ARoS-NCSU/WolfBot-Hardware/boards/power/webench_6V_LS3478.png

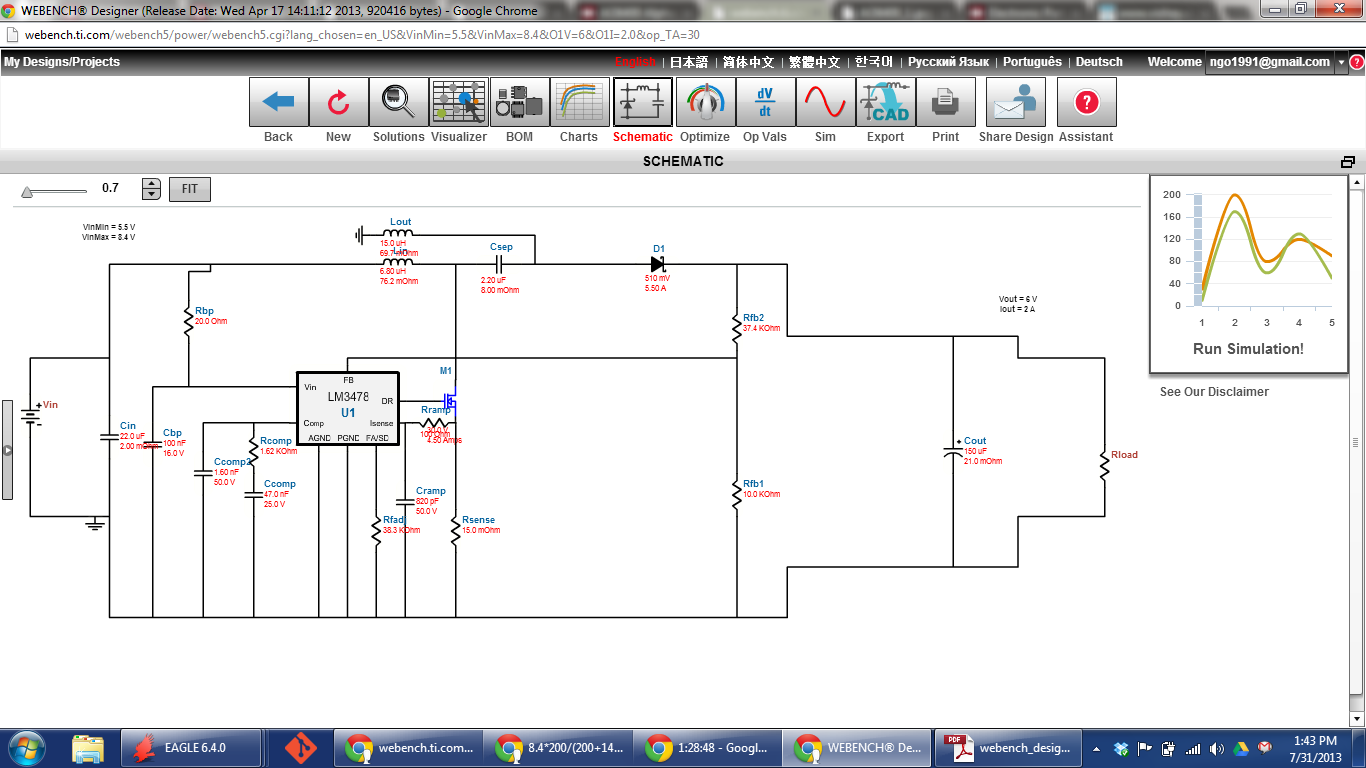
boards/power/webench_6V_LS3478.png
