ARoS-NCSU/WolfBot-Hardware/solidworks/Level 0/Robot Level 0 Assembly.SLDASM

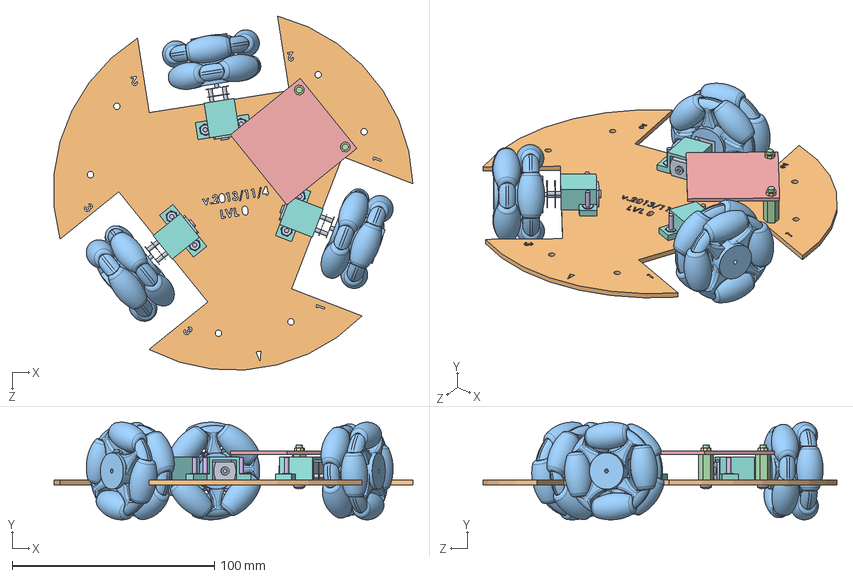
[picture p3: CAD file, 2013-11-22]
solidworks/Level 0/Robot Level 0 Assembly.SLDASM
177.4 x 48.3 x 174.9 mm
Drivetrain Motor x 3
Acrylic Base Type 0 - Level 0
Omnidirectional Wheel 1 x 3
Stand Off x 2
MotorBoard
pan cross head_ai x 8
Hex Nut x 2
Motor Bracket x 3
machine screw nut hex_ai x 6
