ARoS-NCSU/WolfBot-Hardware/solidworks/Level 1/Robot Level 1 Assembly.SLDASM

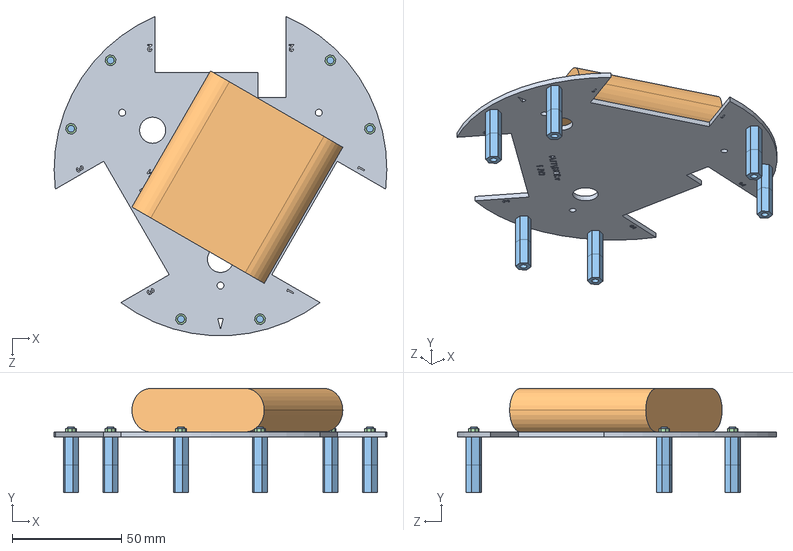
[picture p4: CAD file, 2013-11-22]
solidworks/Level 1/Robot Level 1 Assembly.SLDASM
152.4 x 47.8 x 146.1 mm
Acrylic Base Type 1 - Level 1
Battery
Stand Off x 12
Hex Nut x 6
