ARoS-NCSU/WolfBot-Hardware/solidworks/Level 2/DMS-Mount Assembly.SLDASM

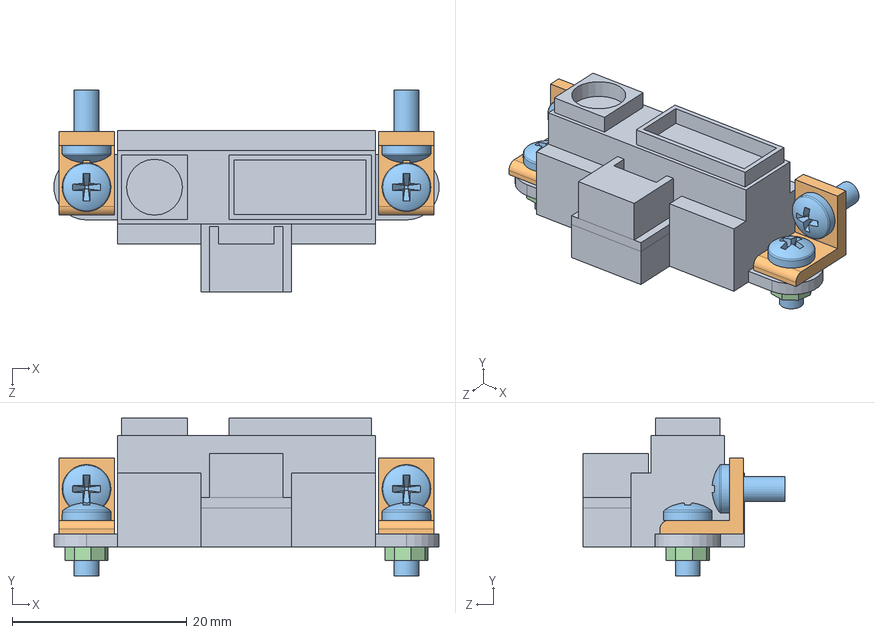
[picture p5: CAD file, 2013-11-22]
solidworks/Level 2/DMS-Mount Assembly.SLDASM
44.0 x 18.0 x 23.1 mm
DMS-80 IR
L-Bracket Mount x 2
pan cross head_ai x 4
Hex Nut x 2
