ARoS-NCSU/WolfBot-Hardware/solidworks/Robot Total Assembly.SLDASM

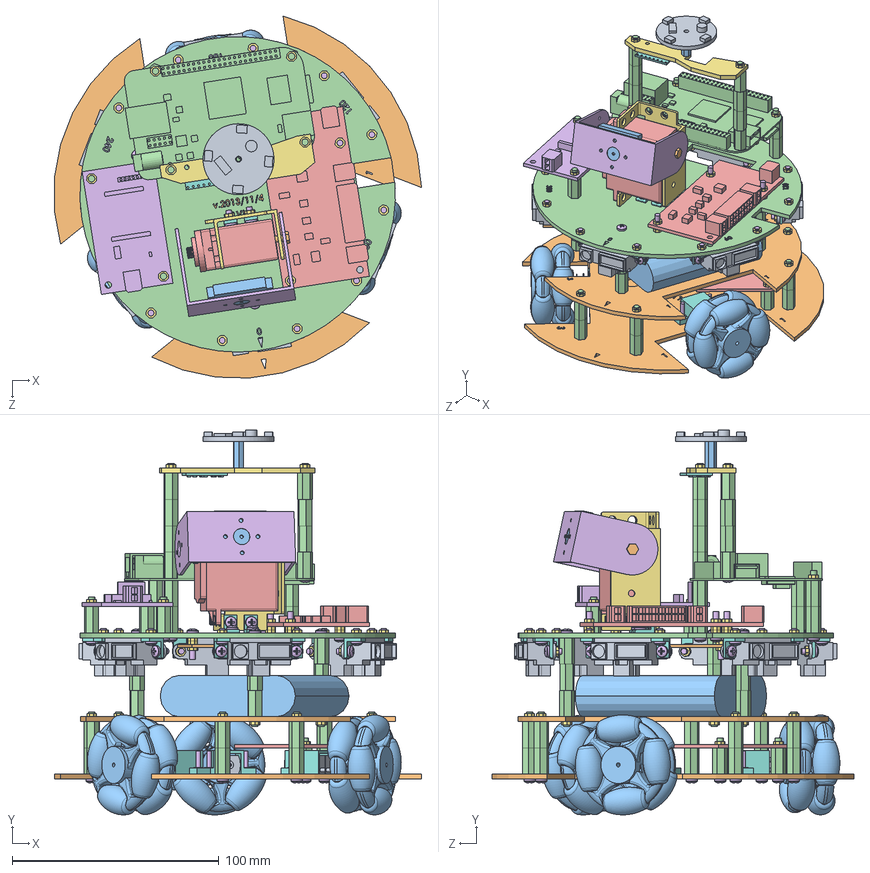
[picture p6: CAD file, 2013-11-22]
solidworks/Robot Total Assembly.SLDASM
177.4 x 185.9 x 174.9 mm
Drivetrain Motor x 3
Acrylic Base Type 0 - Level 0
Omnidirectional Wheel 1 x 3
Stand Off x 40
MotorBoard
pan cross head_ai x 56
Hex Nut x 60
Motor Bracket x 3
machine screw nut hex_ai x 6
Acrylic Base Type 1 - Level 1
Battery
Acrylic Base Type 1 - Level 2
Servo Motor
Servo Motor Assembly Part 1
Servo Motor Assembly Part 2
L-Bracket Mount x 14
DMS-80 IR x 6
Fastner
New_Camera
Beaglebone
Power Circuit Board
Xbee Base
Acrylic Base Type 2 - Level 2
3-axis accelerometer LSM303DLHC
New_IRSensor
DMS Board
Skinny Stand Off
