ARoS-NCSU/WolfBot-Hardware/solidworks/Level 2/Robot Level 2 Assembly.SLDASM

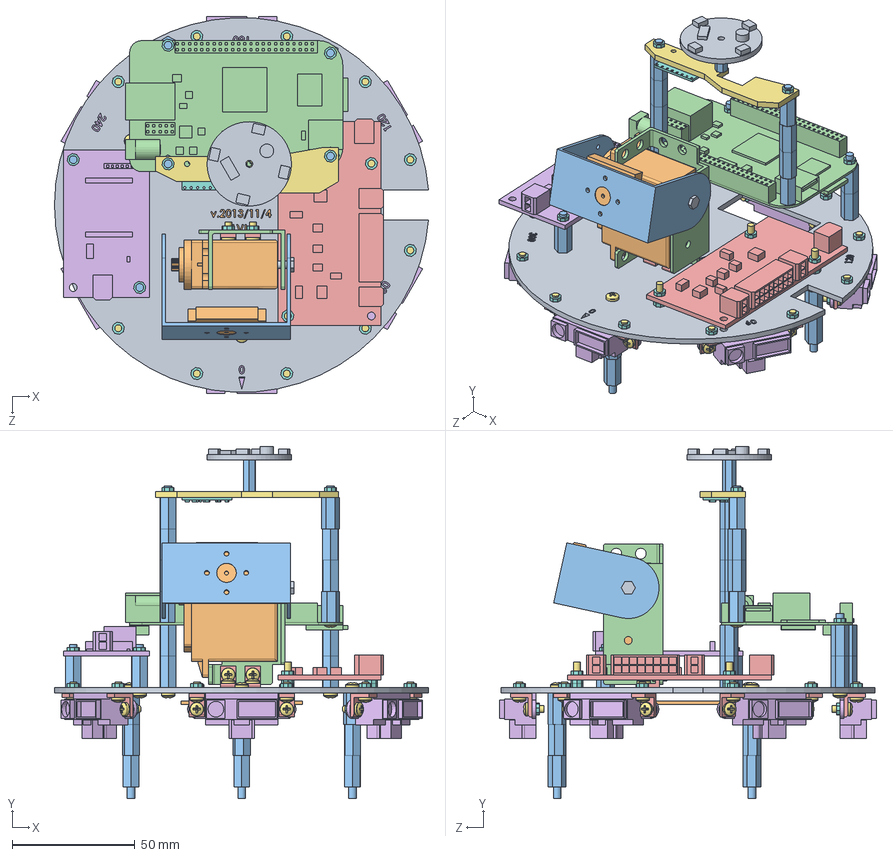
[picture p7: CAD file, 2013-11-22]
solidworks/Level 2/Robot Level 2 Assembly.SLDASM
152.2 x 143.2 x 153.3 mm
Acrylic Base Type 1 - Level 2
Servo Motor
Servo Motor Assembly Part 1
Servo Motor Assembly Part 2
L-Bracket Mount x 14
DMS-80 IR x 6
pan cross head_ai x 42
Hex Nut x 49
Fastner
New_Camera
Stand Off x 26
Beaglebone
Power Circuit Board
Xbee Base
Acrylic Base Type 2 - Level 2
3-axis accelerometer LSM303DLHC
New_IRSensor
DMS Board
Skinny Stand Off
