ARoS-NCSU/WolfBot-Hardware/solidworks/Level 2/Servo Motor Assembly Part 2.SLDPRT

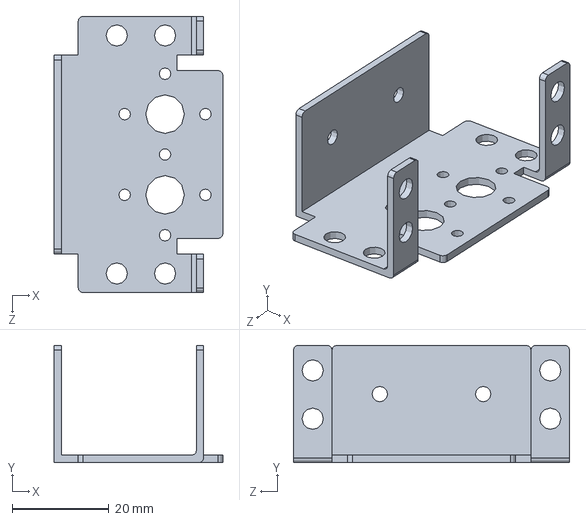
[picture p8: CAD file, 2013-11-14]
solidworks/Level 2/Servo Motor Assembly Part 2.SLDPRT
35.0 x 24.3 x 57.2 mm
