ARoS-NCSU/WolfBot-Hardware/solidworks/Level 2/Servo Motor Assembly Part 1.SLDPRT

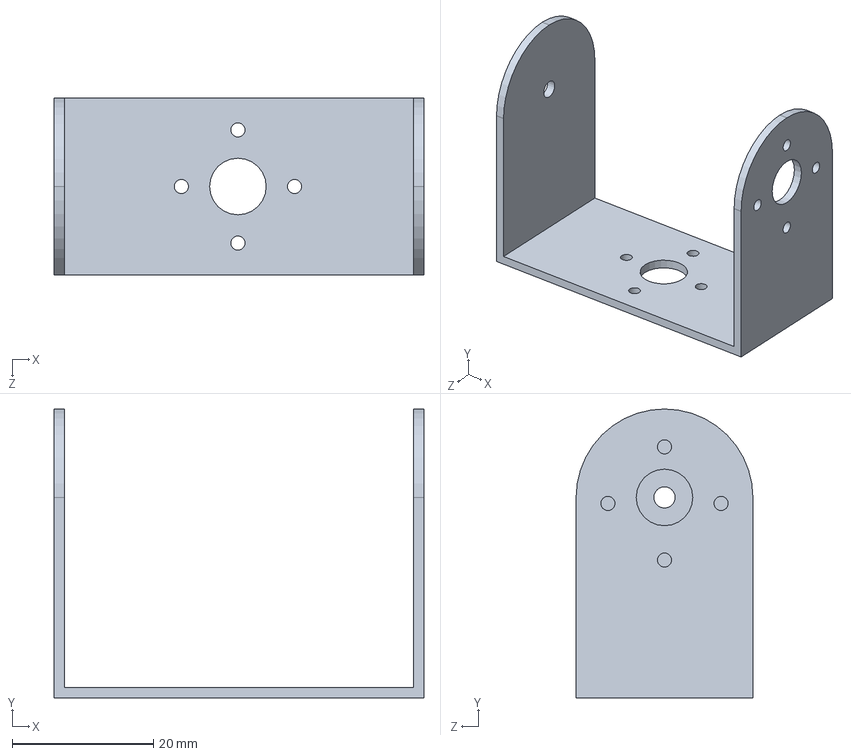
[picture p9: CAD file, 2013-11-14]
solidworks/Level 2/Servo Motor Assembly Part 1.SLDPRT
52.3 x 40.8 x 25.0 mm
