ARoS-NCSU/WolfBot-Hardware/solidworks/Common Parts/Skinny Stand Off.SLDPRT

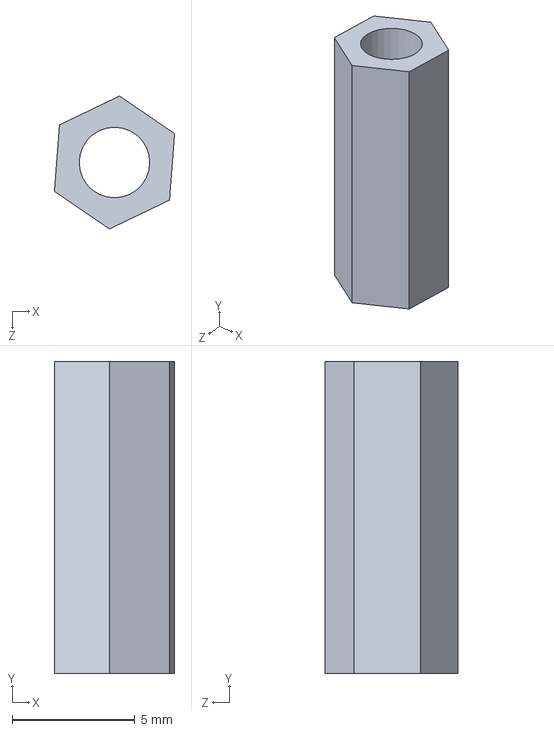
[picture p10: CAD file, 2013-11-22]
solidworks/Common Parts/Skinny Stand Off.SLDPRT
4.89 x 12.7 x 5.41 mm
