ARoS-NCSU/WolfBot-Hardware/solidworks/Level 0/Motor Bracket.SLDPRT

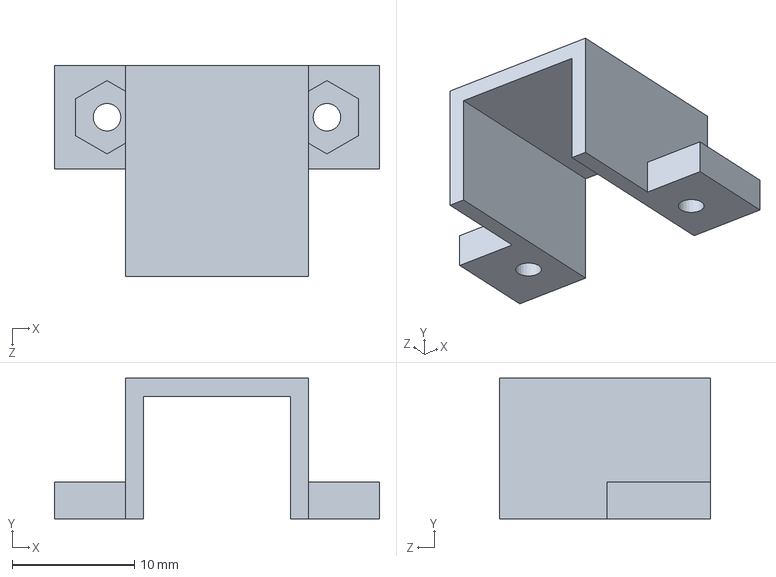
[picture p11: CAD file, 2013-11-22]
solidworks/Level 0/Motor Bracket.SLDPRT
26.6 x 11.5 x 17.3 mm
