ARoS-NCSU/WolfBot-Hardware/solidworks/Level 1/Battery.SLDPRT

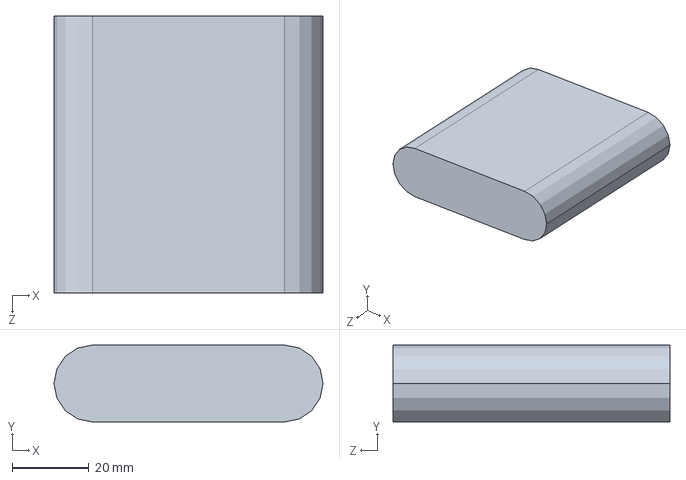
[picture p12: CAD file, 2013-11-14]
solidworks/Level 1/Battery.SLDPRT
70.0 x 20.0 x 72.0 mm
