ARoS-NCSU/WolfBot-Hardware/solidworks/Common Parts/Stand Off.SLDPRT

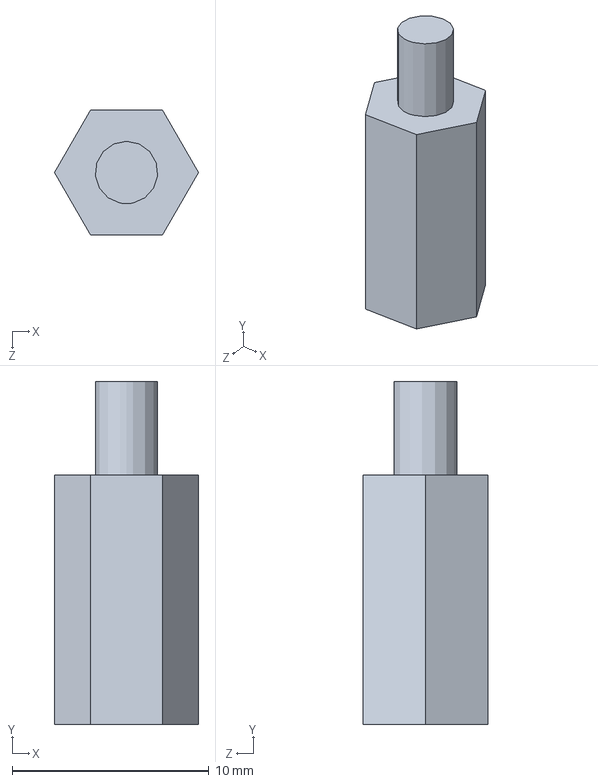
[picture p13: CAD file, 2013-11-14]
solidworks/Common Parts/Stand Off.SLDPRT
7.33 x 17.4 x 6.35 mm
