ARoS-NCSU/WolfBot-Hardware/solidworks/Level 1/Acrylic Base Type 1 - Level 1.SLDPRT

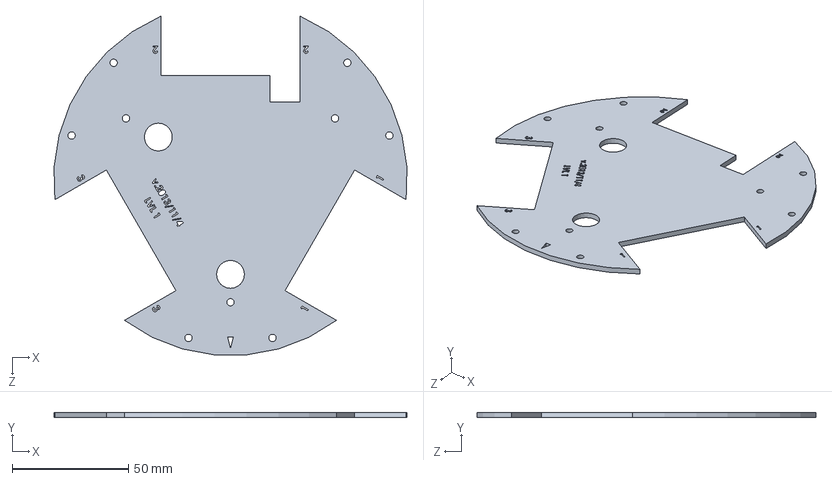
[picture p15: CAD file, 2013-11-14]
solidworks/Level 1/Acrylic Base Type 1 - Level 1.SLDPRT
152.1 x 2.36 x 145.9 mm
