ARoS-NCSU/WolfBot-Hardware/solidworks/Level 2/New_IRSensor.SLDPRT

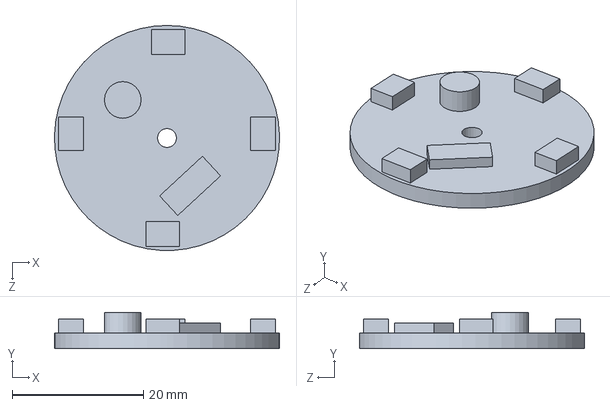
[picture p16: CAD file, 2013-11-14]
solidworks/Level 2/New_IRSensor.SLDPRT
34.3 x 5.56 x 34.3 mm
