ARoS-NCSU/WolfBot-Hardware/solidworks/Common Parts/Stand Off - Level 2 Lower.SLDPRT

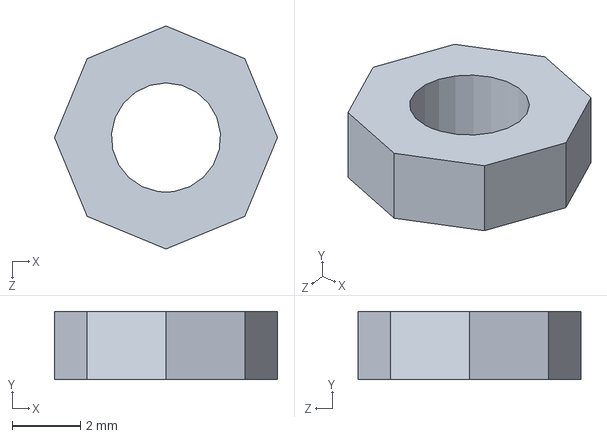
[picture p17: CAD file, 2013-11-14]
solidworks/Common Parts/Stand Off - Level 2 Lower.SLDPRT
6.53 x 2.00 x 6.53 mm
