ARoS-NCSU/WolfBot-Hardware/solidworks/Level 0/MotorBoard.SLDPRT

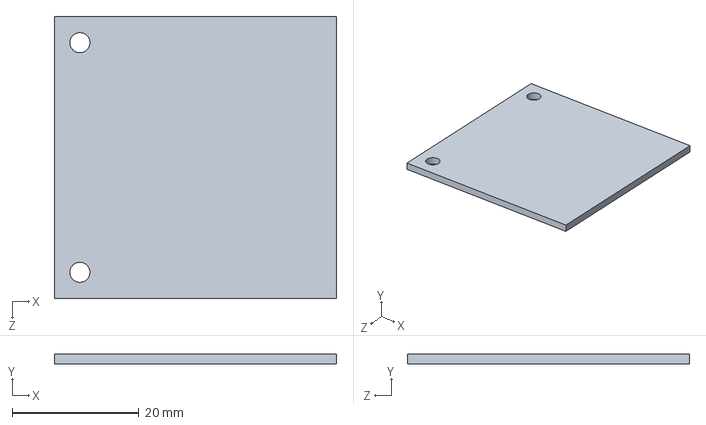
[picture p18: CAD file, 2013-11-14]
solidworks/Level 0/MotorBoard.SLDPRT
44.5 x 1.60 x 44.5 mm
