ARoS-NCSU/WolfBot-Hardware/solidworks/Level 2/DMS-80 IR.SLDPRT

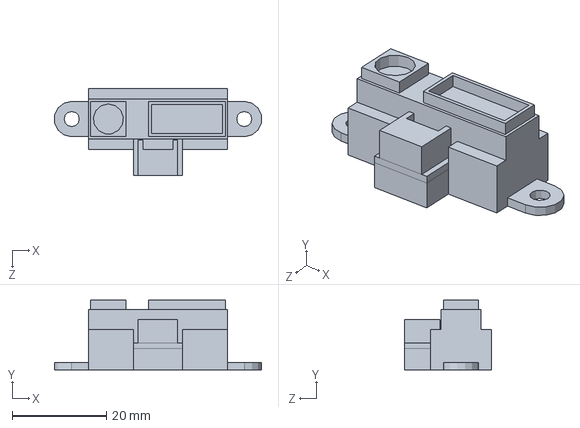
[picture p19: CAD file, 2013-11-14]
solidworks/Level 2/DMS-80 IR.SLDPRT
43.9 x 14.8 x 18.5 mm
