ARoS-NCSU/WolfBot-Hardware/solidworks/Common Parts/Stand Off - Level 2 Upper.SLDPRT

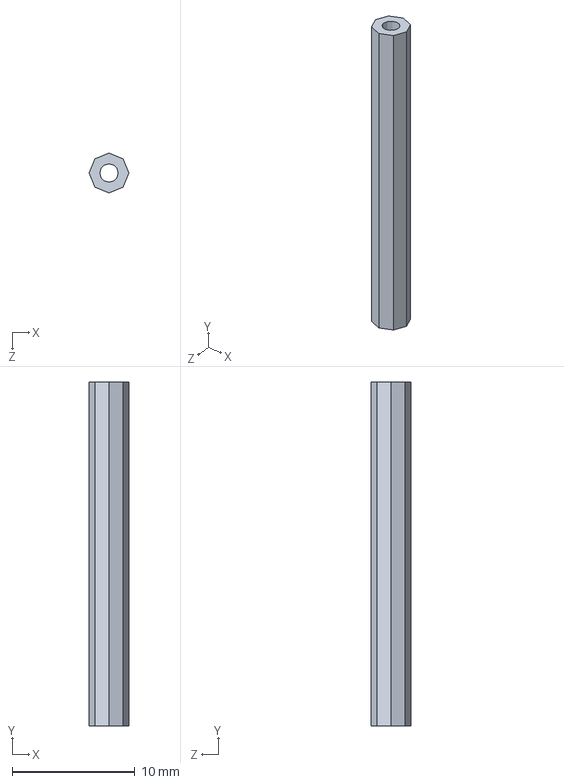
[picture p20: CAD file, 2013-11-14]
solidworks/Common Parts/Stand Off - Level 2 Upper.SLDPRT
3.25 x 28.0 x 3.25 mm
