ARoS-NCSU/WolfBot-Hardware/solidworks/Level 0/Drivetrain Motor.SLDPRT

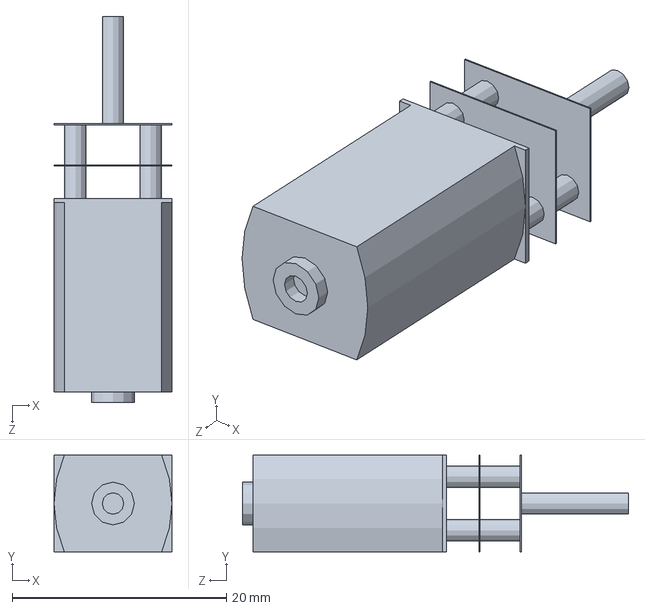
[picture p21: CAD file, 2013-11-14]
solidworks/Level 0/Drivetrain Motor.SLDPRT
11.0 x 9.00 x 36.0 mm
