ARoS-NCSU/WolfBot-Hardware/solidworks/Level 2/DistanceSensorMount.SLDPRT

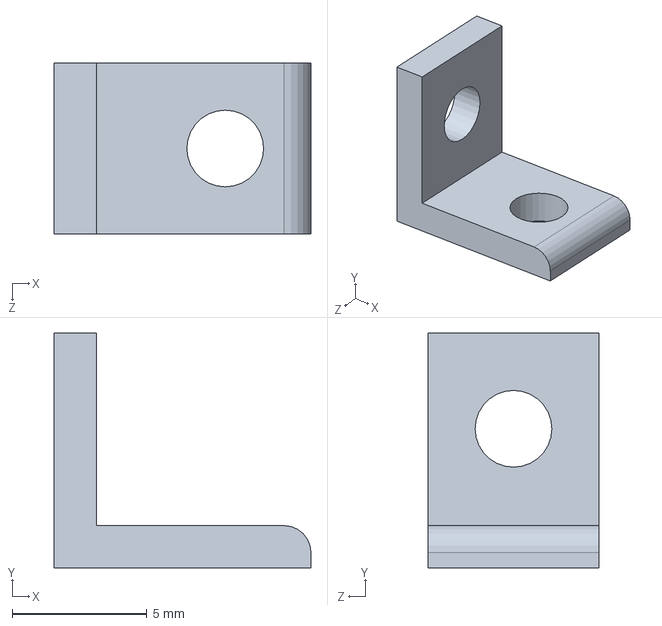
[picture p22: CAD file, 2013-11-14]
solidworks/Level 2/DistanceSensorMount.SLDPRT
9.53 x 8.71 x 6.35 mm
