ARoS-NCSU/WolfBot-Hardware/solidworks/Common Parts/Stand Off - Level 2 Upper - Xbee.SLDPRT

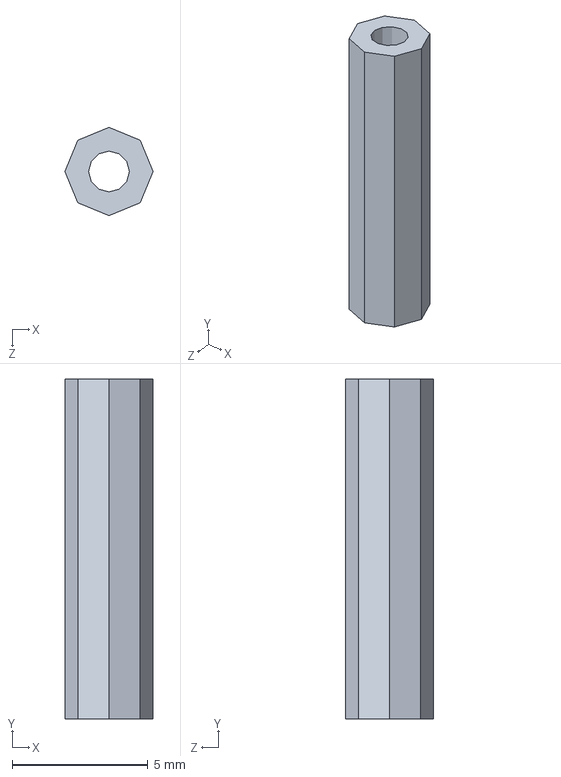
[picture p23: CAD file, 2013-11-14]
solidworks/Common Parts/Stand Off - Level 2 Upper - Xbee.SLDPRT
3.25 x 12.5 x 3.25 mm
