ARoS-NCSU/WolfBot-Hardware/solidworks/Level 0/Omnidirectional Wheel 1.SLDPRT

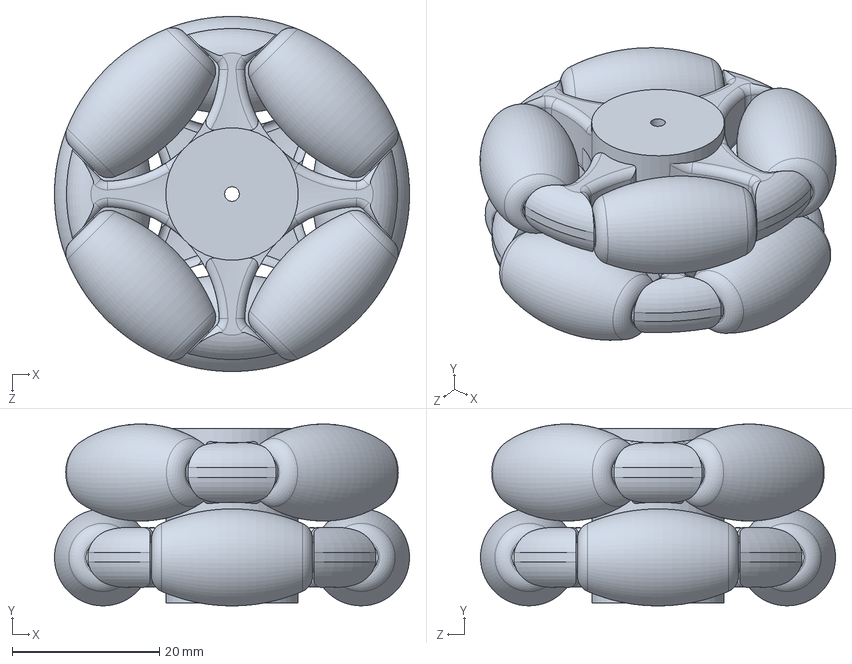
[picture p24: CAD file, 2013-11-14]
solidworks/Level 0/Omnidirectional Wheel 1.SLDPRT
48.3 x 24.7 x 48.3 mm
