ARoS-NCSU/WolfBot-Hardware/solidworks/Level 2/Fastner.SLDPRT

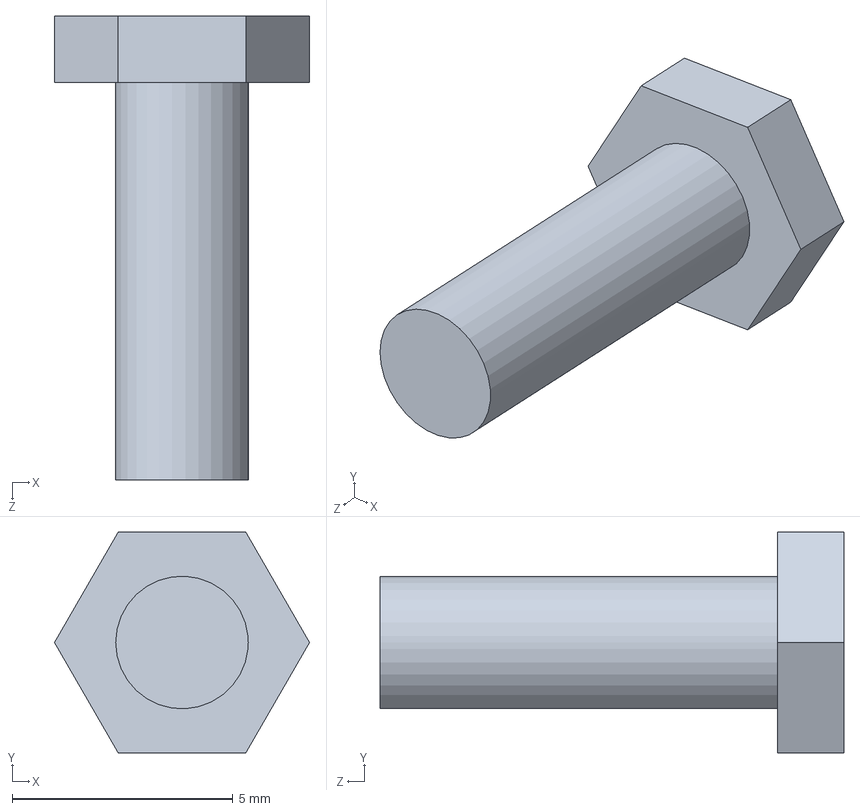
[picture p25: CAD file, 2013-11-14]
solidworks/Level 2/Fastner.SLDPRT
5.77 x 5.00 x 10.5 mm
