ARoS-NCSU/WolfBot-Hardware/solidworks/Level 2/Acrylic Base Type 2 - Level 2.SLDPRT

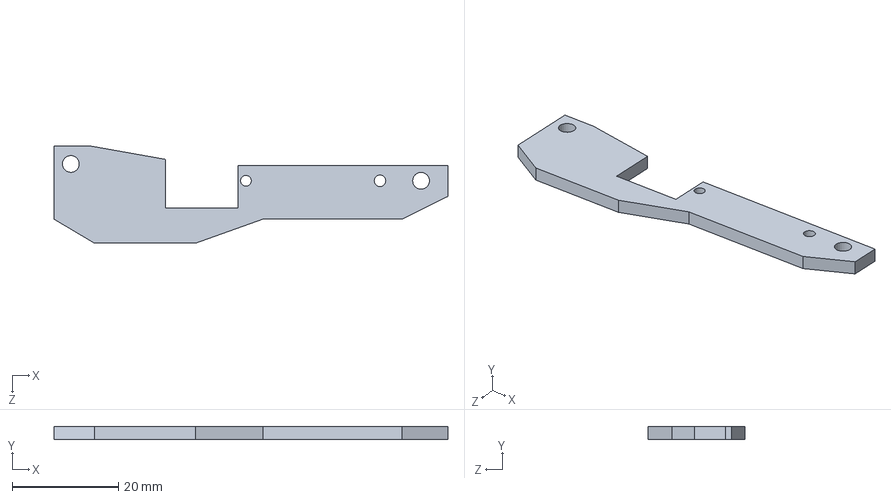
[picture p26: CAD file, 2013-11-14]
solidworks/Level 2/Acrylic Base Type 2 - Level 2.SLDPRT
74.3 x 2.54 x 18.4 mm
