ARoS-NCSU/WolfBot-Hardware/solidworks/Level 0/Acrylic Base Type 0 - Level 0 Burn 7_16_13.SLDPRT

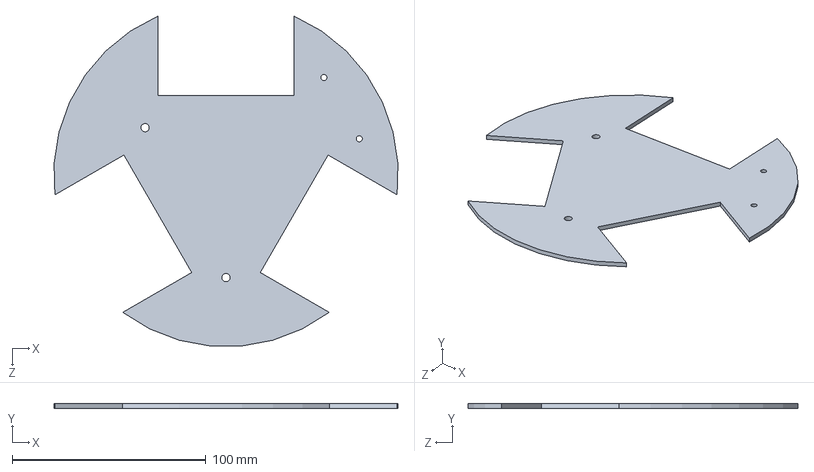
[picture p27: CAD file, 2013-11-14]
solidworks/Level 0/Acrylic Base Type 0 - Level 0 Burn 7_16_13.SLDPRT
177.4 x 2.36 x 170.2 mm
