ARoS-NCSU/WolfBot-Hardware/solidworks/Level 2/Servo Motor.SLDPRT

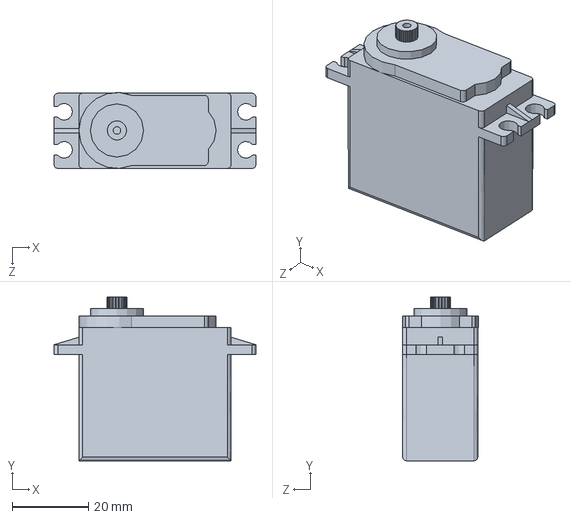
[picture p28: CAD file, 2013-11-14]
solidworks/Level 2/Servo Motor.SLDPRT
53.1 x 43.0 x 20.0 mm
