ARoS-NCSU/WolfBot-Hardware/solidworks/Level 0/Omnidirectional Wheel.SLDPRT

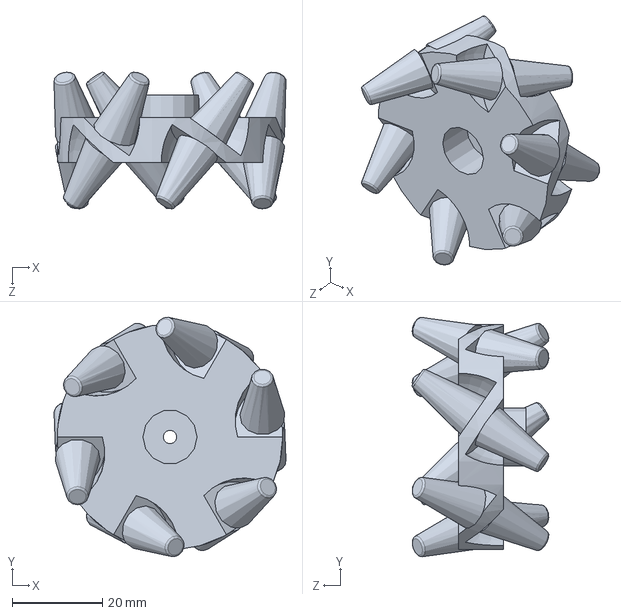
[picture p29: CAD file, 2013-11-14]
solidworks/Level 0/Omnidirectional Wheel.SLDPRT
51.4 x 53.1 x 30.3 mm
