ARoS-NCSU/WolfBot-Hardware/solidworks/Level 2/DMS Board.SLDPRT

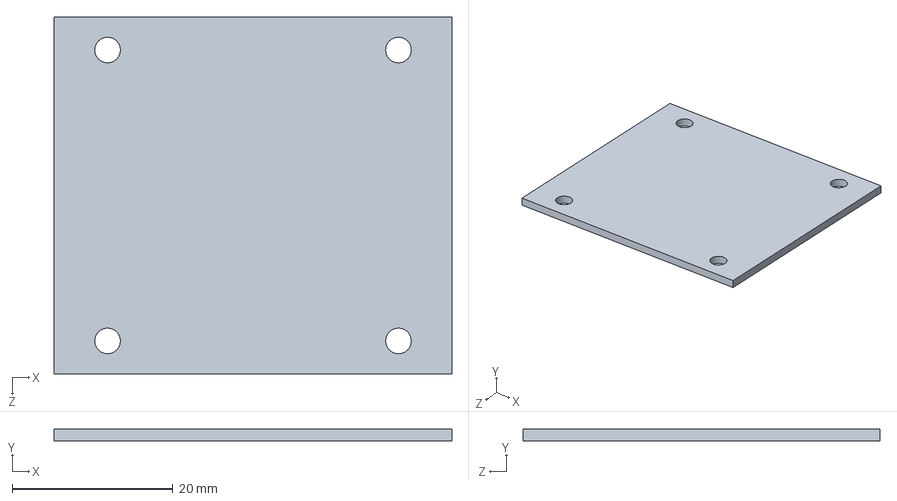
[picture p30: CAD file, 2013-11-14]
solidworks/Level 2/DMS Board.SLDPRT
49.5 x 1.50 x 44.5 mm
