ARoS-NCSU/WolfBot-Hardware/solidworks/Level 2/XBee 802.15.4 modules.SLDPRT

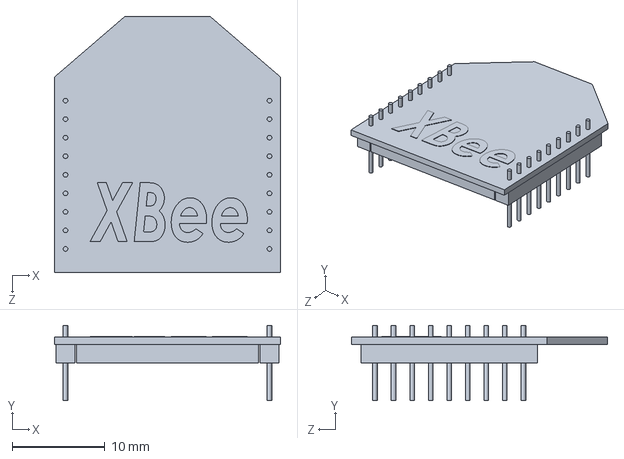
[picture p31: CAD file, 2013-11-14]
solidworks/Level 2/XBee 802.15.4 modules.SLDPRT
24.4 x 8.12 x 27.6 mm
