ARoS-NCSU/WolfBot-Hardware/solidworks/Level 2/Acrylic Base Type 1 - Level 2.SLDPRT

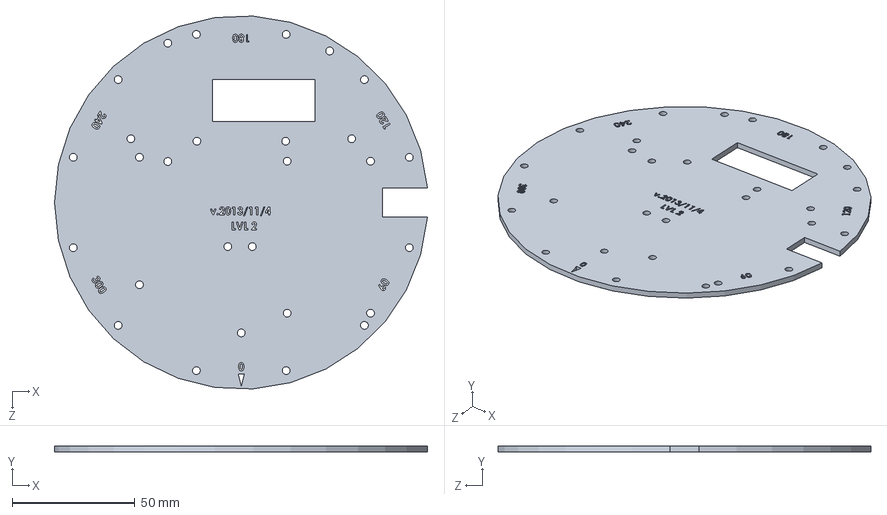
[picture p32: CAD file, 2013-11-14]
solidworks/Level 2/Acrylic Base Type 1 - Level 2.SLDPRT
152.2 x 2.36 x 152.1 mm
