ARoS-NCSU/WolfBot-Hardware/solidworks/Level 2/Beaglebone.SLDPRT

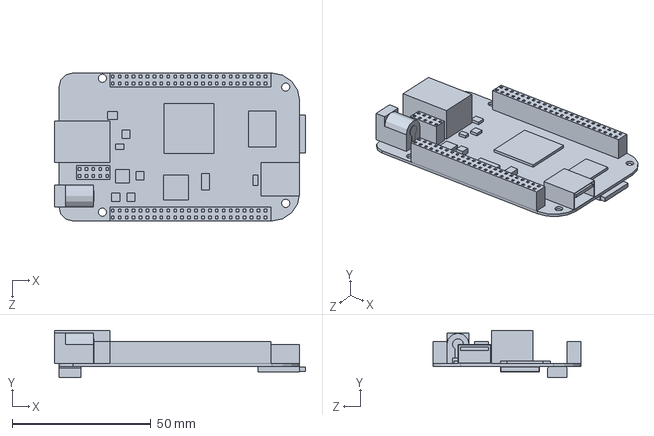
[picture p33: CAD file, 2013-11-14]
solidworks/Level 2/Beaglebone.SLDPRT
90.5 x 17.0 x 53.3 mm
