ARoS-NCSU/WolfBot-Hardware/solidworks/Level 2/3-axis accelerometer LSM303DLHC.SLDPRT

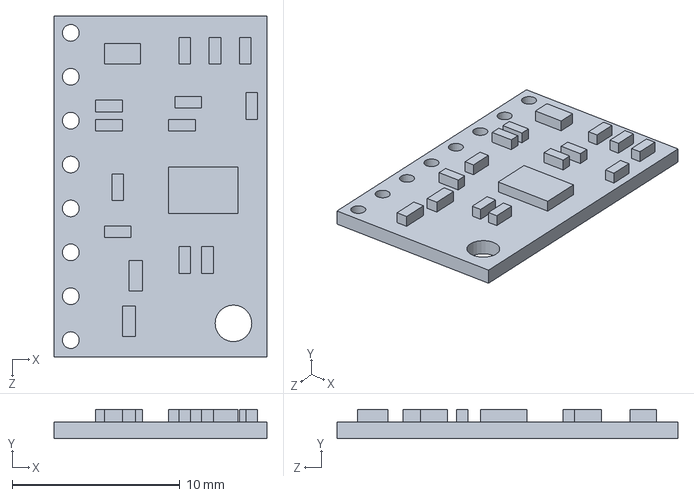
[picture p34: CAD file, 2013-11-14]
solidworks/Level 2/3-axis accelerometer LSM303DLHC.SLDPRT
12.7 x 1.75 x 20.3 mm
