ARoS-NCSU/WolfBot-Hardware/solidworks/Level 2/Xbee Base.SLDPRT

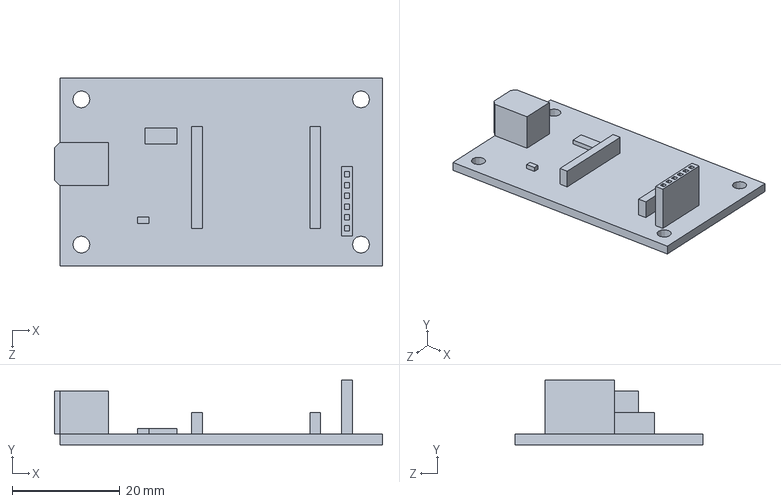
[picture p35: CAD file, 2013-11-14]
solidworks/Level 2/Xbee Base.SLDPRT
61.0 x 12.0 x 35.0 mm
