ARoS-NCSU/WolfBot-Hardware/solidworks/Level 2/New_Camera.SLDPRT

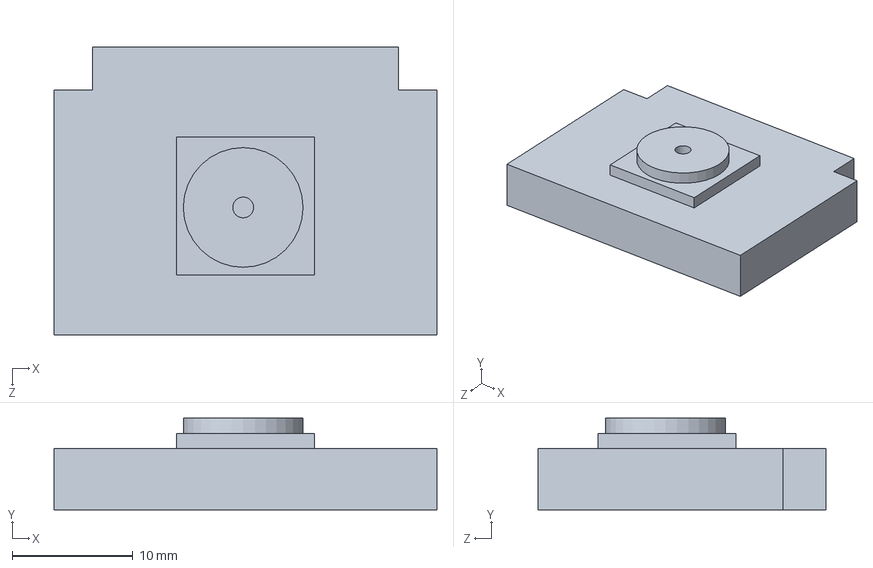
[picture p36: CAD file, 2013-11-14]
solidworks/Level 2/New_Camera.SLDPRT
31.8 x 7.62 x 23.9 mm
