ARoS-NCSU/WolfBot-Hardware/solidworks/Level 2/Power Circuit Board.SLDPRT

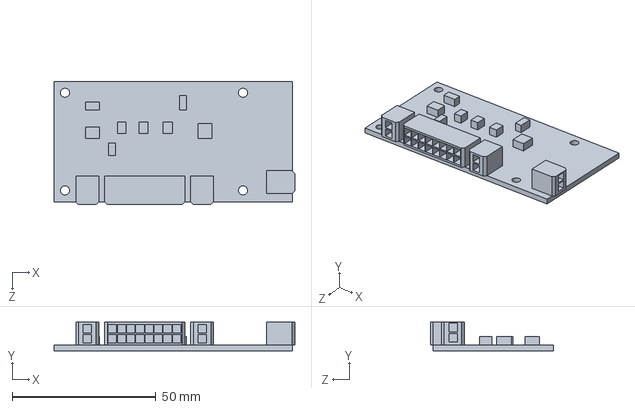
[picture p37: CAD file, 2013-11-14]
solidworks/Level 2/Power Circuit Board.SLDPRT
83.9 x 10.0 x 43.0 mm
