ARoS-NCSU/WolfBot-Hardware/solidworks/Level 2/Acrylic Base Type 1 - Level 2 - Circle Test Burn 7_16_13.SLDPRT

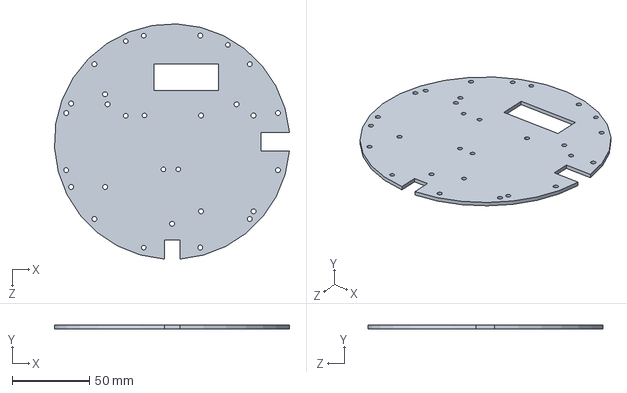
[picture p38: CAD file, 2013-11-14]
solidworks/Level 2/Acrylic Base Type 1 - Level 2 - Circle Test Burn 7_16_13.SLDPRT
152.1 x 2.36 x 152.2 mm
