ARoS-NCSU/WolfBot-Hardware/solidworks/Level 2/Acrylic Base Type 2 - Xbee Mount Burn.SLDPRT

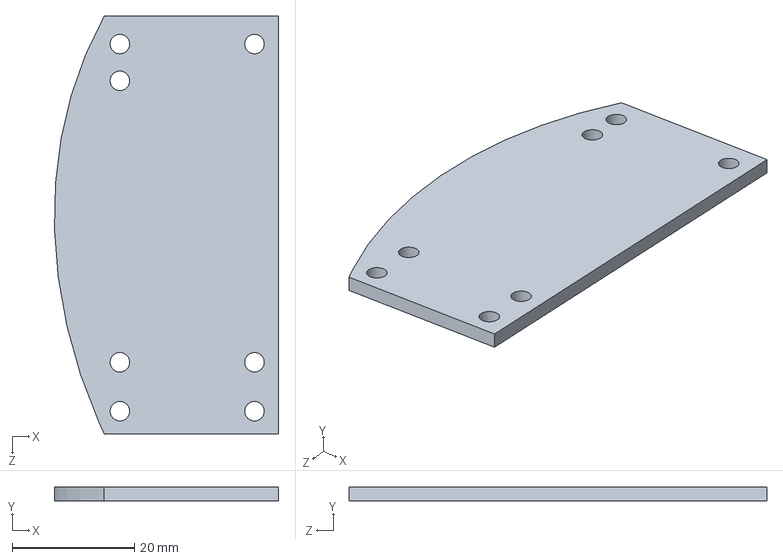
[picture p39: CAD file, 2013-11-14]
solidworks/Level 2/Acrylic Base Type 2 - Xbee Mount Burn.SLDPRT
36.6 x 2.36 x 68.3 mm
