ARoS-NCSU/WolfBot-Hardware/solidworks/Level 2/LogicConverter.SLDPRT

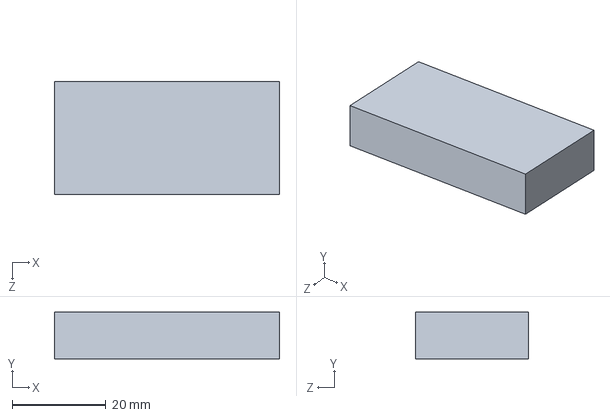
[picture p40: CAD file, 2013-11-14]
solidworks/Level 2/LogicConverter.SLDPRT
48.0 x 10.0 x 24.0 mm
