ARoS-NCSU/WolfBot-Hardware/solidworks/Level 2/Light Sensor.SLDPRT

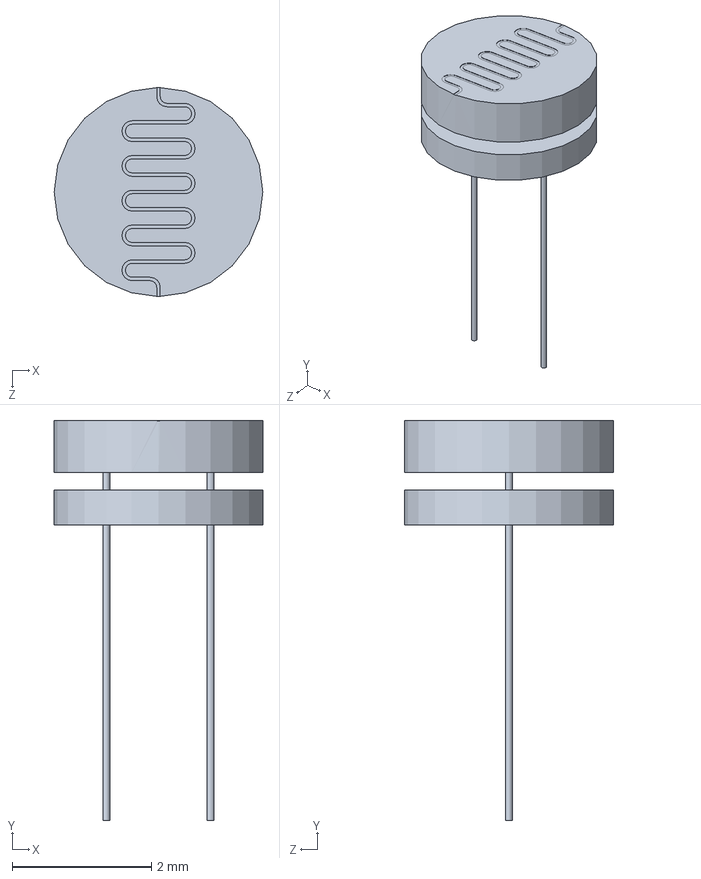
[picture p41: CAD file, 2013-11-14]
solidworks/Level 2/Light Sensor.SLDPRT
3.00 x 5.75 x 3.00 mm
