ARoS-NCSU/WolfBot-Hardware/(list of files, cad)

Other CAD files:
solidworks/Level 1/Acrylic Base Type 1 - Level 1 Burn FINAL.SLDPRT
solidworks/Level 0/Motor (Wheel).SLDPRT
solidworks/Level 2/L-Bracket Mount.SLDPRT
solidworks/Level 2/Acrylic Base Type 2 - IR Mount Burn FINAL.SLDPRT
solidworks/Common Parts/Hex Nut.SLDPRT
