ARoS-NCSU/WolfBot-Hardware/boards/power/webench_design_33Volt_step.pdf

## WEBENCH ® Design Report

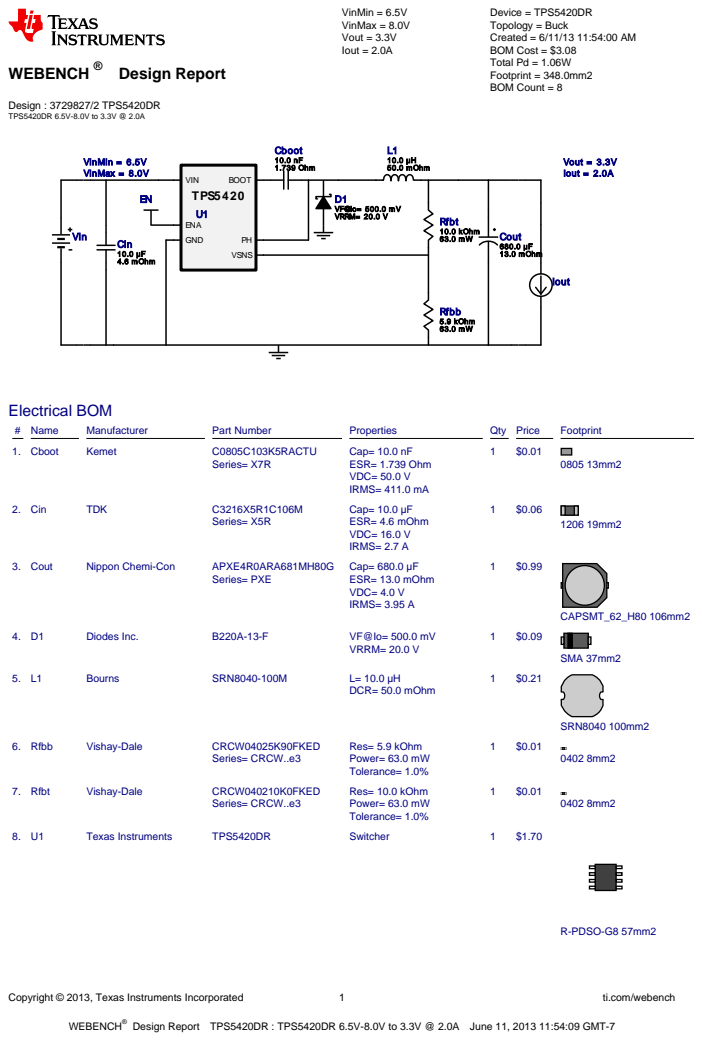
[picture p42: page 1]
Copyright © 2013, Texas Instruments Incorporated; ti.com/webench; WEBENCH®; Design : 3729827/2 TPS5420DR TPS5420DR 6.5V-8.0V to 3.3V @ 2.0A; VinMin = 6.5V VinMax = 8.0V Vout = 3.3V Iout = 2.0A; Device = TPS5420DR Topology = Buck Created = 6/11/13 11:54:00 AM BOM Cost = $3.08 Total Pd = 1.06W Footprint = 348.0mm2 BOM Count = 8; Cboot 10.0 nF 1.739 Ohm; Cin 10.0 µF 4.6 mOhm; Cout 680.0 µF 13.0 mOhm; D1 VF@Io= 500.0 mV VRRM= 20.0 V; L1 10.0 µH 50.0 mOhm; Rfbb 5.9 kOhm 63.0 mW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

Design Report TPS5420DR : TPS5420DR 6.5V-8.0V to 3.3V @ 2.0A June 11, 2013 11:54:09 GMT-7

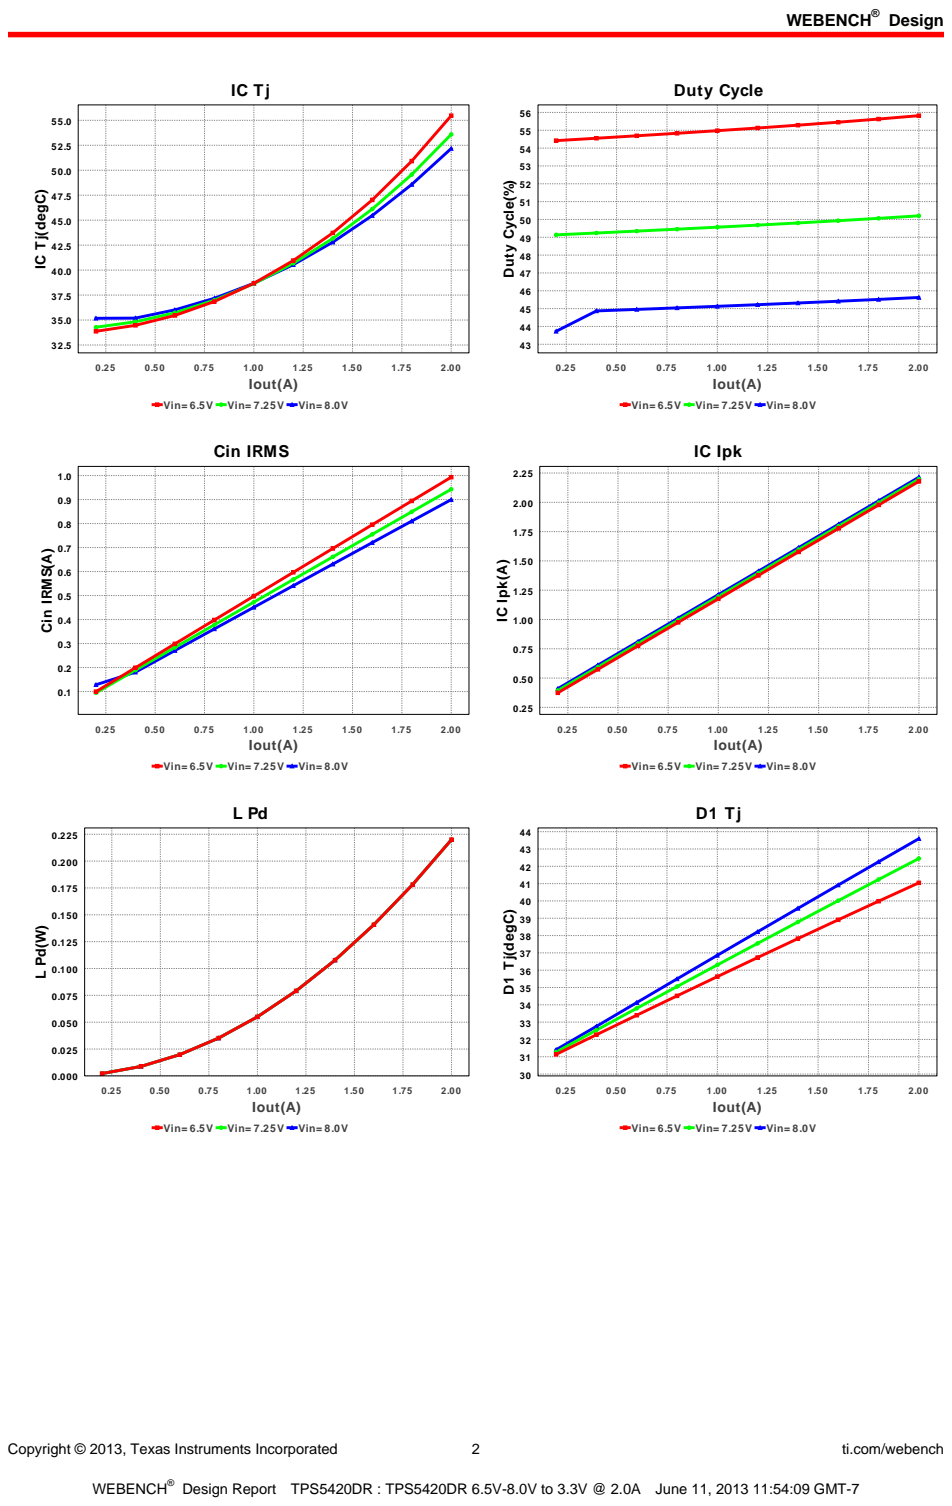
[picture p43: page 2]
Design; Copyright © 2013, Texas Instruments Incorporated; ti.com/webench; Iout(A); Duty Cycle; Duty Cycle(%); Cin IRMS; Cin IRMS(A); IC Ipk; IC Ipk(A); D1 Tj(degC)

IC Tj(degC)

Vin= 6.5V Vin= 7.25V Vin= 8.0V

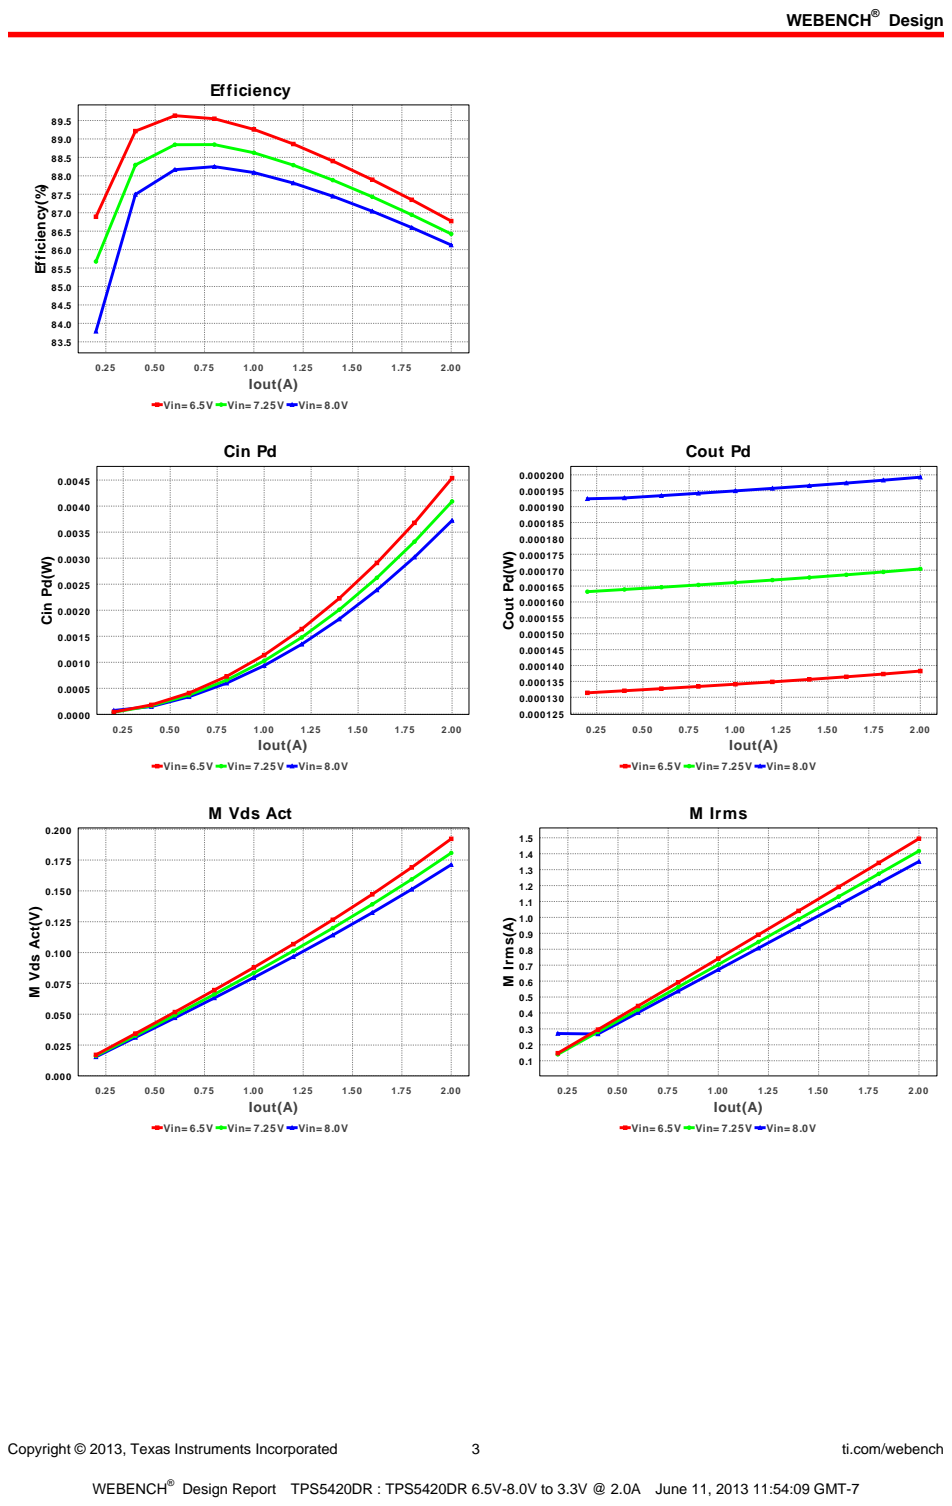
[picture p44: page 3]
Copyright © 2013, Texas Instruments Incorporated; ti.com/webench; Efficiency; Iout(A); Efficiency(%); Cin Pd; Cin Pd(W); Cout Pd; Cout Pd(W); M Vds Act; M Vds Act(V); M Irms; M Irms(A)

Vin= 6.5V Vin= 7.25V Vin= 8.0V

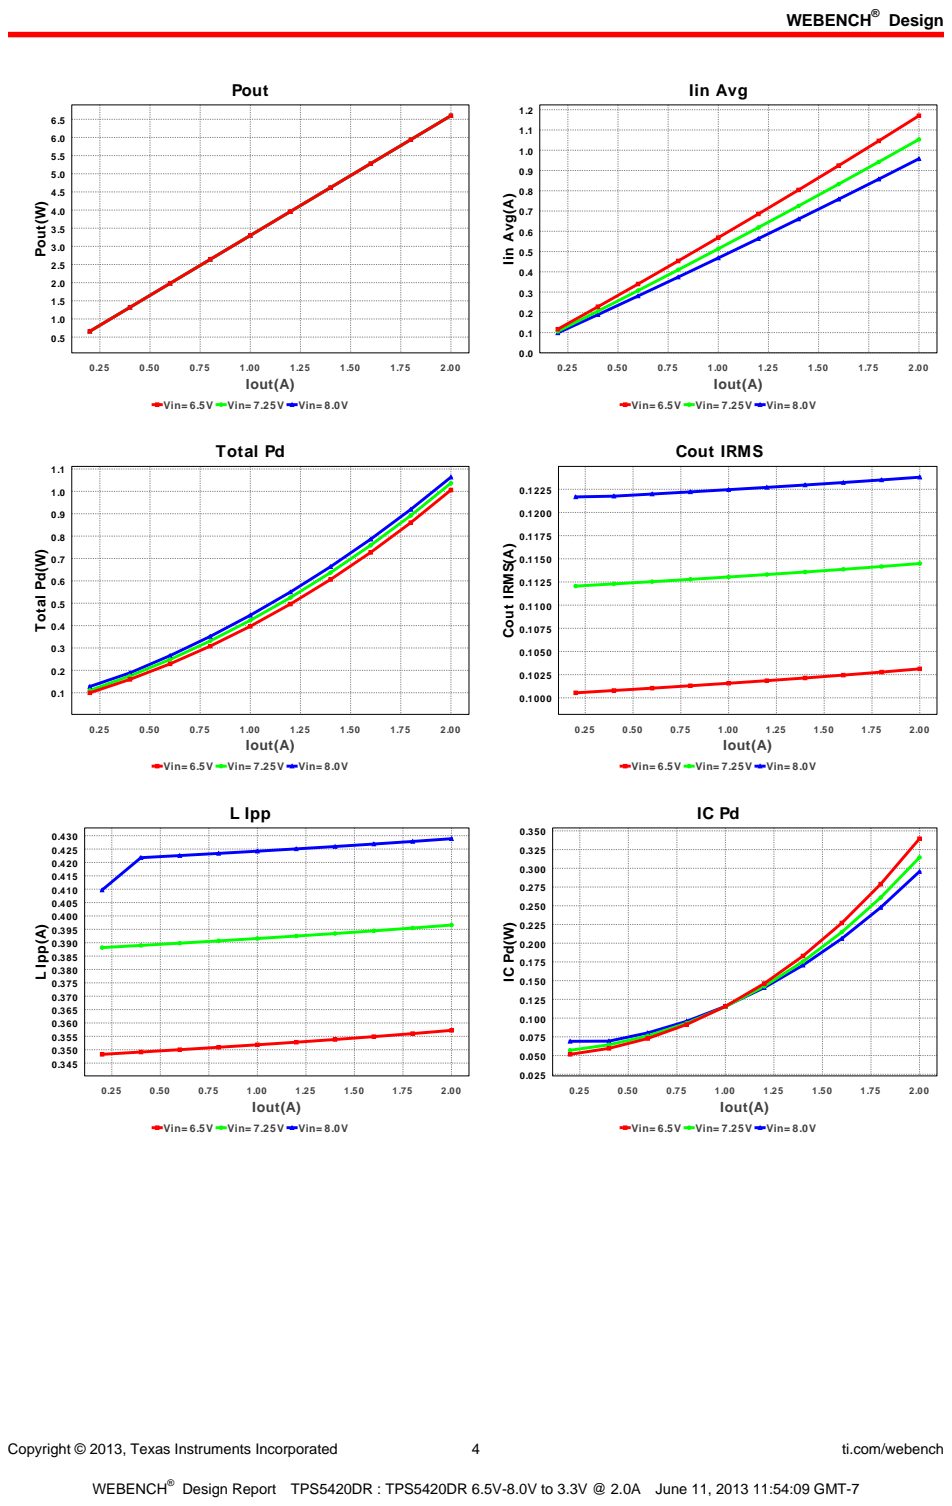
[picture p45: page 4]
Copyright © 2013, Texas Instruments Incorporated; ti.com/webench; Pout; Iout(A); Pout(W); Iin Avg; Iin Avg(A); Total Pd; Total Pd(W); Cout IRMS; Cout IRMS(A); L Ipp; L Ipp(A)

Vin= 6.5V Vin= 7.25V Vin= 8.0V

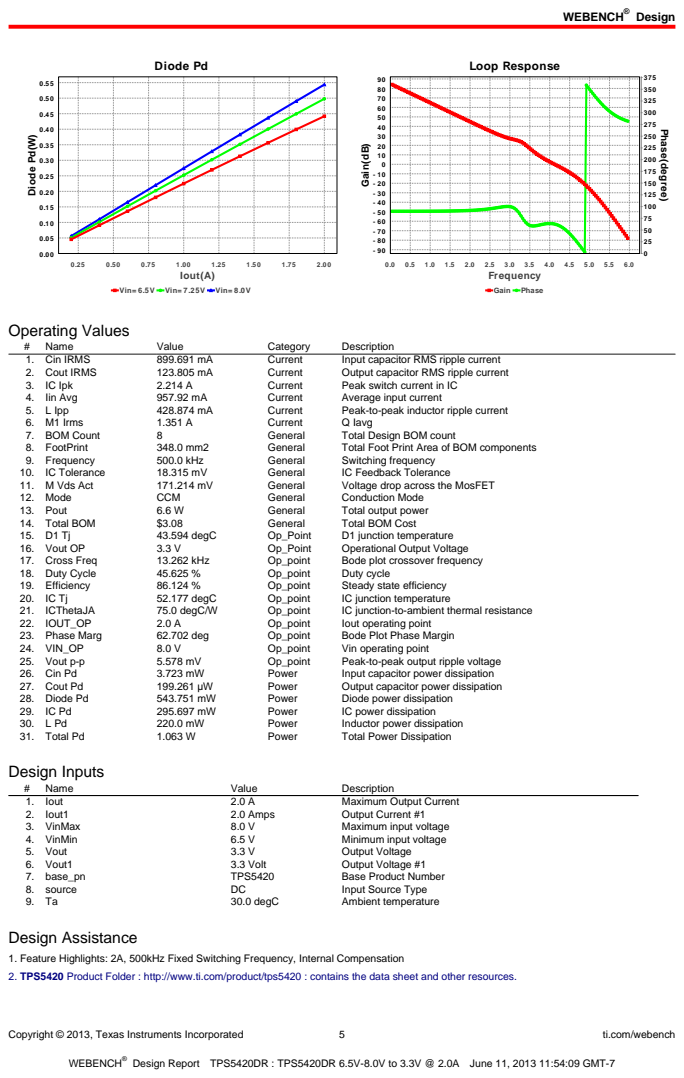
[picture p46: page 5]
Copyright © 2013, Texas Instruments Incorporated; ti.com/webench; Diode Pd; Iout(A); Diode Pd(W); Loop Response; Gain Phase; 6.0 Frequency; Gain(dB); Phase(degree); Operating Values; Name; Value; Category; Description; 1. Cin IRMS; Current; Input capacitor RMS ripple current; 2. Cout IRMS; Output capacitor RMS ripple current; 3. IC Ipk; Peak switch current in IC; 4. Iin Avg; Average input current; 5. L Ipp; Peak-to-peak inductor ripple current; 6. M1 Irms; Q Iavg; 7. BOM Count; General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

Vin= 6.5V Vin= 7.25V Vin= 8.0V

1. Feature Highlights: 2A, 500kHz Fixed Switching Frequency, Internal Compensation
2. TPS5420 Product Folder : http://www.ti.com/product/tps5420 : contains the data sheet and other resources.

Copyright © 2013, Texas Instruments Incorporated | 6 | ti.com/webench

Texas Instruments' WEBENCH simulation tools attempt to recreate the performance of a substantially equivalent physical implementation
of the design. Simulations are created using Texas Instruments' published specifications as well as the published specifications of other device manufacturers. While Texas Instruments does update this information periodically, this information may not be current at the time the simulation is built. Texas Instruments does not warrant the accuracy or completeness of the specifications or any information contained therein. Texas Instruments does not warrant that any designs or recommended parts will meet the specifications you entered, will be suitable for your application or fit for any particular purpose, or will operate as shown in the simulation in a physical implementation. Texas Instruments does not warrant that the designs are production worthy.
You should completely validate and test your design implementation to confirm the system functionality for your application prior to production.
Use of Texas Instruments' WEBENCH simulation tools is subject to Texas Instruments' Site Terms and Conditions of Use. (http://www.ti.com/corp/docs/legal/termsofuse.shtml) Prototype boards based on WEBENCH created designs are provided AS IS without warranty of any kind for evaluation and testing purposes and are subject to the terms of the Evaluation License Agreement. (http://www.ti.com/corp/docs/legal/termsofuse_estore.shtml)
