ARoS-NCSU/WolfBot-Hardware/boards/power/webench_design_12Volt_boost.pdf

## WEBENCH ® Design Report

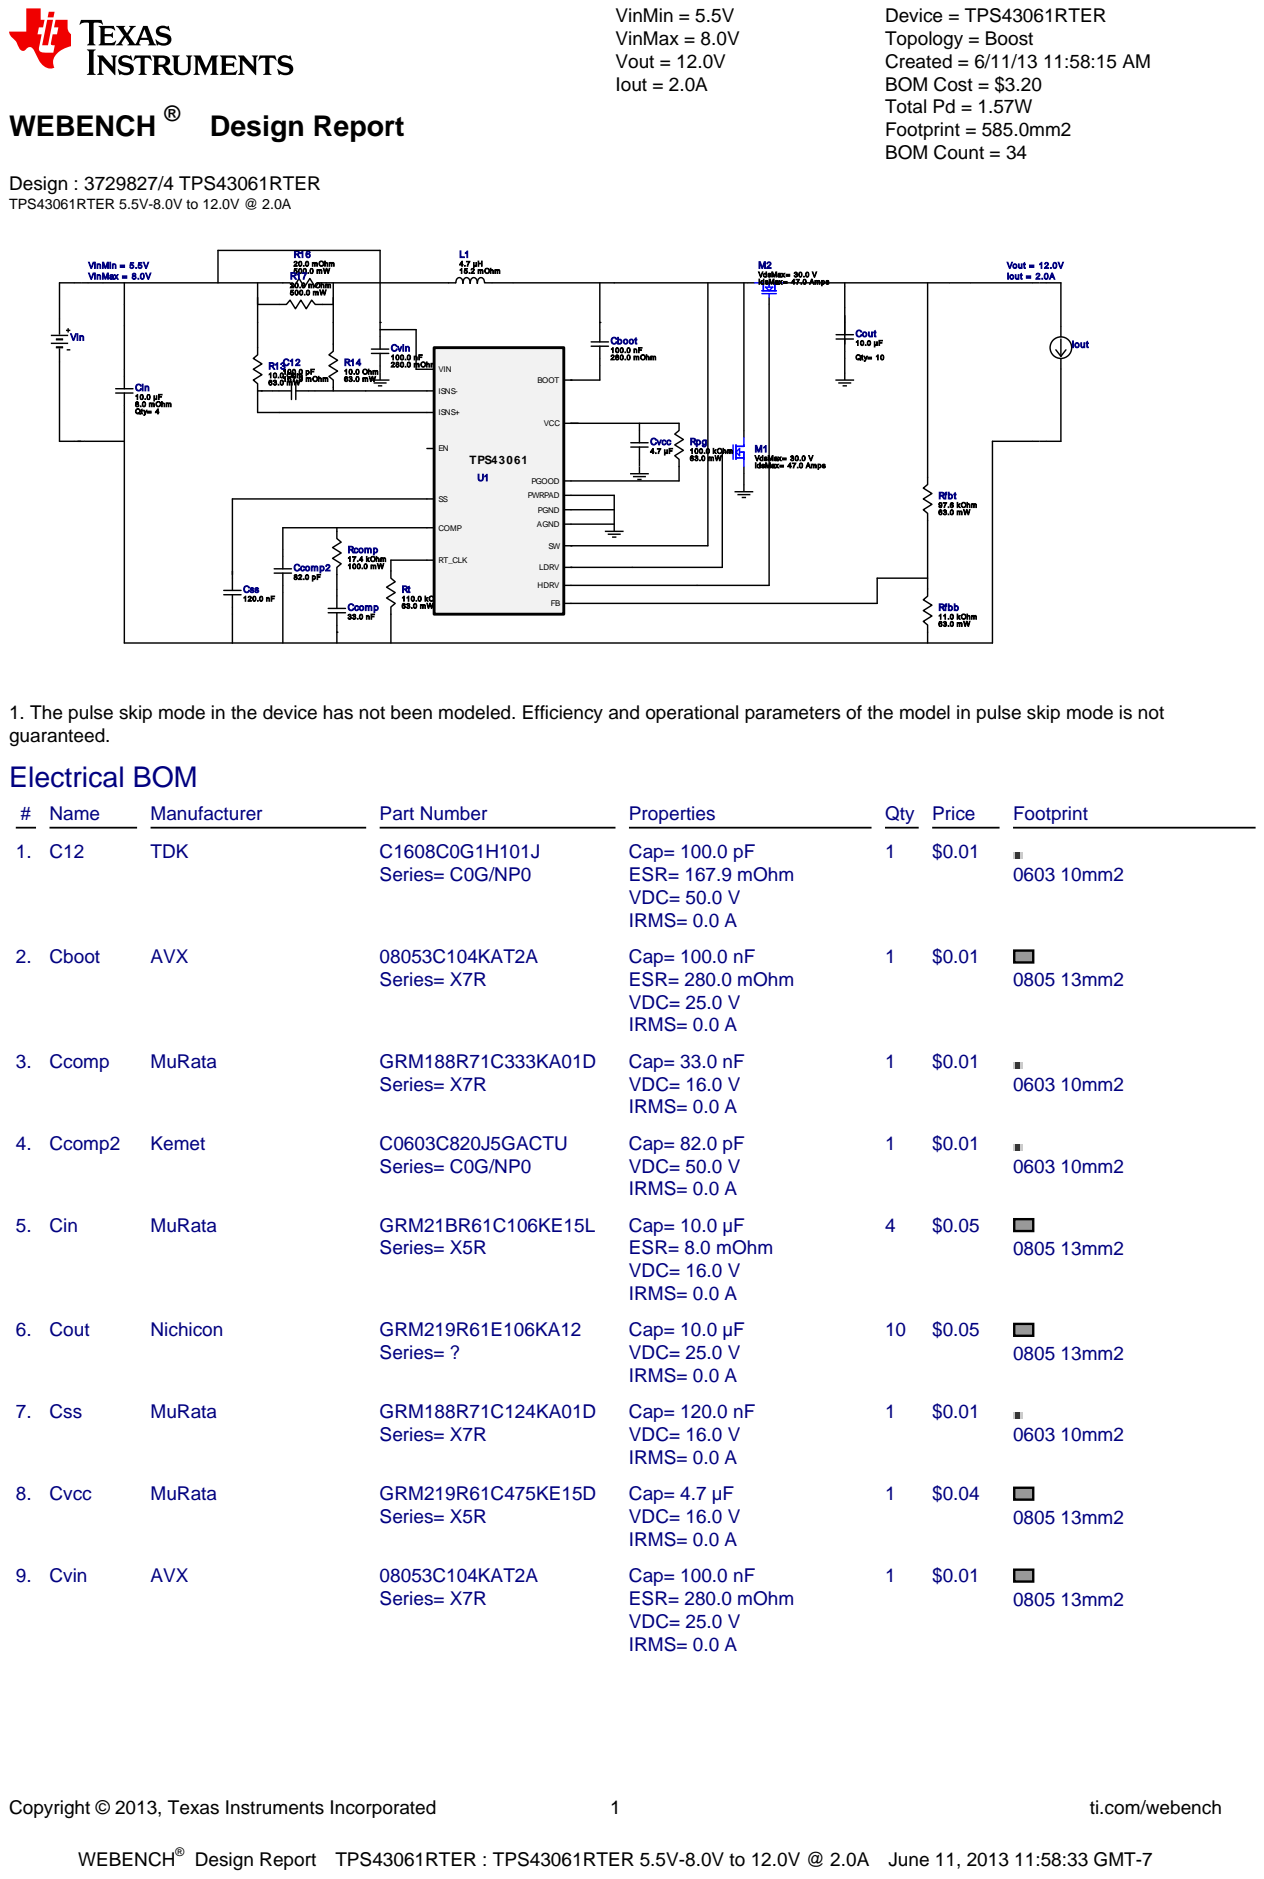
[picture p52: page 1]
Copyright © 2013, Texas Instruments Incorporated; ti.com/webench; WEBENCH®; Design : 3729827/4 TPS43061RTER TPS43061RTER 5.5V-8.0V to 12.0V @ 2.0A; VinMin = 5.5V VinMax = 8.0V Vout = 12.0V Iout = 2.0A; Device = TPS43061RTER Topology = Boost Created = 6/11/13 11:58:15 AM BOM Cost = $3.20 Total Pd = 1.57W Footprint = 585.0mm2 BOM Count = 34; C12 100.0 pF 167.9 mOhm; Cboot 100.0 nF; 280.0 mOhm; Ccomp 33.0 nF; Ccomp2 82.0 pF; Cin 10.0 µF 8.0 mOhm Qty= 4; Cout 10.0 µF; Qty= 10; Css 120.0 nF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

1. The pulse skip mode in the device has not been modeled. Efficiency and operational parameters of the model in pulse skip mode is not
guaranteed.
Electrical BOM

Design Report TPS43061RTER : TPS43061RTER 5.5V-8.0V to 12.0V @ 2.0A June 11, 2013 11:58:33 GMT-7

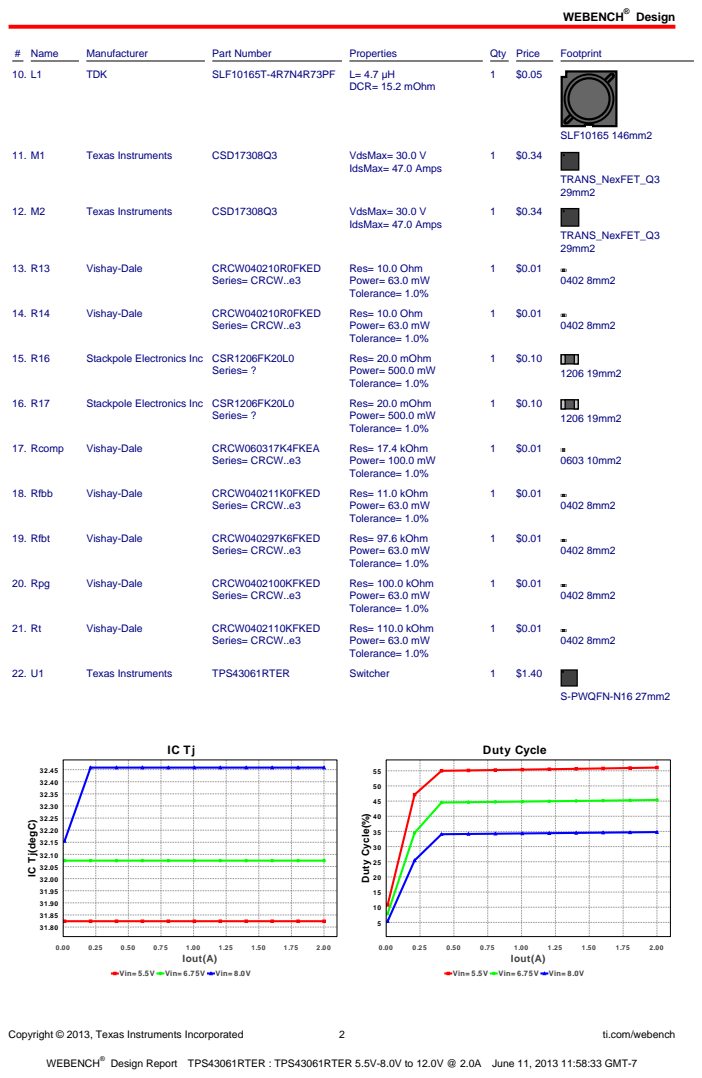
[picture p53: page 2]
Design; Copyright © 2013, Texas Instruments Incorporated; ti.com/webench; # Name; Manufacturer; Part Number; Properties; Qty Price; Footprint; TDK; SLF10165T-4R7N4R73PF L= 4.7 µH; DCR= 15.2 mOhm; SLF10165 146mm2; Texas Instruments; CSD17308Q3; VdsMax= 30.0 V; IdsMax= 47.0 Amps; TRANS_NexFET_Q3 29mm2; Vishay-Dale; CRCW040210R0FKED; Series= CRCW..e3; Res= 10.0 Ohm Power= 63.0 mW Tolerance= 1.0%; Stackpole Electronics Inc CSR1206FK20L0; Series= ?; Res= 20.0 mOhm Power= 500.0 mW Tolerance= 1.0%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

IC Tj(degC)

Vin= 5.5V Vin= 6.75V Vin= 8.0V

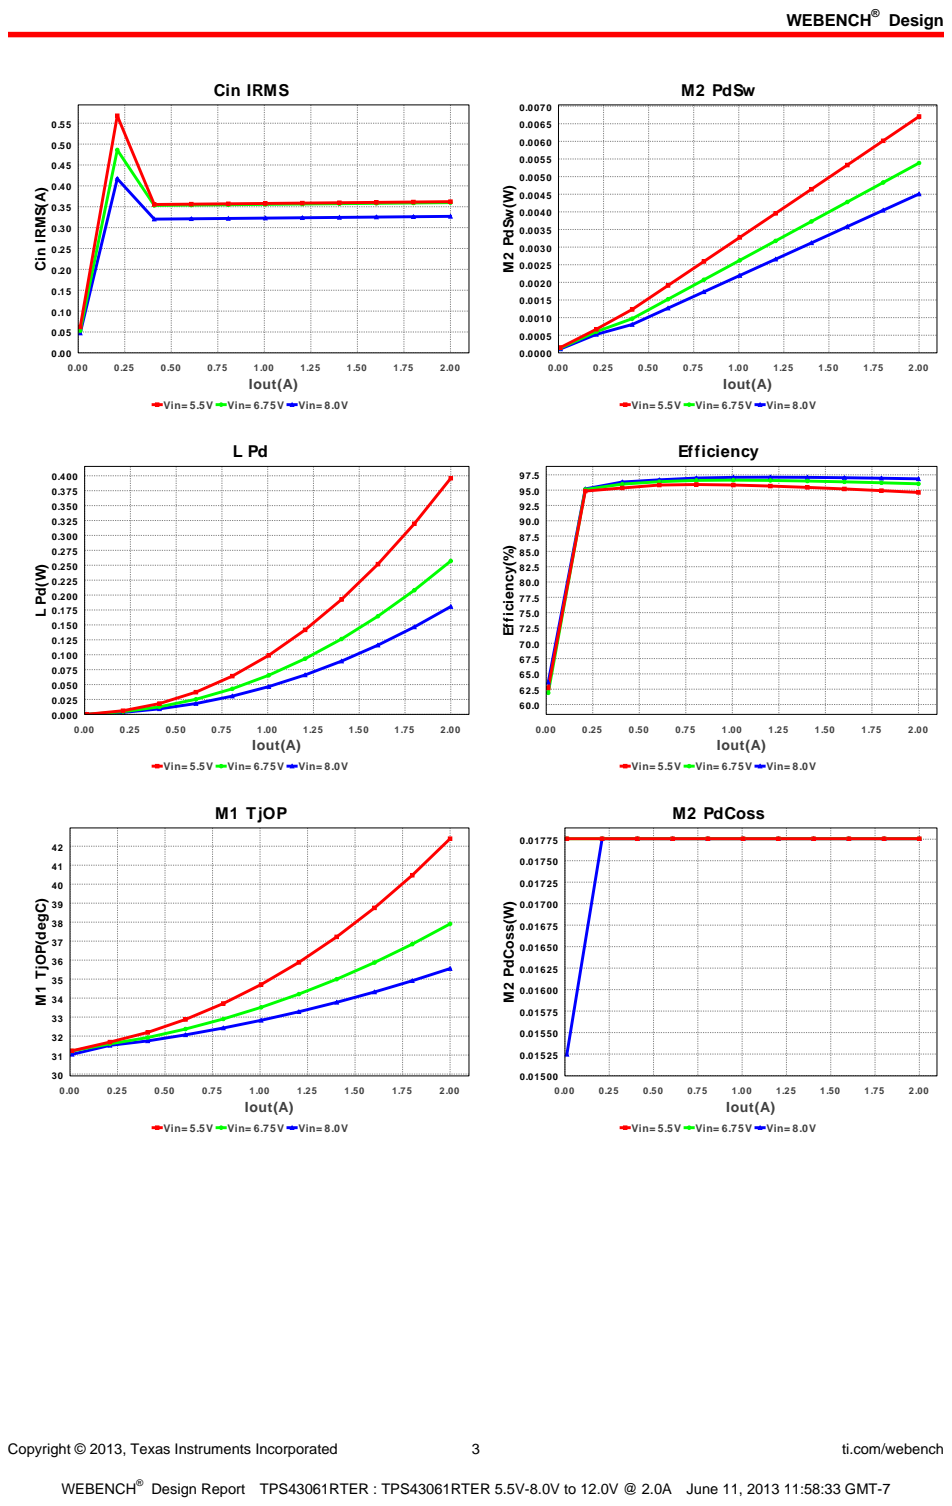
[picture p54: page 3]
Copyright © 2013, Texas Instruments Incorporated; ti.com/webench; Cin IRMS; Iout(A); Cin IRMS(A); M2 PdSw; M2 PdSw(W); Efficiency; Efficiency(%); M1 TjOP; M1 TjOP(degC); M2 PdCoss; M2 PdCoss(W)

Vin= 5.5V Vin= 6.75V Vin= 8.0V

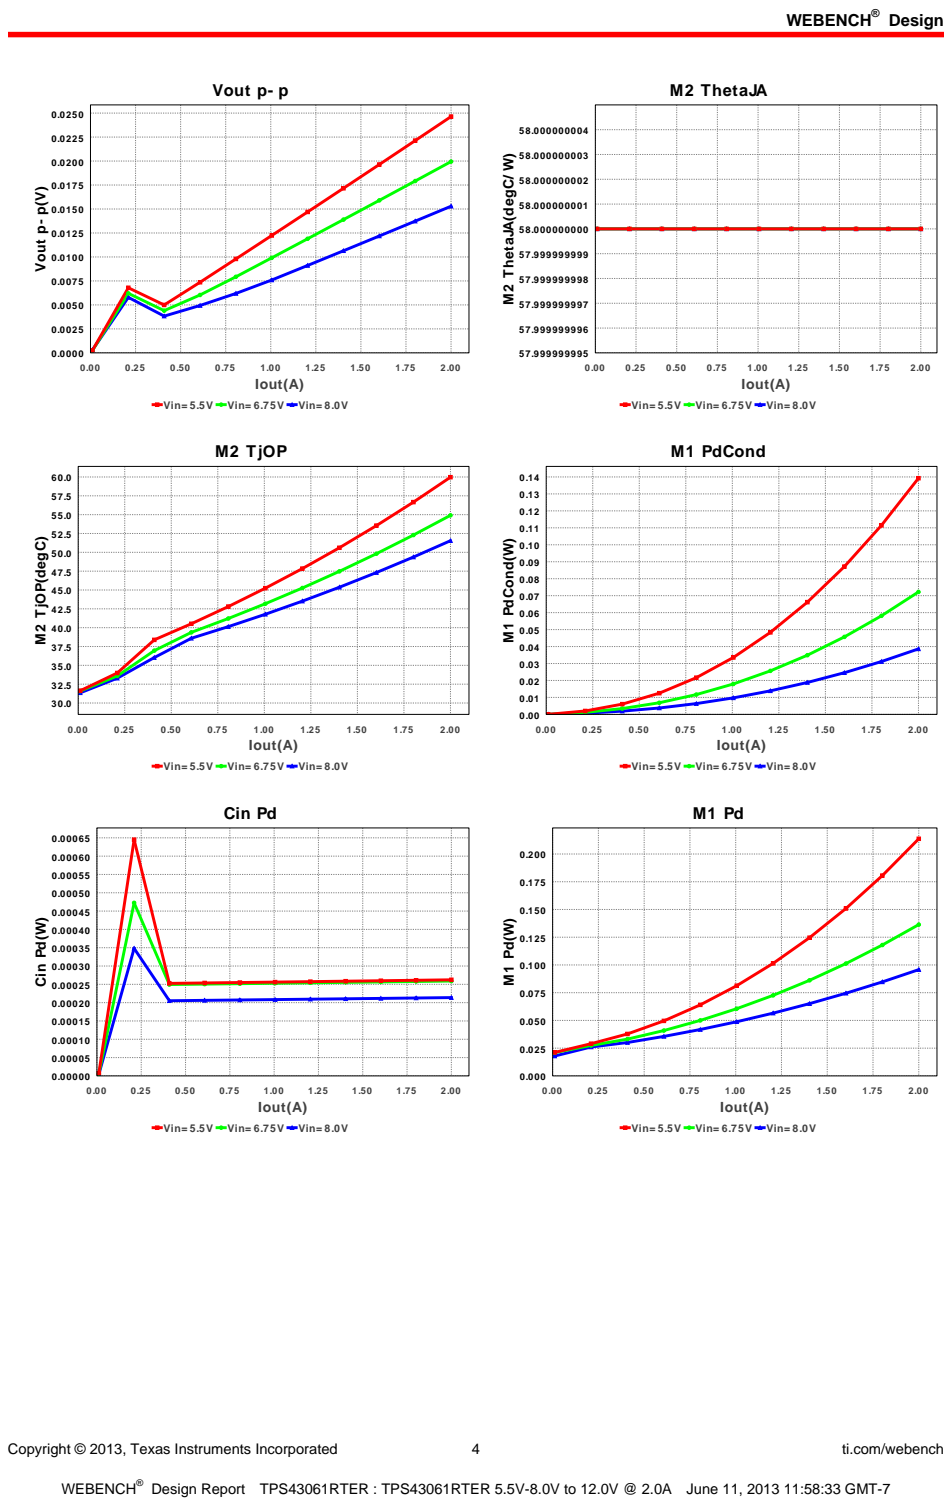
[picture p55: page 4]
Copyright © 2013, Texas Instruments Incorporated; ti.com/webench; Vout p- p; Iout(A); Vout p- p(V); M2 ThetaJA; M2 ThetaJA(degC/ W); M2 TjOP; M2 TjOP(degC); M1 PdCond; M1 PdCond(W); Cin Pd; Cin Pd(W)

Vin= 5.5V Vin= 6.75V Vin= 8.0V

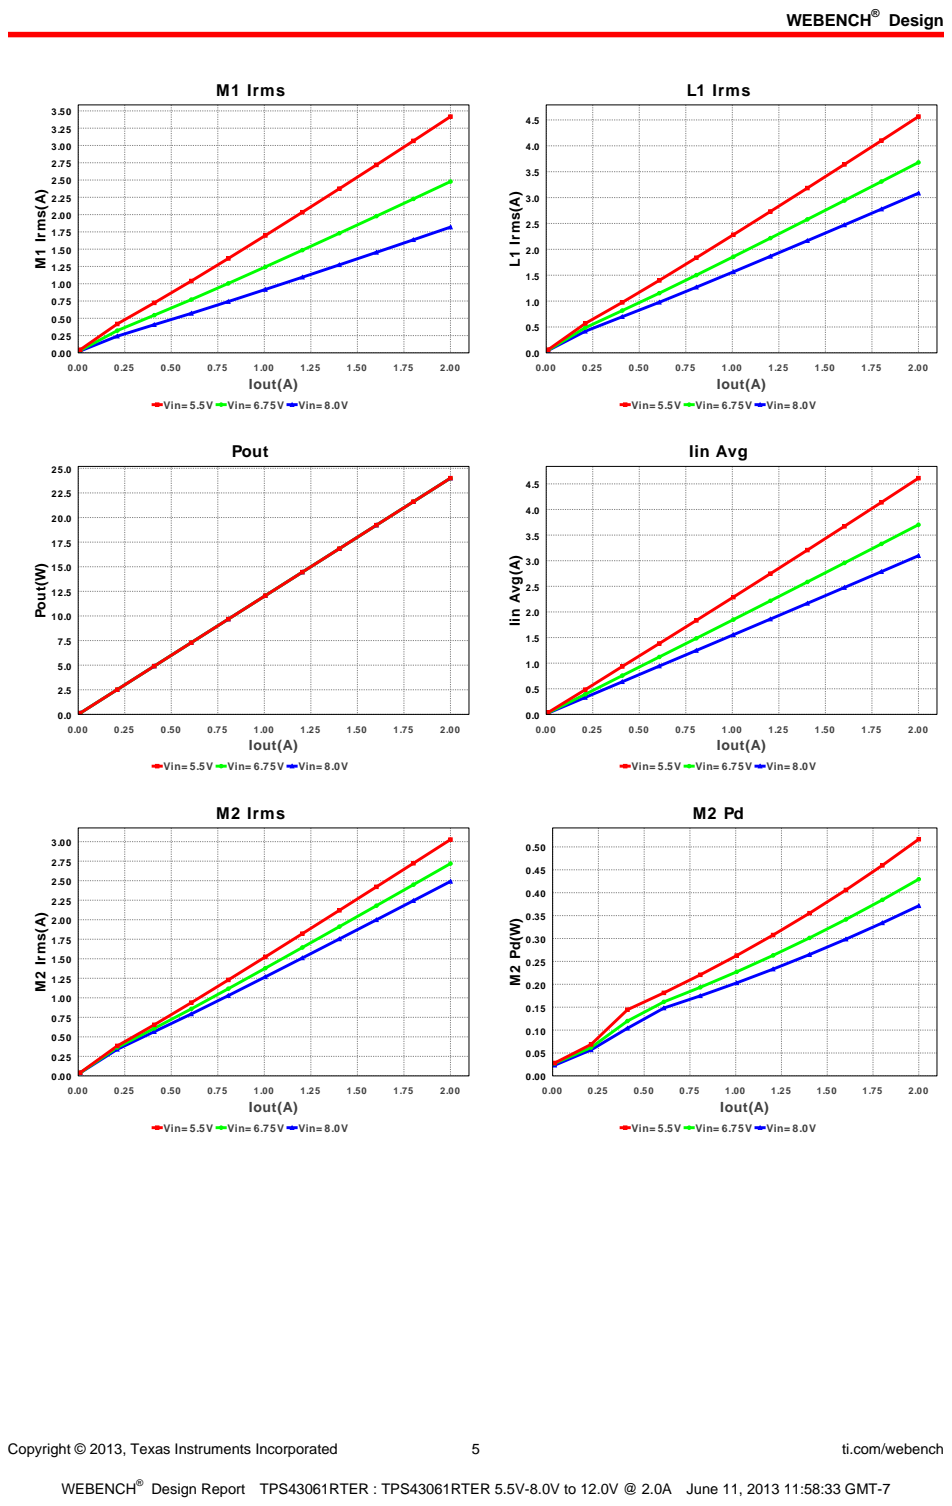
[picture p56: page 5]
Copyright © 2013, Texas Instruments Incorporated; ti.com/webench; M1 Irms; Iout(A); M1 Irms(A); L1 Irms; L1 Irms(A); Pout; Pout(W); Iin Avg; Iin Avg(A); M2 Irms; M2 Irms(A)

Vin= 5.5V Vin= 6.75V Vin= 8.0V

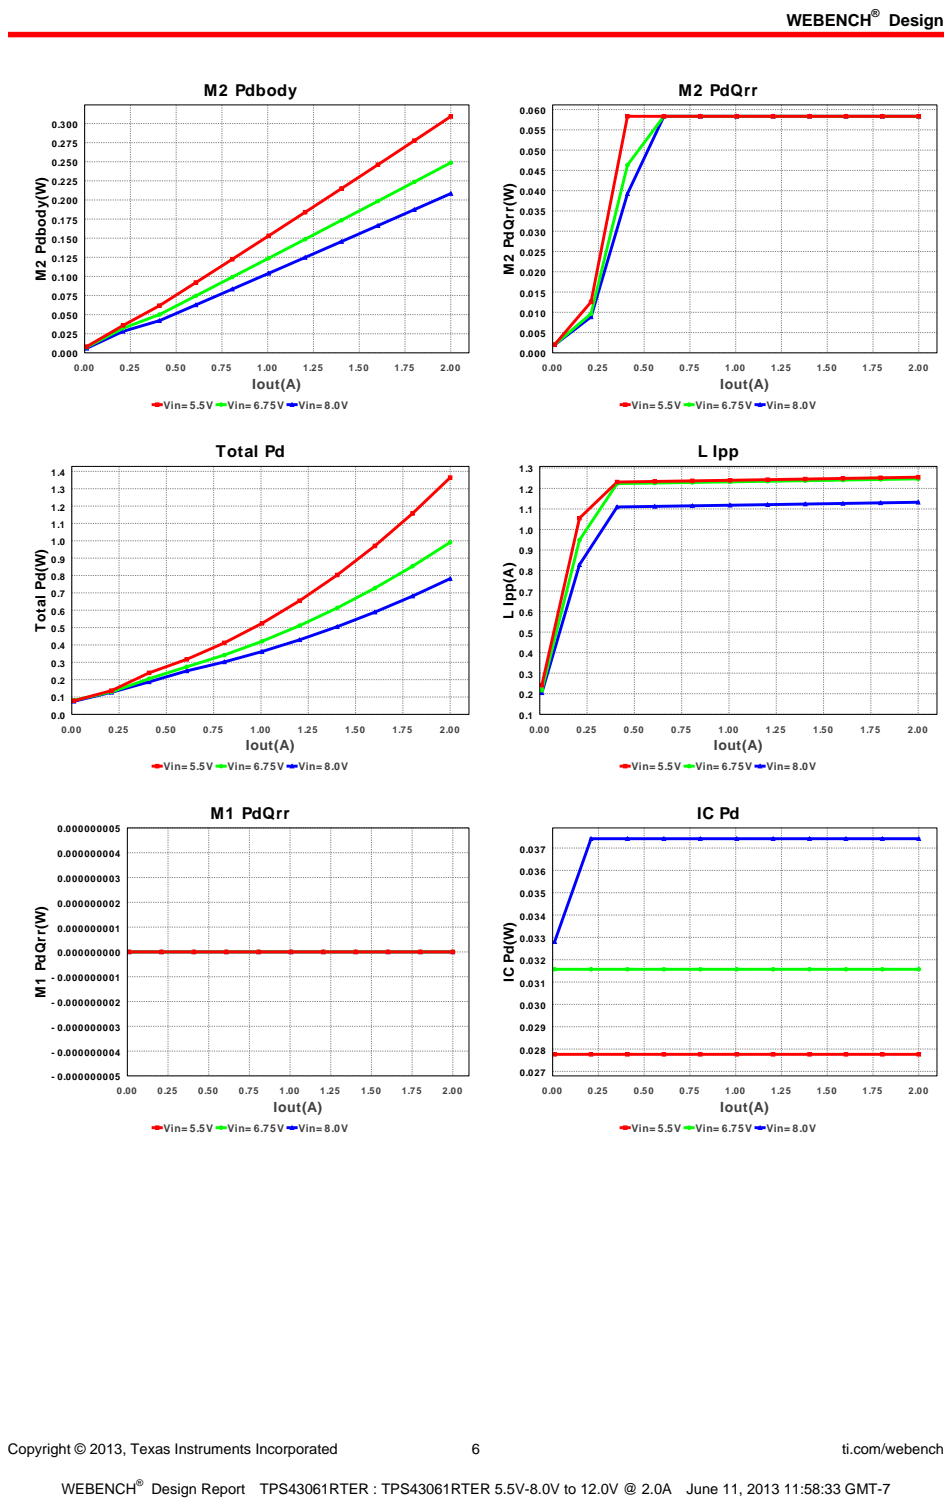
[picture p57: page 6]
Copyright © 2013, Texas Instruments Incorporated; ti.com/webench; M2 Pdbody; Iout(A); M2 Pdbody(W); M2 PdQrr; M2 PdQrr(W); Total Pd; Total Pd(W); L Ipp; L Ipp(A); M1 PdQrr; M1 PdQrr(W)

Vin= 5.5V Vin= 6.75V Vin= 8.0V

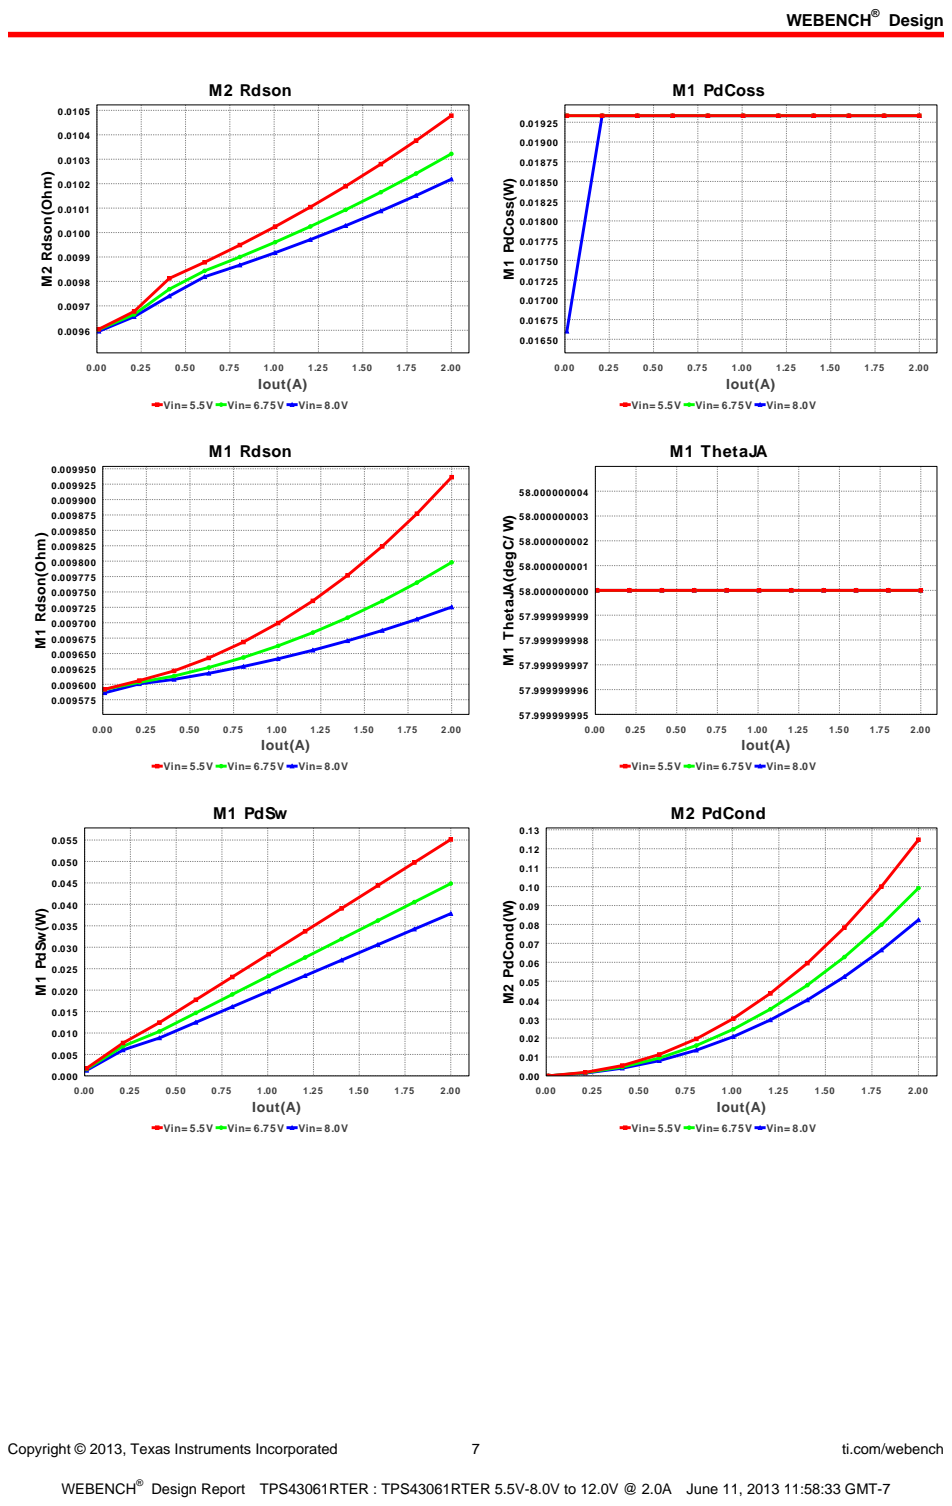
[picture p58: page 7]
Copyright © 2013, Texas Instruments Incorporated; ti.com/webench; M2 Rdson; Iout(A); M2 Rdson(Ohm); M1 PdCoss; M1 PdCoss(W); M1 Rdson; M1 Rdson(Ohm); M1 ThetaJA; M1 ThetaJA(degC/ W); M1 PdSw; M1 PdSw(W); M2 PdCond; M2 PdCond(W)

Vin= 5.5V Vin= 6.75V Vin= 8.0V

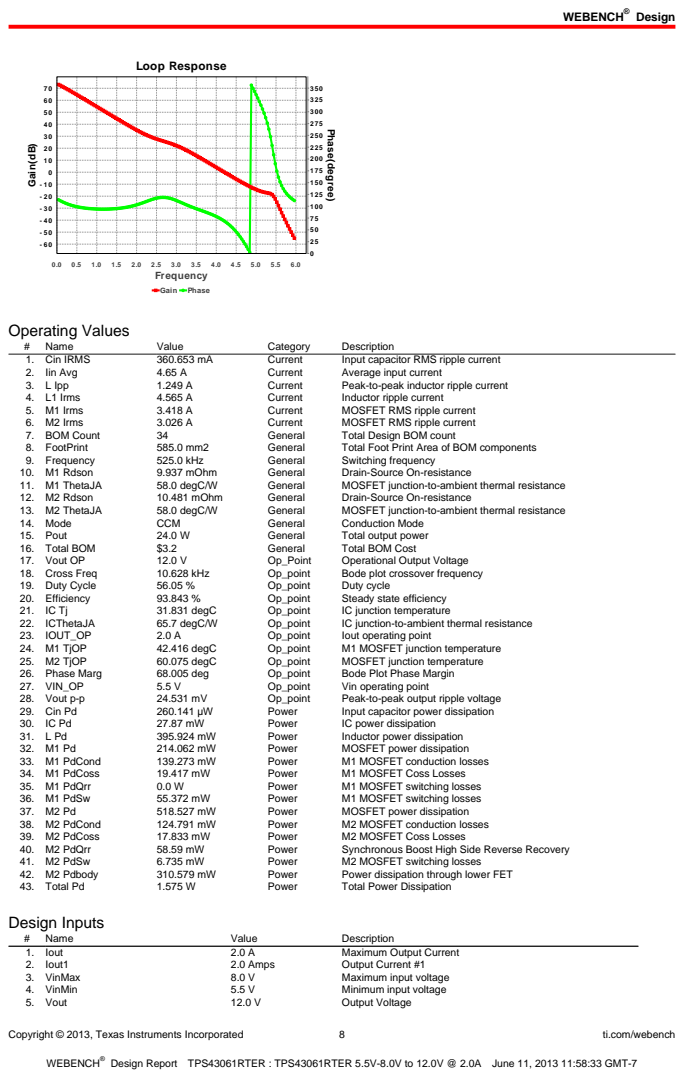
[picture p59: page 8]
Copyright © 2013, Texas Instruments Incorporated; ti.com/webench; Loop Response; Gain Phase; 6.0 Frequency; Gain(dB); Phase(degree); Operating Values; Name; Value; Category; Description; 1. Cin IRMS; Current; Input capacitor RMS ripple current; 2. Iin Avg; Average input current; 3. L Ipp; Peak-to-peak inductor ripple current; 4. L1 Irms; Inductor ripple current; 5. M1 Irms; MOSFET RMS ripple current; 6. M2 Irms; 7. BOM Count; General; Total Design BOM count; 8. FootPrint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

Copyright © 2013, Texas Instruments Incorporated | 9 | ti.com/webench
# | Name | Value | Description

6. Vout1 | 12.0 Volt | Output Voltage #1
7. base_pn | TPS43061 | Base Product Number
8. source | DC | Input Source Type
9. Ta | 30.0 degC | Ambient temperature

## Design Assistance

1. TPS43061 Product Folder : http://www.ti.com/product/tps43061 : contains the data sheet and other resources.

Texas Instruments' WEBENCH simulation tools attempt to recreate the performance of a substantially equivalent physical implementation
of the design. Simulations are created using Texas Instruments' published specifications as well as the published specifications of other device manufacturers. While Texas Instruments does update this information periodically, this information may not be current at the time the simulation is built. Texas Instruments does not warrant the accuracy or completeness of the specifications or any information contained therein. Texas Instruments does not warrant that any designs or recommended parts will meet the specifications you entered, will be suitable for your application or fit for any particular purpose, or will operate as shown in the simulation in a physical implementation. Texas Instruments does not warrant that the designs are production worthy.
You should completely validate and test your design implementation to confirm the system functionality for your application prior to production.
Use of Texas Instruments' WEBENCH simulation tools is subject to Texas Instruments' Site Terms and Conditions of Use. (http://www.ti.com/corp/docs/legal/termsofuse.shtml) Prototype boards based on WEBENCH created designs are provided AS IS without warranty of any kind for evaluation and testing purposes and are subject to the terms of the Evaluation License Agreement. (http://www.ti.com/corp/docs/legal/termsofuse_estore.shtml)
