ARoS-NCSU/WolfBot-Hardware/boards/power/webench_design_6Volt_boost.pdf

## WEBENCH ® Design Report

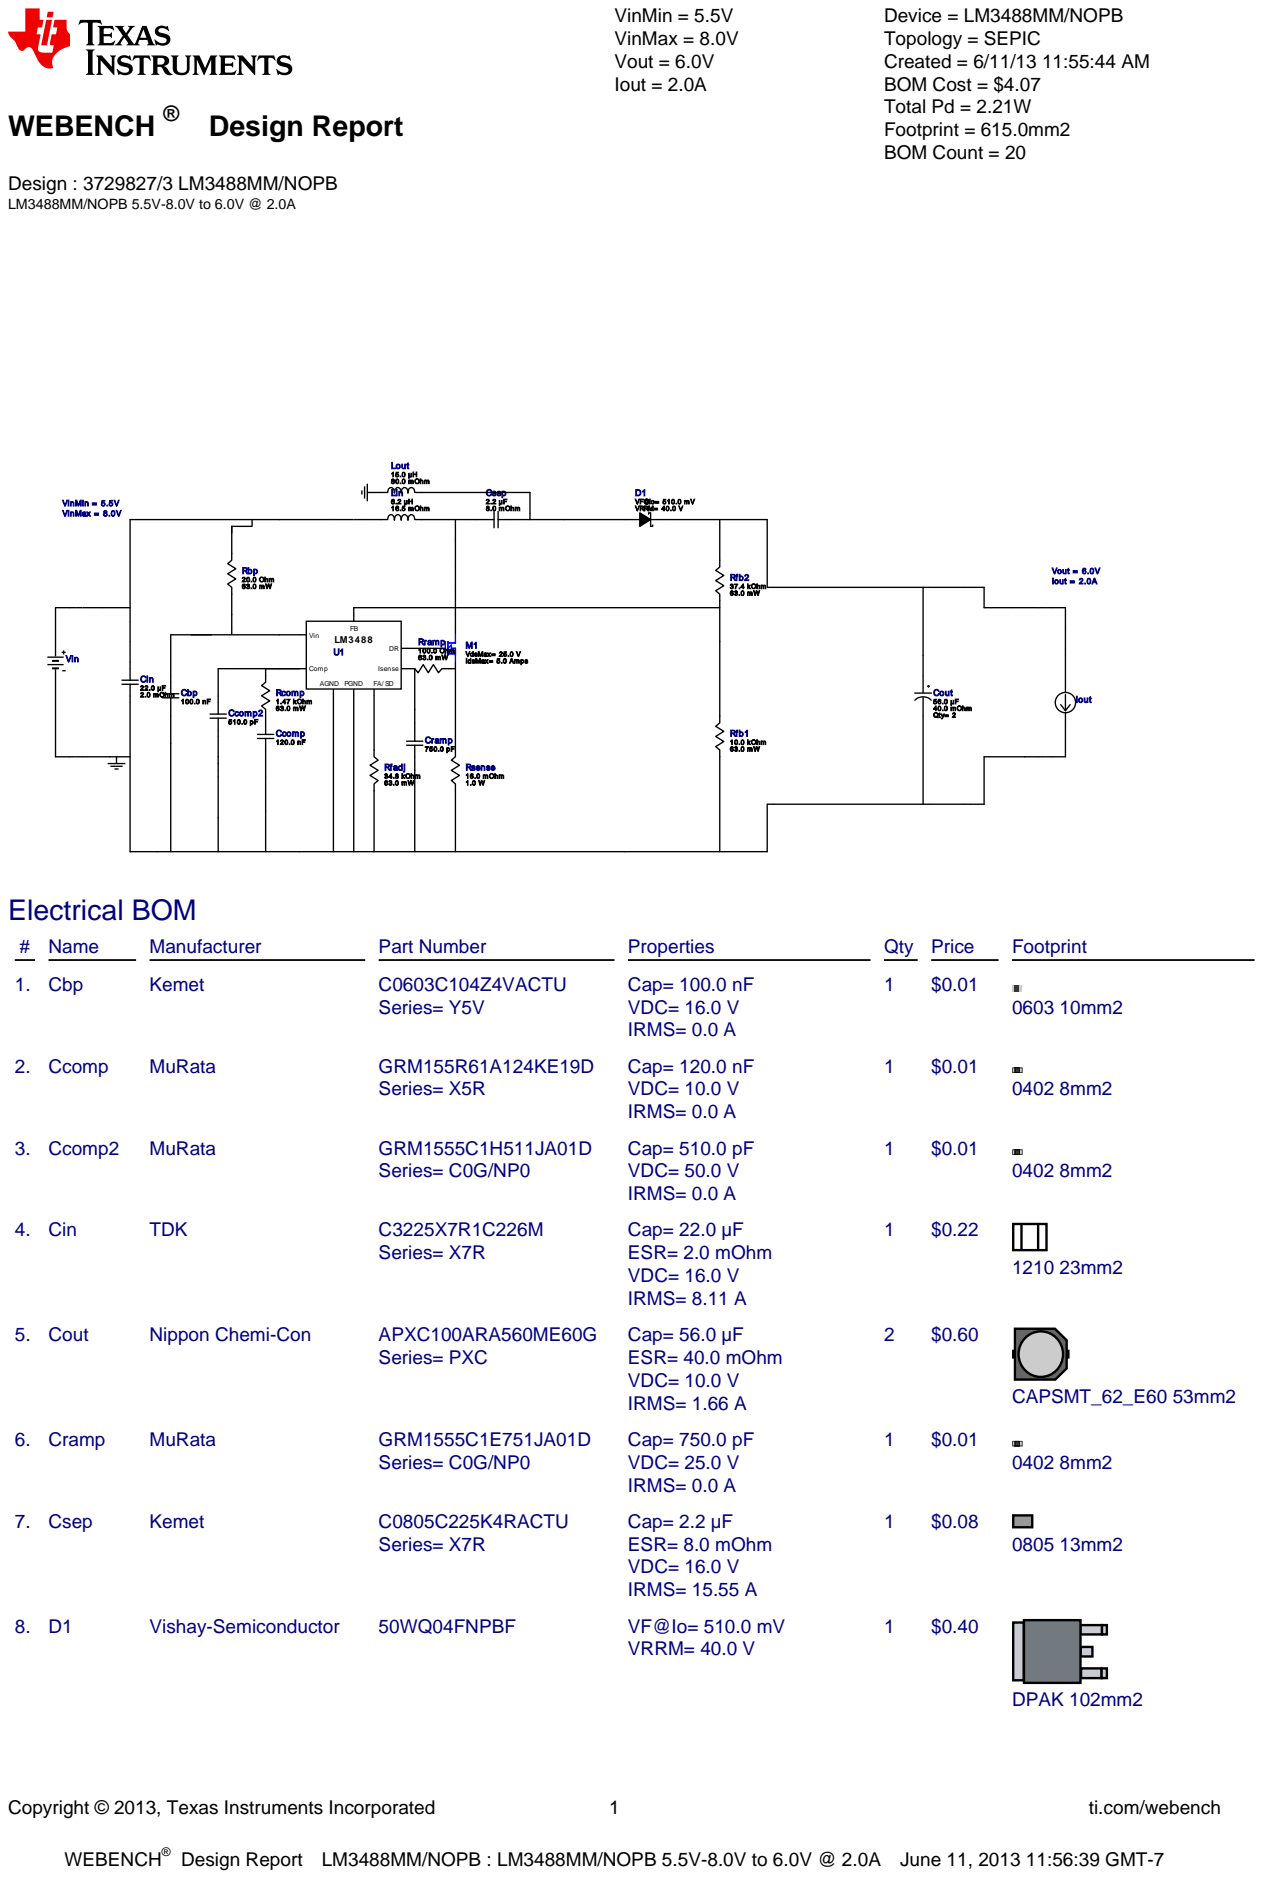
[picture p60: page 1]
Copyright © 2013, Texas Instruments Incorporated; ti.com/webench; WEBENCH®; Design : 3729827/3 LM3488MM/NOPB LM3488MM/NOPB 5.5V-8.0V to 6.0V @ 2.0A; VinMin = 5.5V VinMax = 8.0V Vout = 6.0V Iout = 2.0A; Device = LM3488MM/NOPB Topology = SEPIC Created = 6/11/13 11:55:44 AM BOM Cost = $4.07 Total Pd = 2.21W Footprint = 615.0mm2 BOM Count = 20; Cbp 100.0 nF; Cin 22.0 µF 2.0 mOhm; Cramp 750.0 pF; Csep 2.2 µF 8.0 mOhm; D1 VF@Io= 510.0 mV VRRM= 40.0 V; M1 VdsMax= 25.0 V IdsMax= 5.0 Amps; Cout 56.0 µF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

Design Report LM3488MM/NOPB : LM3488MM/NOPB 5.5V-8.0V to 6.0V @ 2.0A June 11, 2013 11:56:39 GMT-7

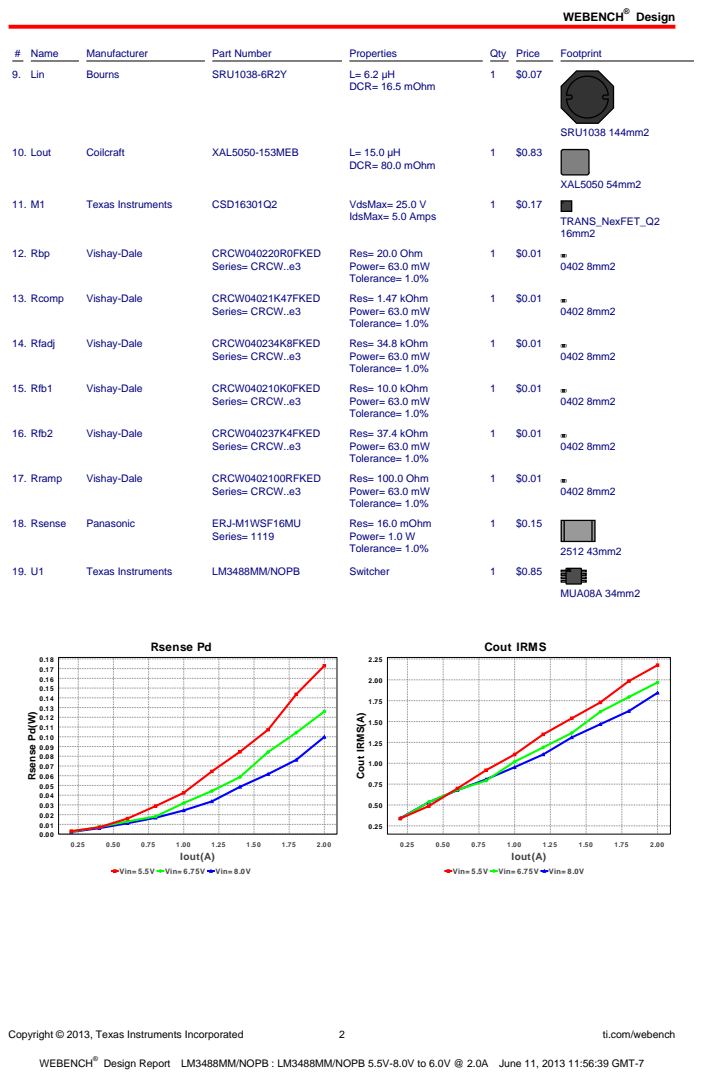
[picture p61: page 2]
Design; Copyright © 2013, Texas Instruments Incorporated; ti.com/webench; # Name; Manufacturer; Part Number; Properties; Qty Price; Footprint; 9. Lin; Bourns; SRU1038-6R2Y; DCR= 16.5 mOhm; SRU1038 144mm2; 10. Lout; Coilcraft; XAL5050-153MEB; DCR= 80.0 mOhm; XAL5050 54mm2; Texas Instruments; CSD16301Q2; VdsMax= 25.0 V; IdsMax= 5.0 Amps; TRANS_NexFET_Q2 16mm2; 12. Rbp; Vishay-Dale; CRCW040220R0FKED; Series= CRCW..e3; Res= 20.0 Ohm Power= 63.0 mW Tolerance= 1.0%; 13. Rcomp; CRCW04021K47FKED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

Vin= 5.5V Vin= 6.75V Vin= 8.0V

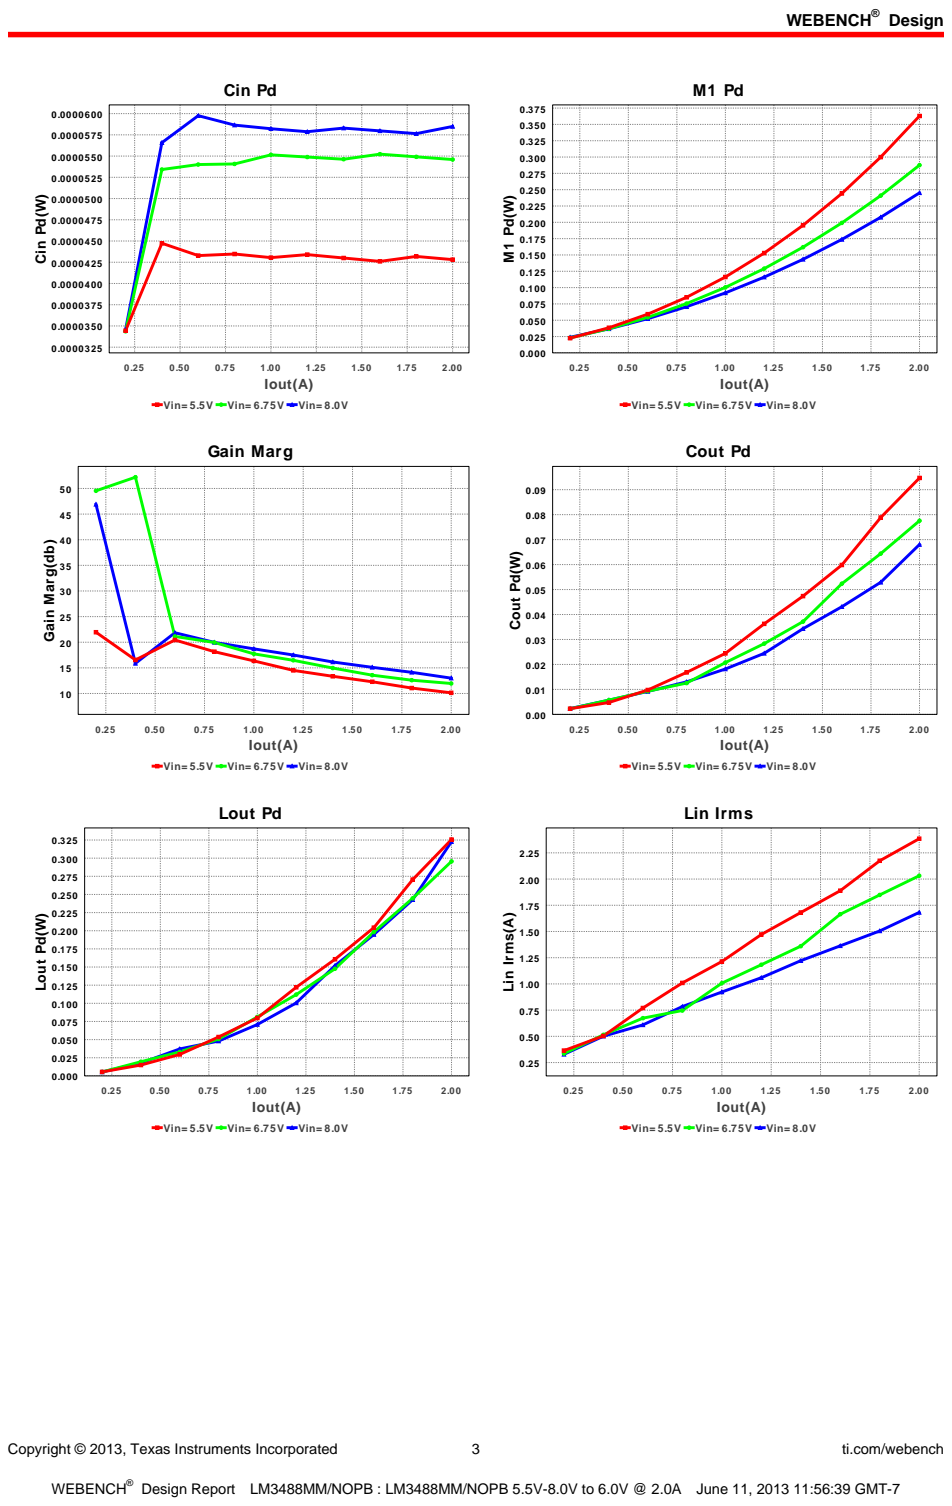
[picture p62: page 3]
Copyright © 2013, Texas Instruments Incorporated; ti.com/webench; Cin Pd; Iout(A); Cin Pd(W); Gain Marg; Cout Pd; Cout Pd(W); Lout Pd; Lout Pd(W); Lin Irms; Lin Irms(A)

Vin= 5.5V Vin= 6.75V Vin= 8.0V

Gain Marg(db)

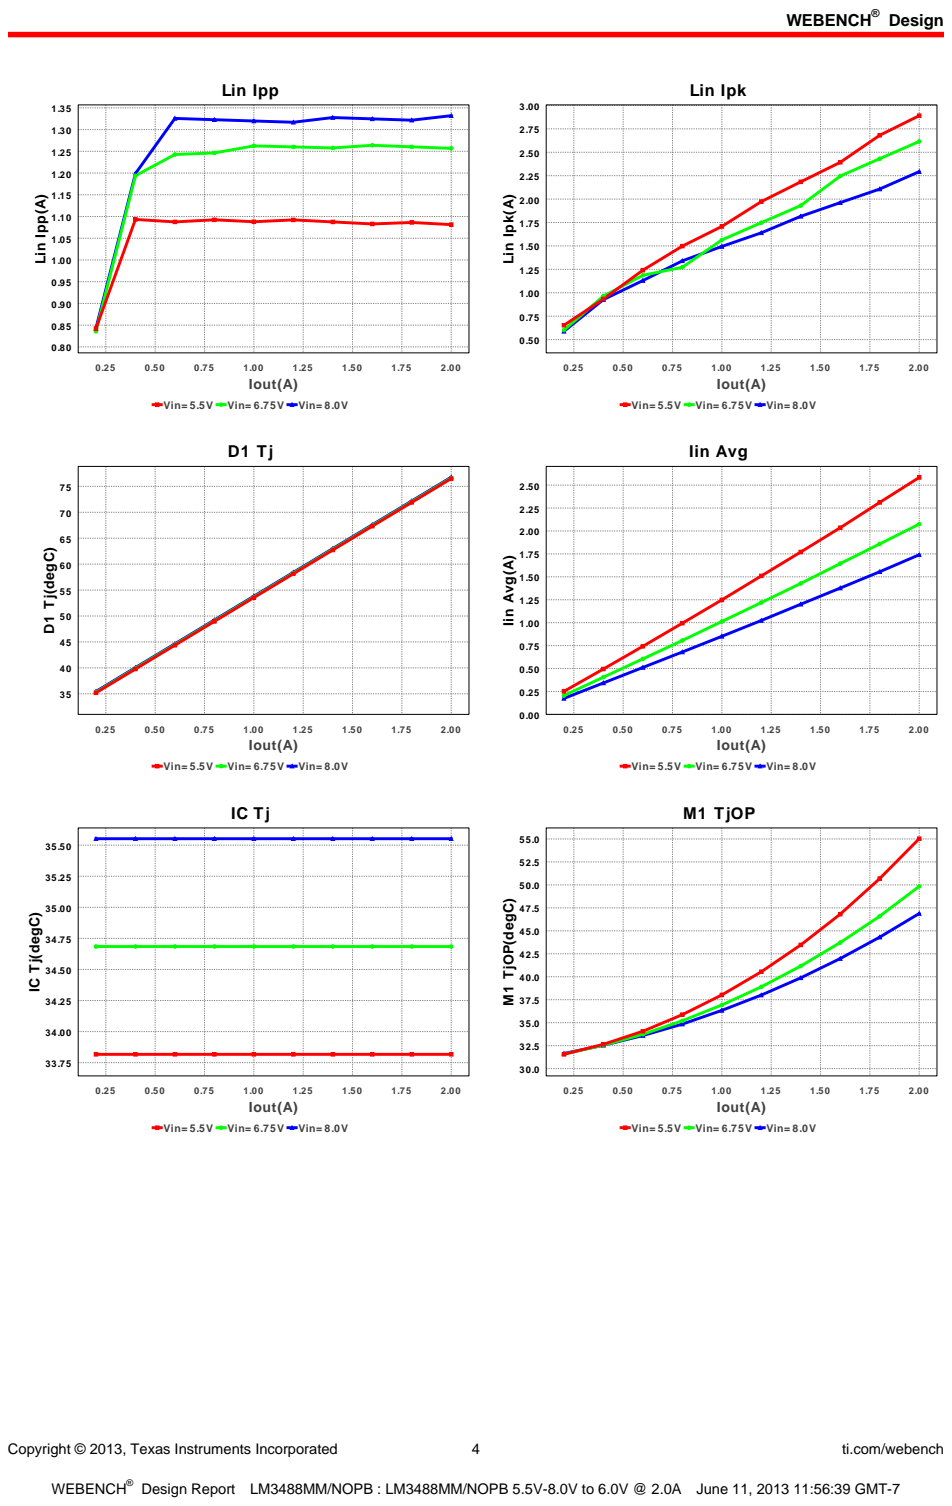
[picture p63: page 4]
Copyright © 2013, Texas Instruments Incorporated; ti.com/webench; Lin Ipp; Iout(A); Lin Ipp(A); Lin Ipk; Lin Ipk(A); D1 Tj(degC); Iin Avg; Iin Avg(A); M1 TjOP; M1 TjOP(degC)

Vin= 5.5V Vin= 6.75V Vin= 8.0V

IC Tj(degC)

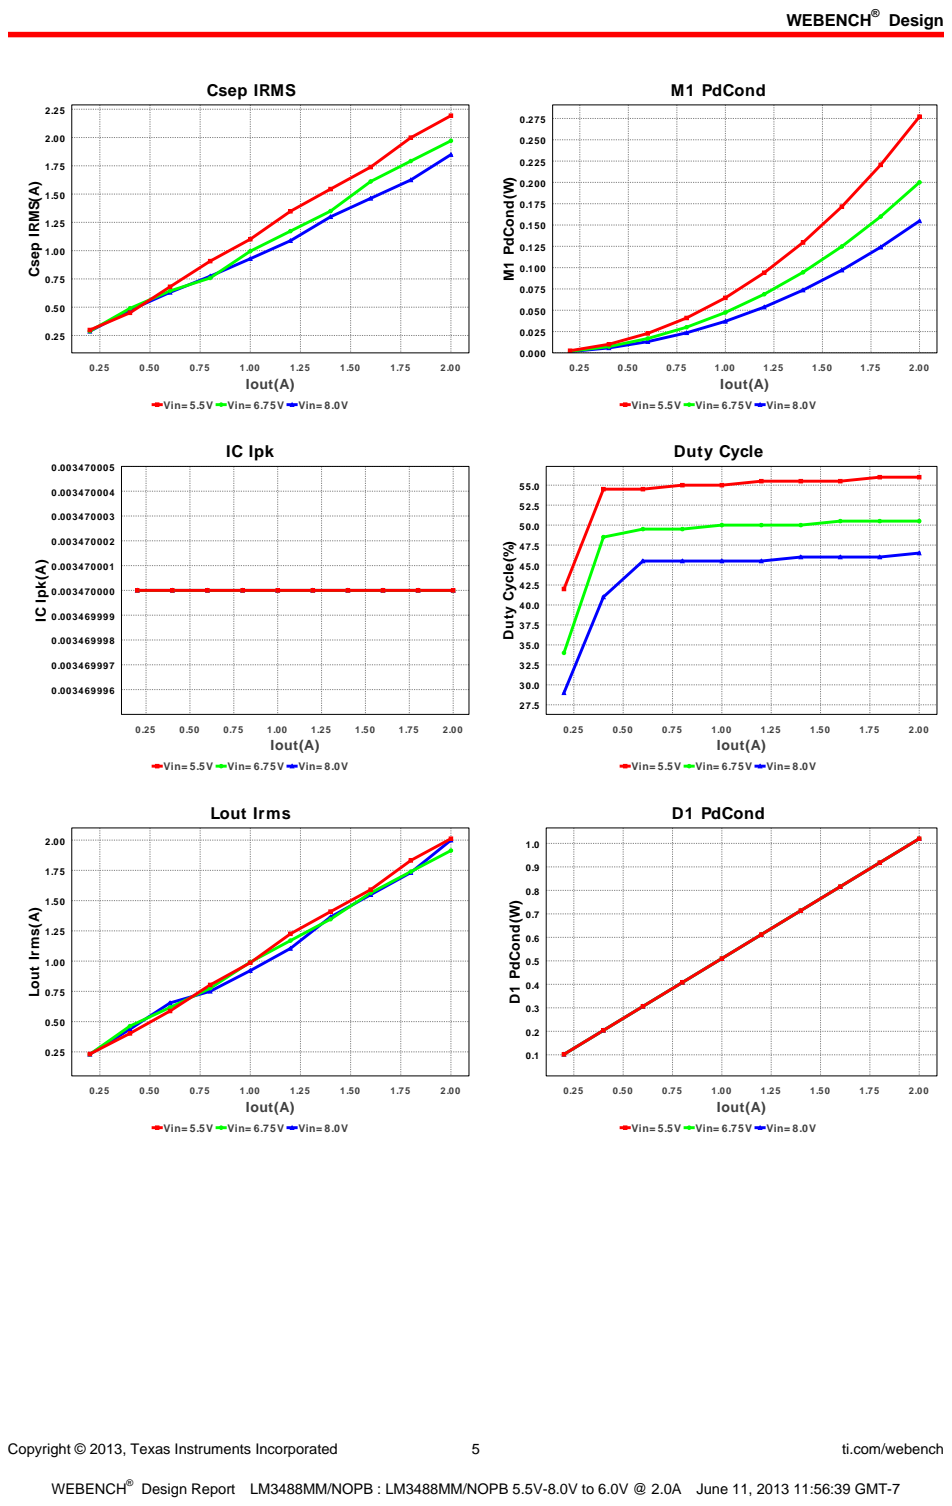
[picture p64: page 5]
Copyright © 2013, Texas Instruments Incorporated; ti.com/webench; Csep IRMS; Iout(A); Csep IRMS(A); M1 PdCond; M1 PdCond(W); IC Ipk; IC Ipk(A); Duty Cycle; Duty Cycle(%); Lout Irms; Lout Irms(A); D1 PdCond; D1 PdCond(W)

Vin= 5.5V Vin= 6.75V Vin= 8.0V

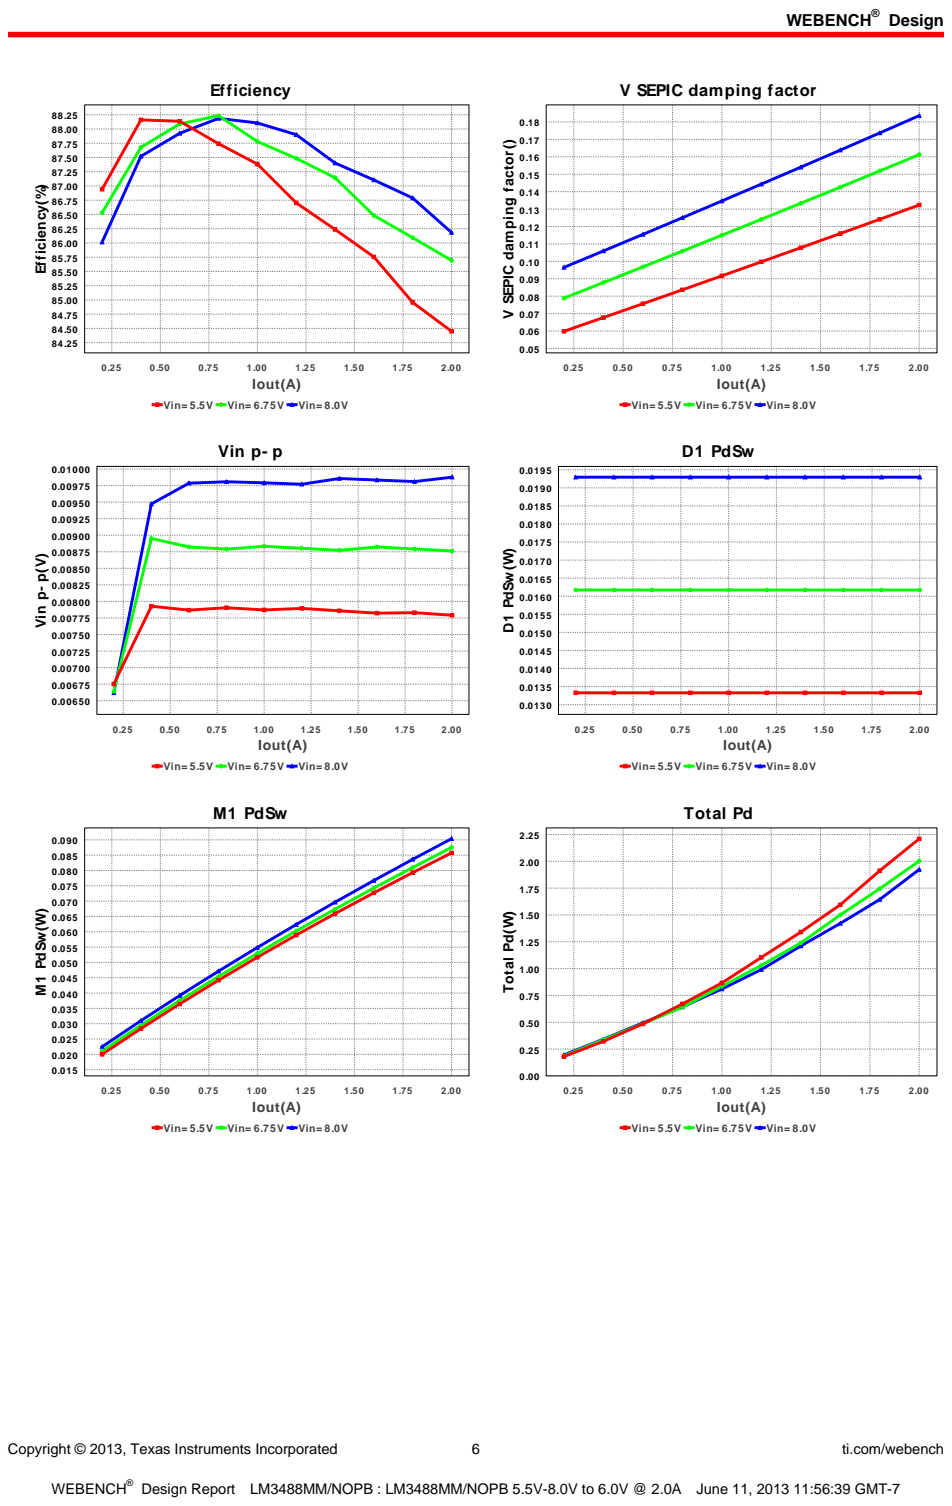
[picture p65: page 6]
Copyright © 2013, Texas Instruments Incorporated; ti.com/webench; Efficiency; Iout(A); Efficiency(%); Vin p- p; Vin p- p(V); D1 PdSw; D1 PdSw(W); M1 PdSw; M1 PdSw(W); Total Pd; Total Pd(W)

V SEPIC damping factor

V SEPIC damping factor()

Vin= 5.5V Vin= 6.75V Vin= 8.0V

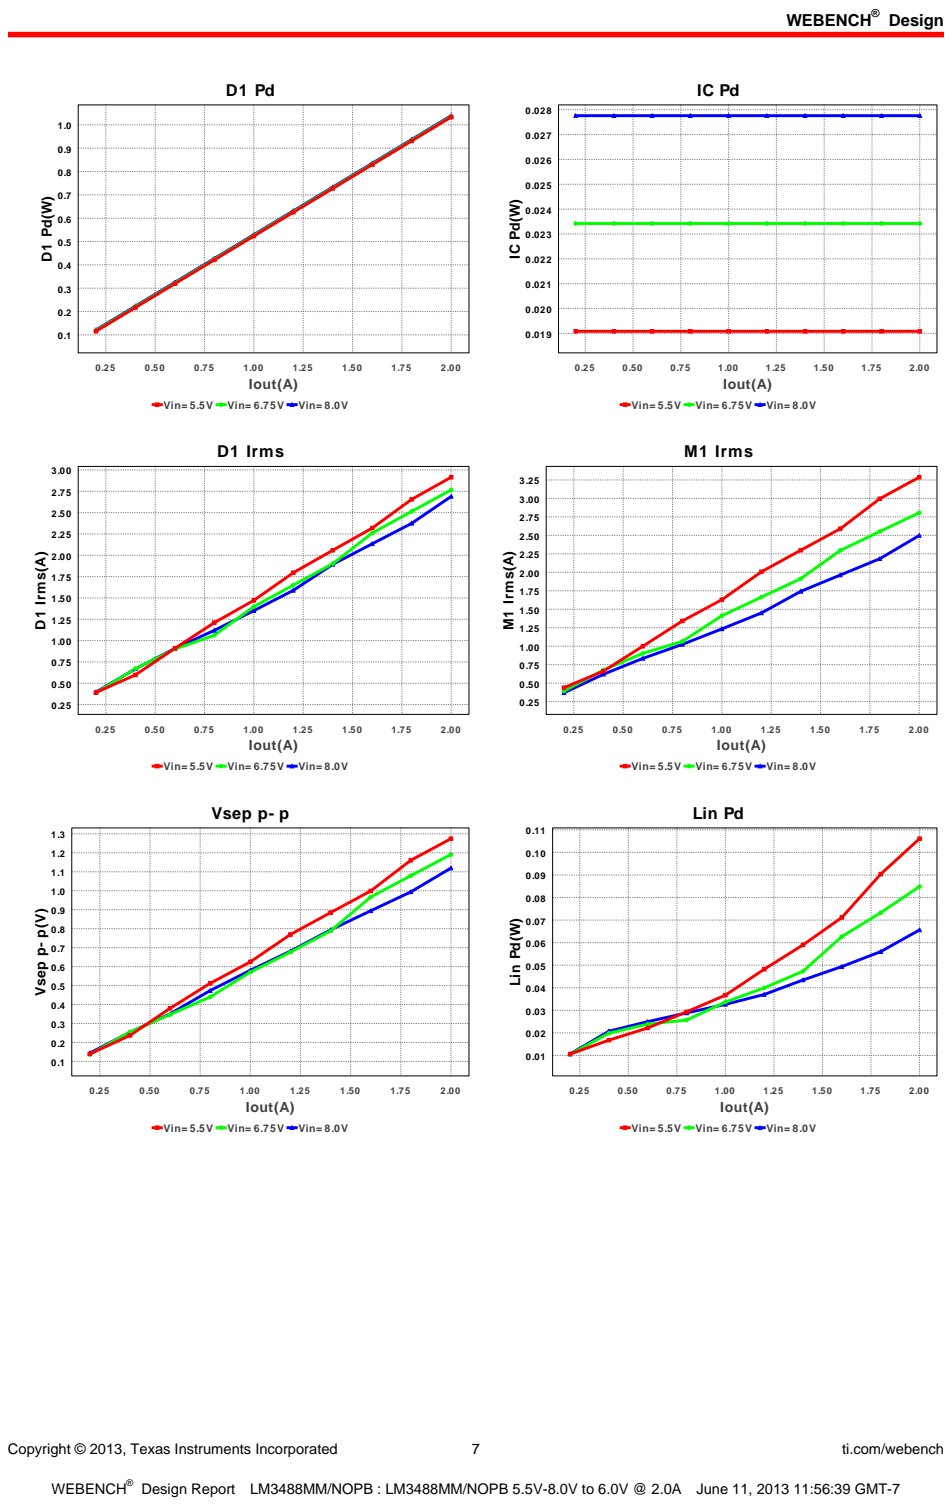
[picture p66: page 7]
Copyright © 2013, Texas Instruments Incorporated; ti.com/webench; Iout(A); D1 Irms; D1 Irms(A); M1 Irms; M1 Irms(A); Vsep p- p; Vsep p- p(V); Lin Pd; Lin Pd(W)

Vin= 5.5V Vin= 6.75V Vin= 8.0V

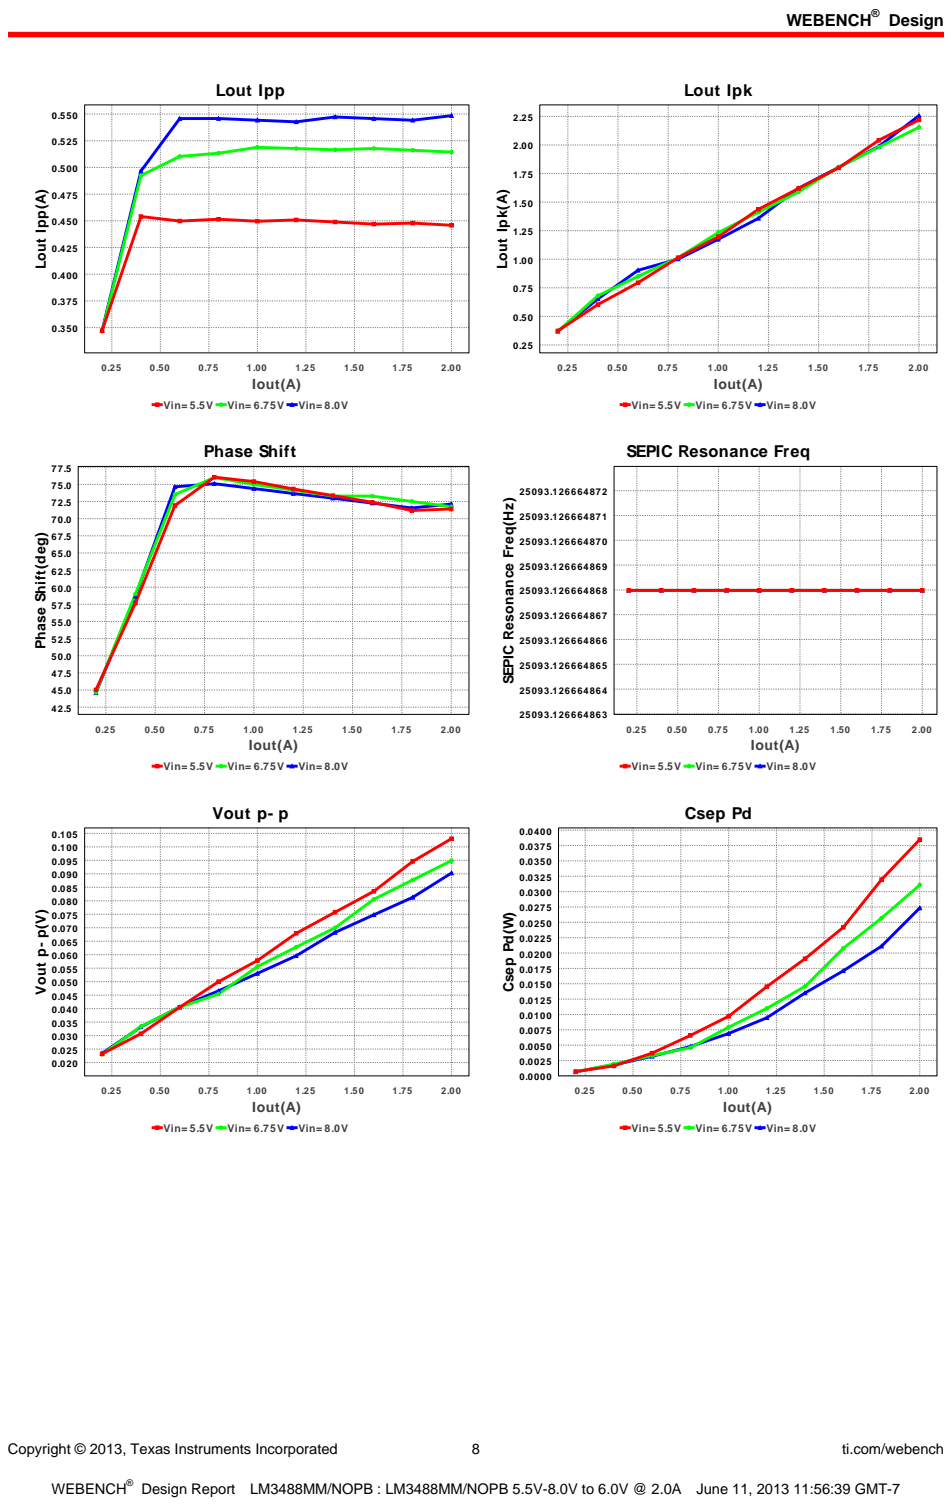
[picture p67: page 8]
Copyright © 2013, Texas Instruments Incorporated; ti.com/webench; Lout Ipp; Iout(A); Lout Ipp(A); Lout Ipk; Lout Ipk(A); Phase Shift; Vout p- p; Vout p- p(V); Csep Pd; Csep Pd(W)

Vin= 5.5V Vin= 6.75V Vin= 8.0V

SEPIC Resonance Freq

SEPIC Resonance Freq(Hz)

Phase Shift(deg)

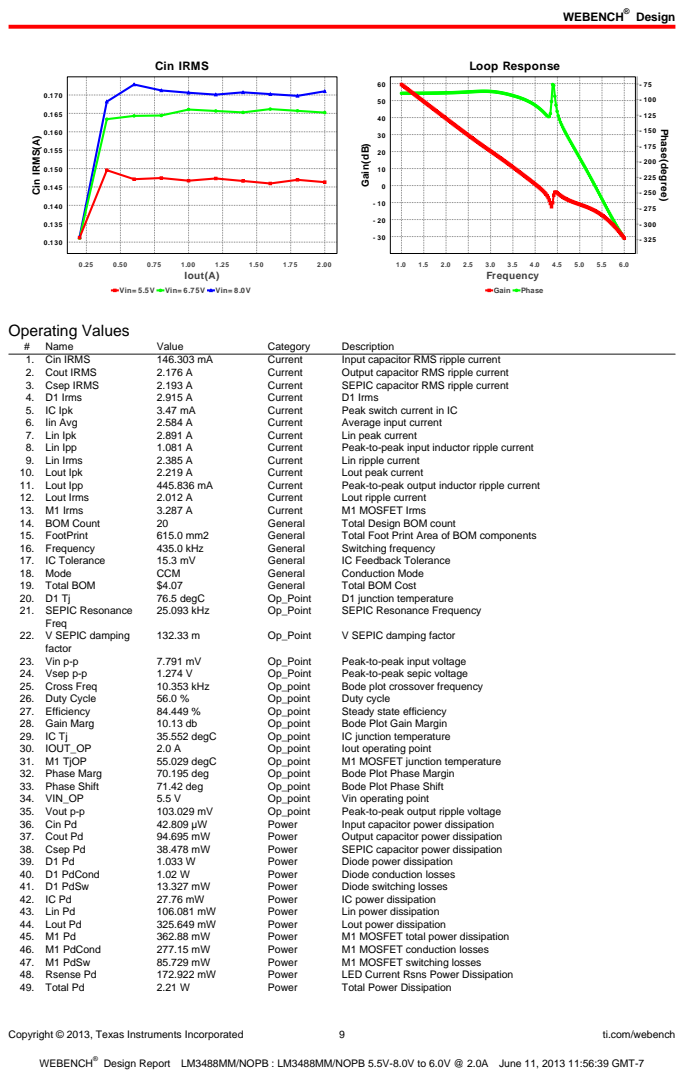
[picture p68: page 9]
Copyright © 2013, Texas Instruments Incorporated; ti.com/webench; Cin IRMS; Iout(A); Cin IRMS(A); Loop Response; Gain Phase; 6.0 Frequency; Gain(dB); Phase(degree); Operating Values; Name; Value; Category; Description; 1. Cin IRMS; Current; Input capacitor RMS ripple current; 2. Cout IRMS; Output capacitor RMS ripple current; 3. Csep IRMS; SEPIC capacitor RMS ripple current; 4. D1 Irms; D1 Irms; 5. IC Ipk; Peak switch current in IC; 6. Iin Avg; Average input current; 7. Lin Ipk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

Vin= 5.5V Vin= 6.75V Vin= 8.0V

Copyright © 2013, Texas Instruments Incorporated | 10 | ti.com/webench

## Design Inputs

# | Name | Value | Description

1. Iout | 2.0 A | Maximum Output Current
2. Iout1 | 2.0 Amps | Output Current #1
3. VinMax | 8.0 V | Maximum input voltage
4. VinMin | 5.5 V | Minimum input voltage
5. Vout | 6.0 V | Output Voltage
6. Vout1 | 6.0 Volt | Output Voltage #1
7. base_pn | LM3488 | Base Product Number
8. source | DC | Input Source Type
9. Ta | 30.0 degC | Ambient temperature

## Design Assistance

1. LM3488 Product Folder : http://www.ti.com/product/lm3488 : contains the data sheet and other resources.

Texas Instruments' WEBENCH simulation tools attempt to recreate the performance of a substantially equivalent physical implementation
of the design. Simulations are created using Texas Instruments' published specifications as well as the published specifications of other device manufacturers. While Texas Instruments does update this information periodically, this information may not be current at the time the simulation is built. Texas Instruments does not warrant the accuracy or completeness of the specifications or any information contained therein. Texas Instruments does not warrant that any designs or recommended parts will meet the specifications you entered, will be suitable for your application or fit for any particular purpose, or will operate as shown in the simulation in a physical implementation. Texas Instruments does not warrant that the designs are production worthy.
You should completely validate and test your design implementation to confirm the system functionality for your application prior to production.
Use of Texas Instruments' WEBENCH simulation tools is subject to Texas Instruments' Site Terms and Conditions of Use. (http://www.ti.com/corp/docs/legal/termsofuse.shtml) Prototype boards based on WEBENCH created designs are provided AS IS without warranty of any kind for evaluation and testing purposes and are subject to the terms of the Evaluation License Agreement. (http://www.ti.com/corp/docs/legal/termsofuse_estore.shtml)
