ARoS-NCSU/WolfBot-Hardware/boards/peripheral/rfboard.brd

## EAGLE design boards/peripheral/rfboard.brd (2013-10-22)

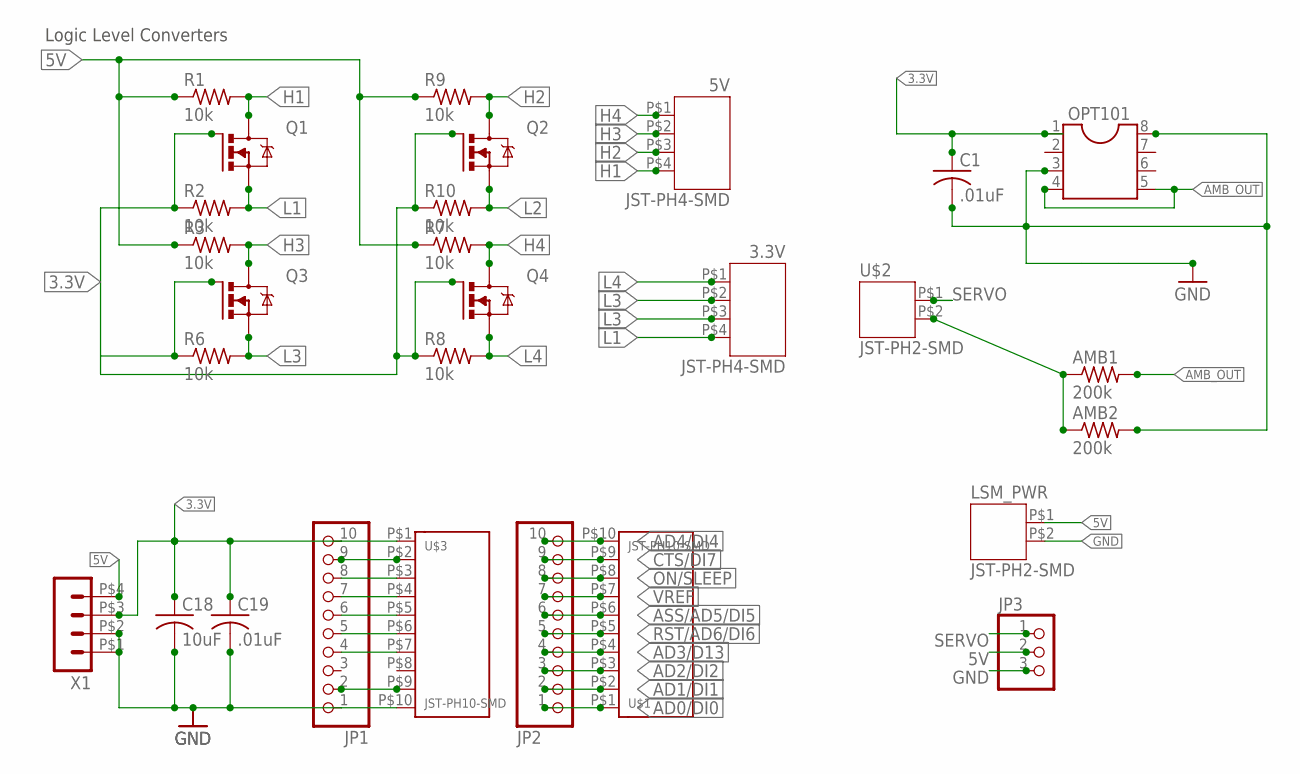
[picture p69: schematic rfboard.sch]

Parts:
3.3V, 5V: JST-PH4-SMD
AMB1, AMB2: 200k; R0805
C1, C19: .01uF; C0805K
C18: 10uF; C1206K
JP1, JP2: PINHD-1X10_2.00; 1X10M
JP3: PINHD-1X3; 1X03
LSM_PWR: JST-PH2-SMD
OPT101: DIL8; DIL08
Q1, Q2, Q3, Q4: IRLML5203; MICRO3
R1, R2, R3, R6, R7, R8, R9, R10: 10k; R0805
U$1, U$3: JST-PH10-SMD
U$2: JST-PH2-SMD
X1: HEADER_POS4_43045-0406; 43045-0406

Connections:
3.3V: C1.1, C18.1, C19.1, JP1.10, OPT101.1, Q1.1 (G), Q2.1 (G), Q3.1 (G), Q4.1 (G), R2.1, R6.1, R8.1, R10.1, U$3.P$1, X1.P$3 (3)
5V: JP3.2, LSM_PWR.P$1 (1), R1.1, R3.1, R7.1, R9.1, X1.P$4 (4)
AD0/DI0: JP2.1, U$1.P$1
AD1/DI1: JP2.2, U$1.P$2
AD2/DI2: JP2.3, U$1.P$3
AD3/D13: JP2.4, U$1.P$4
AD4/DI4: JP2.10, U$1.P$10
AMB_LOW: AMB1.1, AMB2.1, U$2.P$2 (2)
AMB_OUT: AMB1.2, OPT101.4, OPT101.5
ASS/AD5/DI5: JP2.6, U$1.P$6
CTS/DI7: JP2.9, U$1.P$9
DIN/CONFIG: JP1.8, U$3.P$3
DO8: JP1.7, U$3.P$4
DOUT: JP1.9, U$3.P$2
DTR/SLEEP_RQ/D18: JP1.2, U$3.P$9
GND: AMB2.2, C1.2, C18.2, C19.2, JP1.1, JP3.3, LSM_PWR.P$2 (2), OPT101.3, OPT101.8, U$3.P$10, X1.P$1 (1), X1.P$2 (2)
H1: 5V.P$4 (4), Q1.3 (D), R1.2
H2: 5V.P$3 (3), Q2.3 (D), R9.2
H3: 5V.P$2 (2), Q3.3 (D), R3.2
H4: 5V.P$1 (1), Q4.3 (D), R7.2
L1: 3.3V.P$4 (4), Q1.2 (S), R2.2
L2: 3.3V.P$3 (3), Q2.2 (S), R10.2
L3: 3.3V.P$2 (2), Q3.2 (S), R6.2
L4: 3.3V.P$1 (1), Q4.2 (S), R8.2
ON/SLEEP: JP2.8, U$1.P$8
PWM0/RSSI: JP1.5, U$3.P$6
PWM1: JP1.4, U$3.P$7
RESET: JP1.6, U$3.P$5
RST/AD6/DI6: JP2.5, U$1.P$5
SERVO: JP3.1, U$2.P$1 (1)
VREF: JP2.7, U$1.P$7

Notes on the sheet:
Logic Level Converters

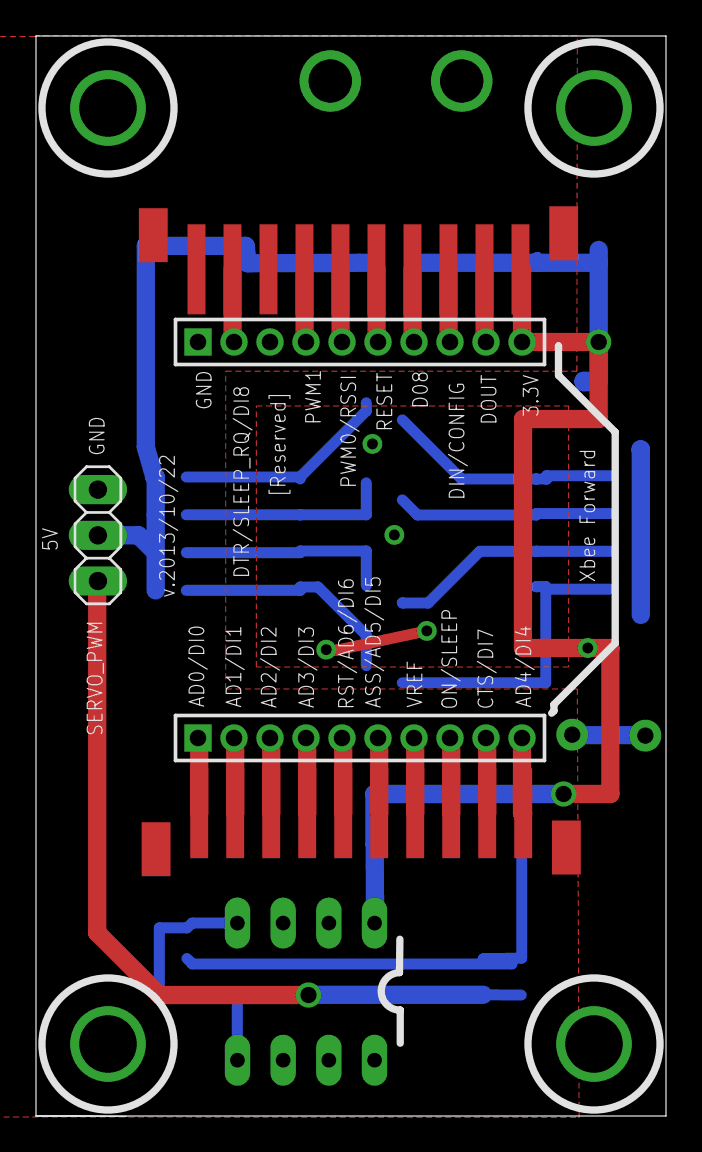
[picture p70: board rfboard.brd from above]

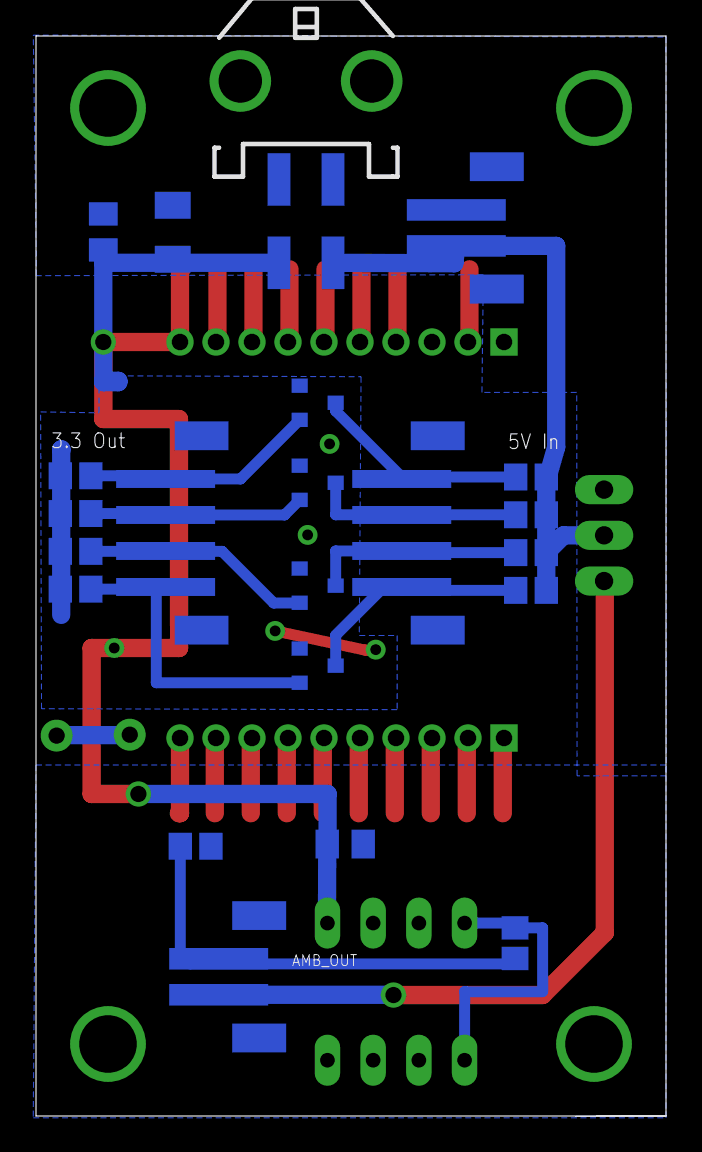
[picture p71: board rfboard.brd from below]

Board: 2 copper layers, 35.0 x 60.0 mm, 28 parts (22 on the bottom side), 31 nets.
