ARoS-NCSU/WolfBot-Hardware/boards/motor/h-bridge.brd

## EAGLE design boards/motor/h-bridge.brd (2013-10-22)

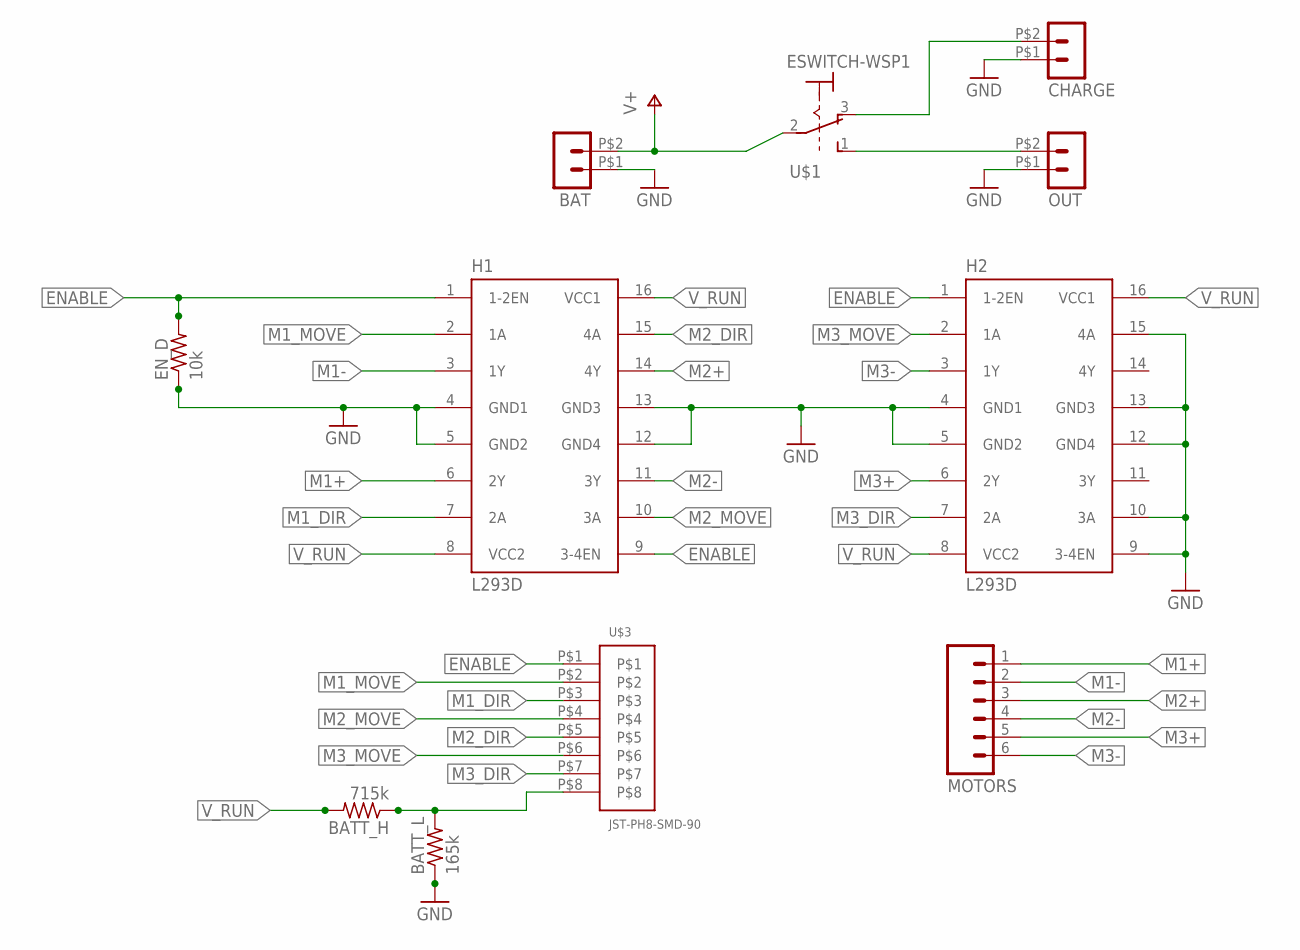
[picture p72: schematic h-bridge.sch]

Parts:
BAT: HEADER_POS2_43045-0206; 43045-0206
BATT_H: 715k; R0805
BATT_L: 165k; R0805
CHARGE: HEADER_POS2_43045-0206; 43045-0206
EN_D: 10k; R0805
H1, H2: L293D; DIL16
MOTORS: M06LOCK; 1X06_LOCK
OUT: HEADER_POS2_43045-0206; 43045-0206
U$1: ESWITCH-WSP1; WSP1-T2-M6
U$3: JST-PH8-SMD-90; JST-PH-SMD-90*

Connections:
ENABLE: EN_D.2, H1.1 (1-2EN), H1.9 (3-4EN), H2.1 (1-2EN), U$3.P$1
GND: BAT.P$1 (1), BATT_L.1, CHARGE.P$1 (1), EN_D.1, H1.4 (GND1), H1.5 (GND2), H1.12 (GND4), H1.13 (GND3), H2.4 (GND1), H2.5 (GND2), H2.9 (3-4EN), H2.10 (3A), H2.12 (GND4), H2.13 (GND3), H2.15 (4A), OUT.P$1 (1)
M1+: H1.6 (2Y), MOTORS.1
M1-: H1.3 (1Y), MOTORS.2
M1_DIR: H1.7 (2A), U$3.P$3
M1_MOVE: H1.2 (1A), U$3.P$2
M2+: H1.14 (4Y), MOTORS.3
M2-: H1.11 (3Y), MOTORS.4
M2_DIR: H1.15 (4A), U$3.P$5
M2_MOVE: H1.10 (3A), U$3.P$4
M3+: H2.6 (2Y), MOTORS.5
M3-: H2.3 (1Y), MOTORS.6
M3_DIR: H2.7 (2A), U$3.P$7
M3_MOVE: H2.2 (1A), U$3.P$6
unnamed: BATT_H.1, BATT_L.2, U$3.P$8
V+: BAT.P$2 (2), U$1.2
V_CHARGE: CHARGE.P$2 (2), U$1.3
V_RUN: BATT_H.2, H1.8 (VCC2), H1.16 (VCC1), H2.8 (VCC2), H2.16 (VCC1), OUT.P$2 (2), U$1.1

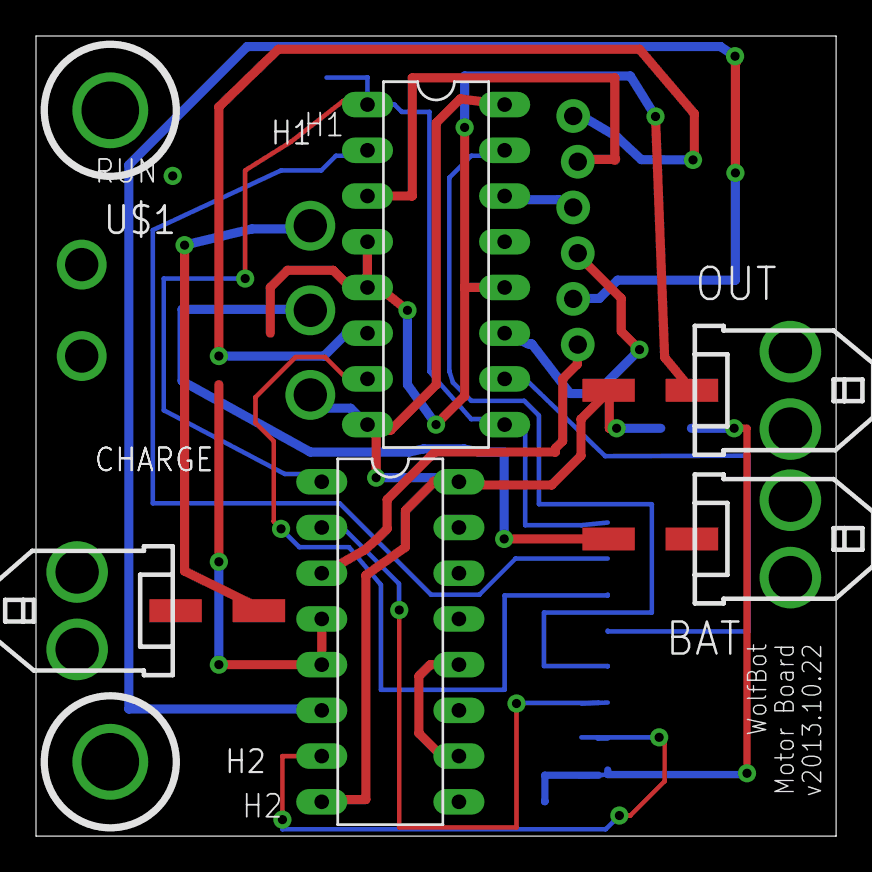
[picture p73: board h-bridge.brd from above]

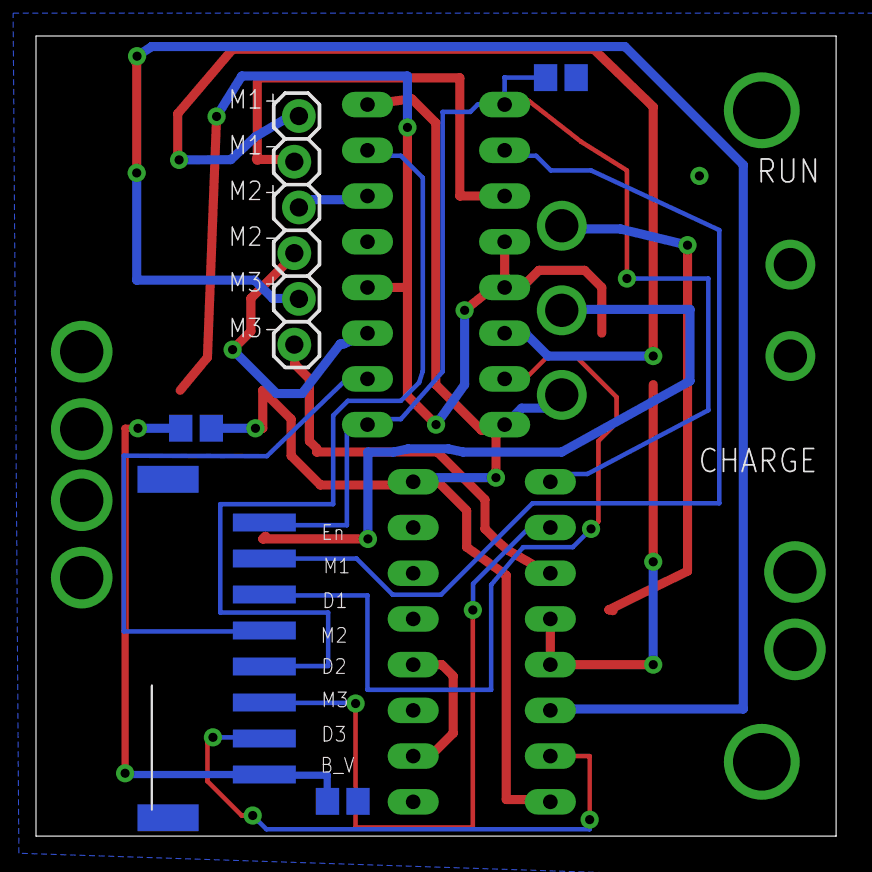
[picture p74: board h-bridge.brd from below]

Board: 2 copper layers, 44.5 x 44.5 mm, 11 parts (5 on the bottom side), 18 nets.
