ARoS-NCSU/WolfBot-Hardware/boards/power/powerboard.brd

## EAGLE design boards/power/powerboard.brd (2013-09-26)

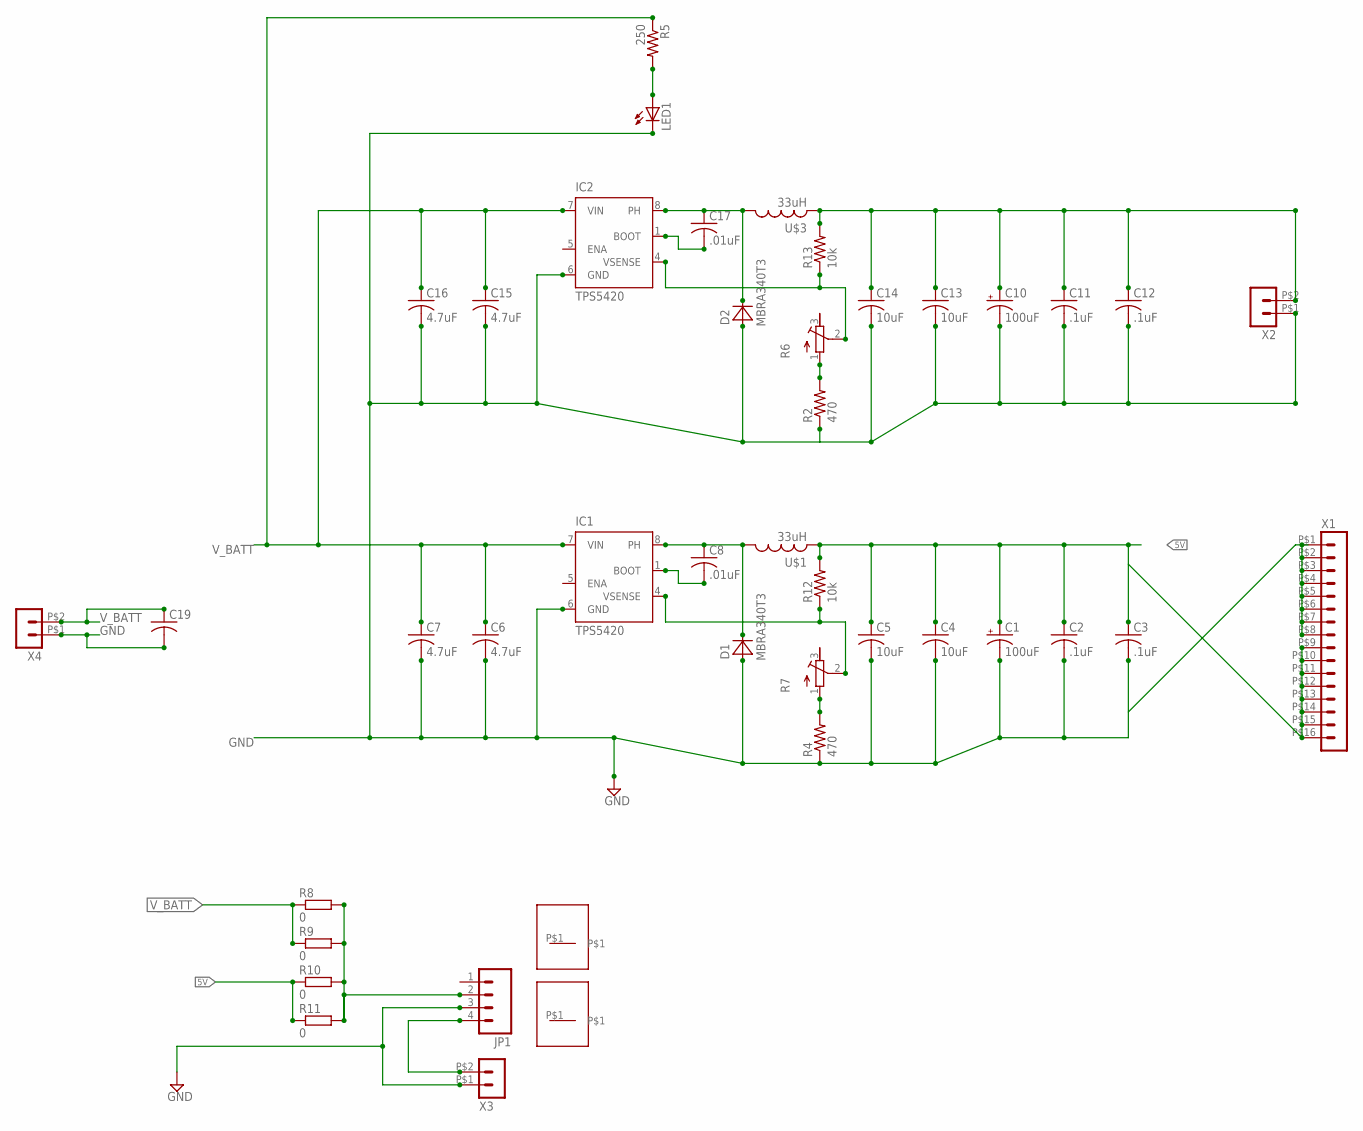
[picture p75: schematic powerboard.sch]

Parts:
C1, C10: 100uF; C/6032-28R
C2, C3, C11, C12: .1uF; C1206K
C4, C5, C13, C14: 10uF; C1206K
C6, C7, C15, C16: 4.7uF; C1812K
C8, C17: .01uF; C0805K
C19: C-USC2220K; C2220K
D1, D2: MBRA340T3; SMA
IC1, IC2: TPS5420; D_R-PDSO-G08
JP1: M04LOCK; 1X04_LOCK
LED1: LEDSML1206; SML1206
R2, R4: 470; R3216
R5: 250; R1206
R6, R7: R-TRIMM3224W; RTRIM3224W
R8, R9, R10, R11: 0; R0805
R12, R13: 10k; M0805
U$1, U$3: 33uH; MSS1260
U$2, U$4: THERMAL_PAD
X1: HEADER_POS16_43045-1606; 43045-1606
X2, X3, X4: HEADER_POS2_43045-0206; 43045-0206

Connections:
3_3V: C10.+, C11.1, C12.1, C13.1, C14.1, R13.2, U$3.P$2, U$3.P$4, X2.P$2 (2)
5V: C1.+, C2.1, C3.1, C4.1, C5.1, R10.1, R11.1, R12.2, U$1.P$2, U$1.P$4, X1.P$9 (9), X1.P$10 (10), X1.P$11 (11), X1.P$12 (12), X1.P$13 (13), X1.P$14 (14), X1.P$15 (15), X1.P$16 (16)
6VOUT: JP1.4, X3.P$2 (2)
GND: C1.-, C2.2, C3.2, C4.2, C5.2, C6.2, C7.2, C10.-, C11.2, C12.2, C13.2, C14.2, C15.2, C16.2, C19.2, D1.A, D2.A, IC1.6 (GND), IC2.6 (GND), JP1.3, LED1.C, R2.1, R4.1, X1.P$1 (1), X1.P$2 (2), X1.P$3 (3), X1.P$4 (4), X1.P$5 (5), X1.P$6 (6), X1.P$7 (7), X1.P$8 (8), X2.P$1 (1), X3.P$1 (1), X4.P$1 (1)
unnamed: C8.2, IC1.1 (BOOT)
unnamed: IC1.4 (VSENSE), R7.2 (S), R12.1
unnamed: C8.1, D1.C, IC1.8 (PH), U$1.P$1, U$1.P$3
unnamed: C17.2, IC2.1 (BOOT)
unnamed: IC2.4 (VSENSE), R6.2 (S), R13.1
unnamed: C17.1, D2.C, IC2.8 (PH), U$3.P$1, U$3.P$3
unnamed: LED1.A, R5.2
unnamed: R2.2, R6.1 (A)
unnamed: R4.2, R7.1 (A)
VIN: JP1.2, R8.2, R9.2, R10.2, R11.2
V_BATT: C6.1, C7.1, C15.1, C16.1, C19.1, IC1.7 (VIN), IC2.7 (VIN), R5.1, R8.1, R9.1, X4.P$2 (2)

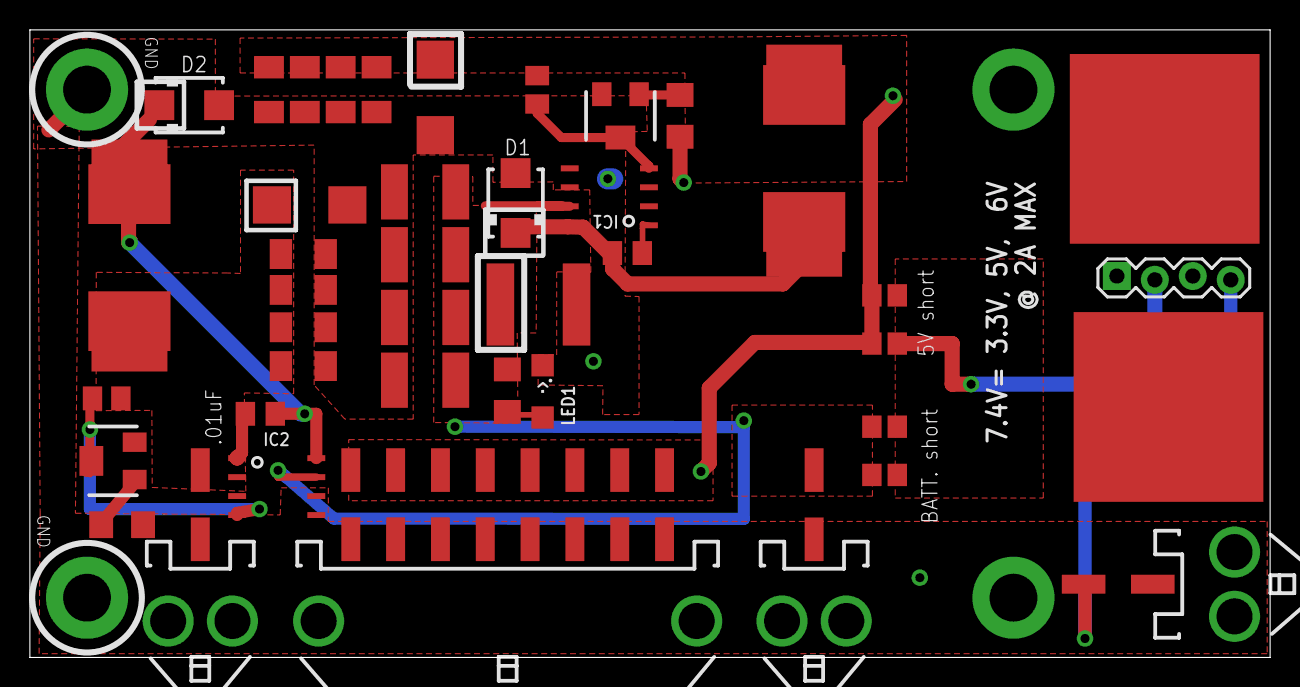
[picture p76: board powerboard.brd from above]

Board: 2 copper layers, 83.0 x 42.0 mm, 42 parts (0 on the bottom side), 15 nets.
