ARoS-NCSU/WolfBot-Hardware/boards/dms/dms_sensor_board.brd

## EAGLE design boards/dms/dms_sensor_board.brd (2013-09-26)

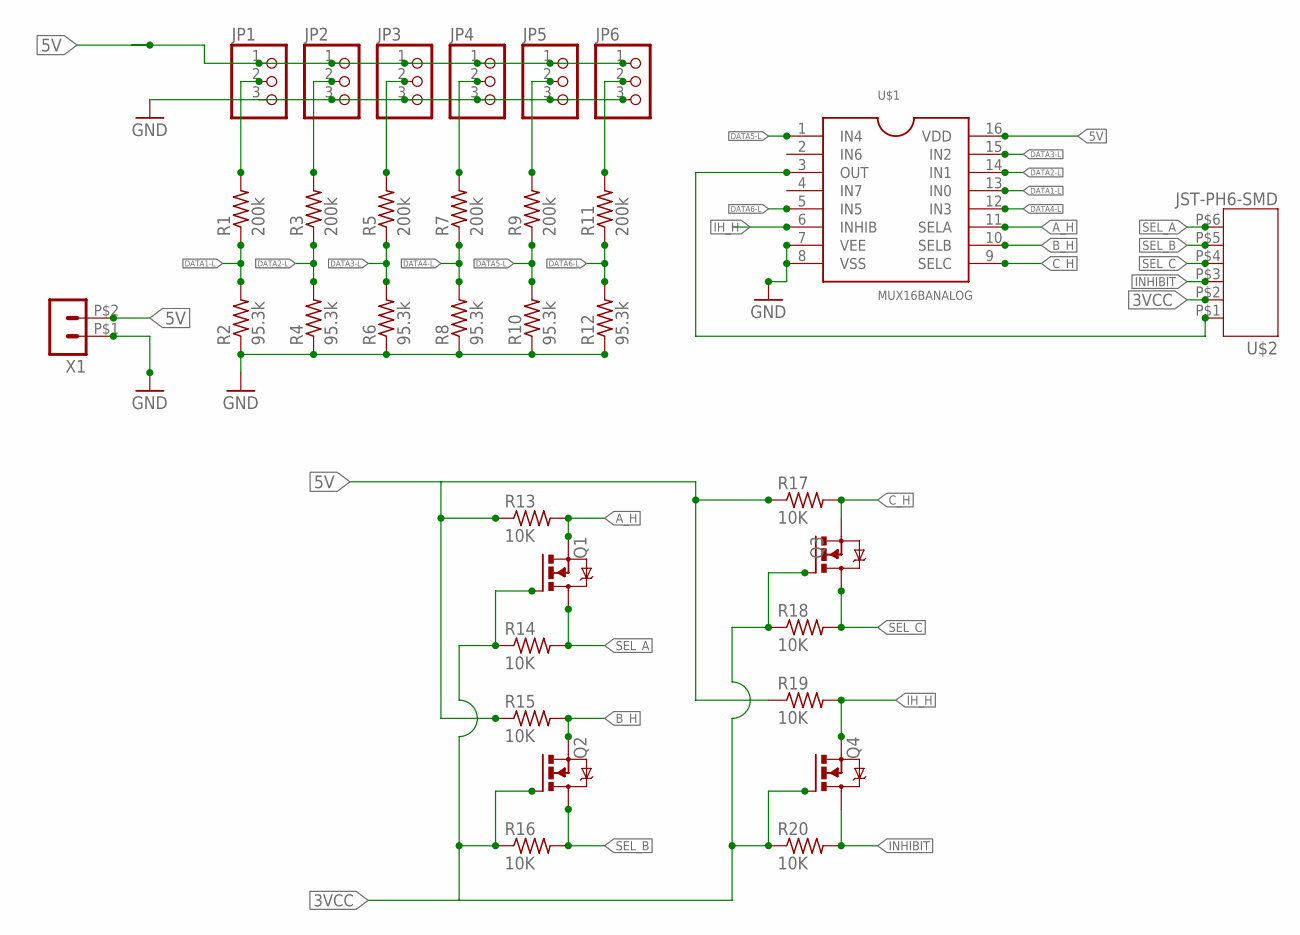
[picture p77: schematic dms_sensor_board.sch]

Parts:
JP1, JP2, JP3, JP4, JP5, JP6: PINHD-1X03_2.00; 1X03M
Q1, Q2, Q3, Q4: IRLML5203; MICRO3
R1, R3, R5, R7, R9, R11: 200k; R0805
R2, R4, R6, R8, R10, R12: 95.3k; R0805
R13, R14, R15, R16, R17, R18, R19, R20: 10K; R0805
U$1: MUX16BANALOG; SO16
U$2: JST-PH6-SMD
X1: HEADER_POS2_43045-0206; 43045-0206

Connections:
3VCC: Q1.1 (G), Q2.1 (G), Q3.1 (G), Q4.1 (G), R14.1, R16.1, R18.1, R20.1, U$2.P$2 (2)
5V: JP1.1, JP2.1, JP3.1, JP4.1, JP5.1, JP6.1, R13.1, R15.1, R17.1, R19.1, U$1.16 (VDD), X1.P$2 (2)
A_H: Q1.2 (S), R13.2, U$1.11 (SELA)
B_H: Q2.2 (S), R15.2, U$1.10 (SELB)
C_H: Q3.2 (S), R17.2, U$1.9 (SELC)
DATA1-H: JP1.2, R1.2
DATA1-L: R1.1, R2.2, U$1.13 (IN0)
DATA2-H: JP2.2, R3.2
DATA2-L: R3.1, R4.2, U$1.14 (IN1)
DATA3-H: JP3.2, R5.2
DATA3-L: R5.1, R6.2, U$1.15 (IN2)
DATA4-H: JP4.2, R7.2
DATA4-L: R7.1, R8.2, U$1.12 (IN3)
DATA5-H: JP5.2, R9.2
DATA5-L: R9.1, R10.2, U$1.1 (IN4)
DATA6-H: JP6.2, R11.2
DATA6-L: R11.1, R12.2, U$1.5 (IN5)
GND: JP1.3, JP2.3, JP3.3, JP4.3, JP5.3, JP6.3, R2.1, R4.1, R6.1, R8.1, R10.1, R12.1, U$1.7 (VEE), U$1.8 (VSS), X1.P$1 (1)
IH_H: Q4.2 (S), R19.2, U$1.6 (INHIB)
INHIBIT: Q4.3 (D), R20.2, U$2.P$3 (3)
unnamed: U$1.3 (OUT), U$2.P$1 (1)
SEL_A: Q1.3 (D), R14.2, U$2.P$6 (6)
SEL_B: Q2.3 (D), R16.2, U$2.P$5 (5)
SEL_C: Q3.3 (D), R18.2, U$2.P$4 (4)

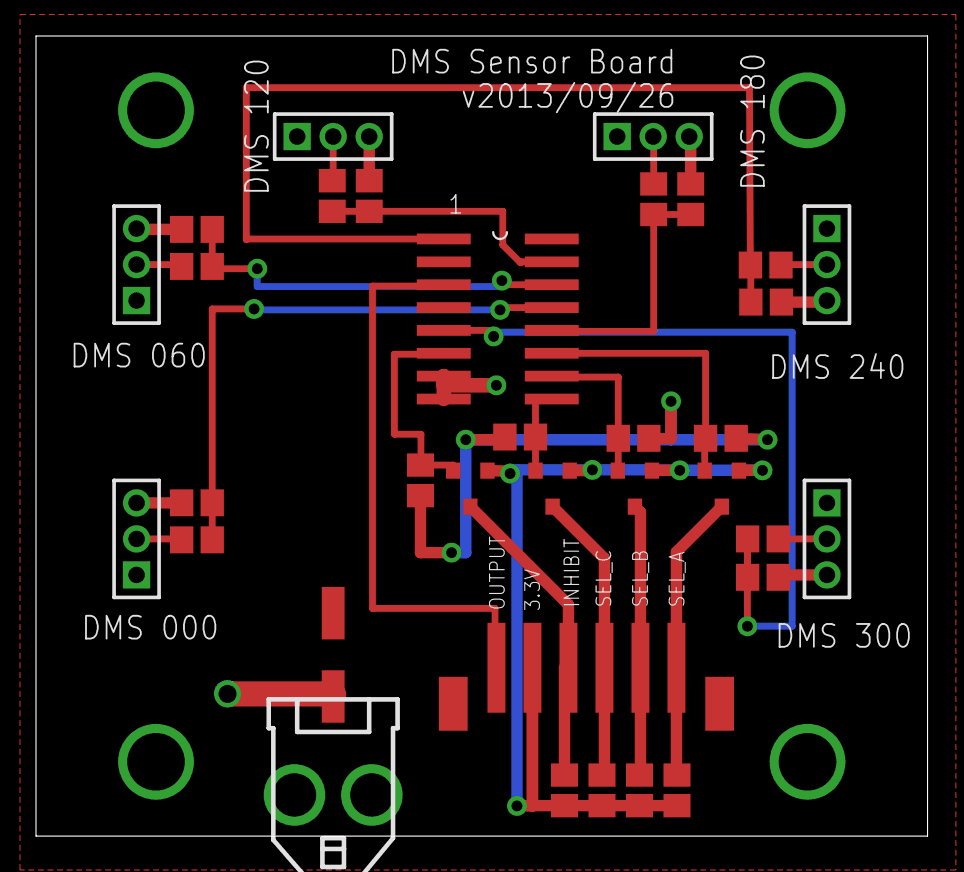
[picture p78: board dms_sensor_board.brd from above]

Board: 2 copper layers, 49.5 x 44.5 mm, 33 parts (0 on the bottom side), 24 nets.
