ARoS-NCSU/WolfBot-Hardware/boards/usb/usb.brd

## EAGLE design boards/usb/usb.brd (2013-08-13)

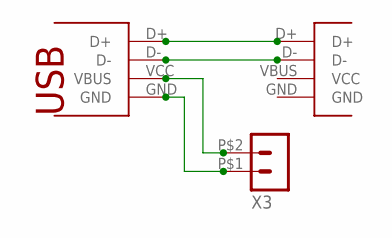
[picture p79: schematic usb.sch]

Parts:
U$1: USB-A_FEM; USB-A-S
U$2: USB-A-PLUG; USB-A-H
X3: HEADER_POS2_43045-0206; 43045-0206

Connections:
D+: U$1.D+, U$2.D+
D-: U$1.D-, U$2.D-
GND: U$1.GND, X3.P$1 (1)
VCC: U$1.VCC (VBUS), X3.P$2 (2)

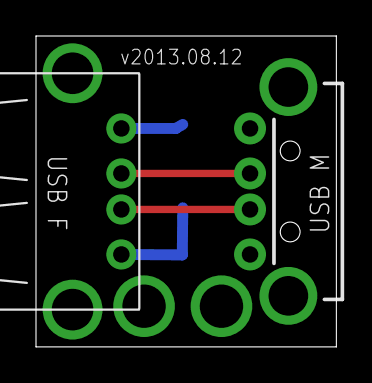
[picture p80: board usb.brd from above]

Board: 2 copper layers, 16.7 x 17.3 mm, 3 parts (1 on the bottom side), 4 nets.
