ARoS-NCSU/WolfBot-Hardware/(commit log)

2013-05-27 Initial revision of H-bridge schematic and board
    - current switch does not use the correct footprint
    - drill holes have not been verified
    [h-bridge.brd, h-bridge.sch]
2013-05-28 Rework H-bridge to add charge port, move headers to back
    - correct hole sizes and placement
    - added key dimension documentation
    - switch toggles battery between circuit and charge port
    - headers on backside leading toward center of chassis
    - battery in and daisy chain output also point into center
    [h-bridge.brd, h-bridge.sch]
2013-05-28 Fix V_RUN net so that it is actually attached to ICs
    [h-bridge.brd, h-bridge.sch]
2013-05-30 Add WolfBot Eagle library
    - only includes E-Switch WSP1 toggle switch for now
2013-05-30 Update H-bridge board to use correct switch
    - The E-switch WSP1 is a custom model from the wolfbot.lbr library
    - Shifted most components due to the larger switch footprint
    [h-bridge.brd, h-bridge.sch]
2013-05-31 Commit of original RF/peripheral board Eagle files
    [rfboard.brd, rfboard.sch]
2013-05-31 changing the RF board to include voltage dividers
    - rearranged board to include pin headers
    [rfboard.brd, rfboard.sch]
2013-05-31 changed headers and finished board
    [rfboard.brd, rfboard.sch]
2013-05-31 created the zip for the gerber files
2013-05-31 Gerber files for RFboard
    [rfboard.gbl, rfboard.gbo, rfboard.gbs, rfboard.gto, rfboard.gts]
2013-05-31 Gerber zip file instructions
2013-05-31 Standard Eagle PCB construction instructions
2013-06-01 Reroute H-bridge board for conservative design rules
    - 20 mil drill holes
    - 20 mil power traces with 20 mil clearance
    [h-bridge.brd, h-bridge.sch]
2013-06-01 Cosmetic updates to h-bridge board
    - change fonts to vector
    - add board identifier and version string
    [h-bridge.brd]
2013-06-02 Add Eagle configruation files for DRC and CAM
    - SparkFun DRU, which should be sufficiently conservative
    - gerber_excellon: CAM used for previous boards
    - gerber_excellon_no_names: same as above, without tNames/bNames
    - script to generate zip file of gerbers ready for manufacture
2013-06-02 Makefile for gerber zip, git ignore many Eagle files
    - ignore backup files
    - ignore zips
    - ignore info files
    - ignore gerbers
2013-06-05 Changes to layout and silk screen, new gerber files
    [rfboard.brd, rfboard.sch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]
2013-06-05 corrected silk screen
    [rfboard.gto]
2013-06-05 Neal's custom gerber files, which use tsilk and bsilk layers
2013-06-05 Daniel's gerber file cam job.
2013-06-05 added version label
    [rfboard.brd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]
2013-06-06 Add missing stop mask to rfboard vias
    [rfboard.brd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]
2013-06-06 Panelization configuration for motor and peripheral boards
    - three row panelization using gerbmerge (7 of each board)
    - add border to "no names" CAM job
    - fix ngohara CAM job to use RS274X device for border
    [motor_and_periph.cfg]
2013-06-06 Fix type on gitmerge config, add .gitignore
    [motor_and_periph.cfg]
2013-06-09 added ambient light sensor and 3 voltage dividers, new XBEE connection
    -added the MONOLITHIC PHOTODIODE AND SINGLE-SUPPLY TRANSIMPEDANCE AMPLIFIER, ie OPT101 abmient light sensors
    -added circuitry for the OPT101
    -added header pin, labeled AMB_OUT, for the output of the OPT101
    -added three extra voltage dividers for future DMS sensors
    -added six 2mm 2pin headers for the DMS Sensors cables
    --NOTE: the DMS sensor headers are currently GND, VCC, DATA from left to right
    -changed XBEE connection to one 2mm 10pin header for new adaptor board
    -change circuitry for proper connections
    [rfboard.brd, rfboard.sch]
2013-06-09 created powerboard repository
    [POWERBOARD5V_ver2-redo.brd, POWERBOARD5V_ver2-redo.sch]
2013-06-18 I believe these are close to the Powerboard's design for 3.3V and 5V
    I made this using TI's WEBENCH software
2013-06-18 New boost design for 6Volt rail
    I made this using TI's WEBENCH software. The LM3488 is the voltage stepper chip used.
2013-06-18 A look at a 12volt rail. Not in use as of this commit.
2013-06-18 Added the 6volt rail to schematic. Board not done.
    [POWERBOARD5V_ver2-redo.brd, POWERBOARD5V_ver2-redo.sch]
2013-06-22 Flipped board on side to fit within EagleLite's size limits
    [POWERBOARD5V_ver2-redo.brd, POWERBOARD5V_ver2-redo.sch]
2013-06-22 Deleted TP1 and TP2 (test points) because they seem useless
    -Moved parts around to reduce footprint
    [POWERBOARD5V_ver2-redo.brd, POWERBOARD5V_ver2-redo.sch]
2013-06-24 Finished layout of power board with 6V.
    -Does not include new connectors for 3.3 and 5v rail yet
    [POWERBOARD5V_ver2-redo.brd, POWERBOARD5V_ver2-redo.sch]
2013-06-28 changing XBee pinout, and adding logic converters
    [rfboard.brd, rfboard.sch]
2013-06-29 changing logic converters and pinout
    [rfboard.brd, rfboard.sch]
2013-07-03 deleted AND circuit from RF board
    [rfboard.brd, rfboard.sch]
2013-07-03 small change in rf circuit
    [rfboard.sch]
2013-07-03 created basic six dms sensor circuit
    [dms_sensor_board.sch]
2013-07-03 added 8b mux and started pcb
    [dms_sensor_board.brd, dms_sensor_board.sch]
2013-07-03 added mosfet control over DMS ON
    [dms_sensor_board.brd, dms_sensor_board.sch]
2013-07-03 Finished dms sensor board layout, needs DRC
    [dms_sensor_board.brd, dms_sensor_board.sch]
2013-07-03 Added 2nd 56uF cap to powerboard, finished, needs DRC
    [POWERBOARD5V_ver2-redo.brd, POWERBOARD5V_ver2-redo.sch]
2013-07-04 Deleted voltage dividers, modified pinout
    [rfboard.brd, rfboard.sch]
2013-07-05 added voltage div to Amb_out, and amb_on fet
    [rfboard.brd, rfboard.sch]
2013-07-05 finished laying board with components on bottom
    [rfboard.brd, rfboard.sch]
2013-07-08 Fixed DMS_on fet with resistors and finished text
    [dms_sensor_board.brd, dms_sensor_board.sch]
2013-07-08 Fixed fet Amb_On with resistors, fixed connector orientation, fixed text
    [rfboard.brd, rfboard.sch]
2013-07-08 fixed fet, and fixed connector type
    [POWERBOARD5V_ver2-redo.brd, POWERBOARD5V_ver2-redo.sch]
2013-07-09 add connector parts
    [h-bridge.brd, h-bridge.sch]
2013-07-09 tested and fixed until passed Sparkfun's DRC
    [h-bridge.brd, h-bridge.sch]
2013-07-10 resolved Sparkfun DRC errors, except for in-between pin errors
    [POWERBOARD5V_ver2-redo.brd, POWERBOARD5V_ver2-redo.sch, dms_sensor_board.brd, dms_sensor_board.sch, rfboard.brd, rfboard.sch]
2013-07-10 mostly silkscreen fixes
    [POWERBOARD5V_ver2-redo.brd, dms_sensor_board.brd, dms_sensor_board.sch, h-bridge.brd, h-bridge.sch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]
2013-07-10 specific cam file for current boards
2013-07-10 Clean up of Eagle files and related scripts
    - Consistent makefiles for all boards
    - CAM files renamed tweaked to produce only necessary gerbers
    - delete generated gerbers
    - rename powerboard
    [powerboard.brd, powerboard.sch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]
2013-07-11 hole size, wire distance fixes, no soldermask changes yet
    [dms_sensor_board.brd, h-bridge.brd, rfboard.brd]
2013-07-11 changed all vias, except screw holes, to stop mask on
    [dms_sensor_board.brd, h-bridge.brd, powerboard.brd, rfboard.brd]
2013-07-12 Fixed PH connector footprint and resistor in way
    [h-bridge.brd, h-bridge.sch]
2013-07-12 Changed DMS holes to via to fix copper width error
    [dms_sensor_board.brd]
2013-07-13 Move all PCB schematic/board files into subdirectory
    [dms_sensor_board.brd, dms_sensor_board.sch, h-bridge.brd, h-bridge.sch, powerboard.brd, powerboard.sch, rfboard.brd, rfboard.sch]
2013-07-15 Initial commit of time sliced IR in Python
    - wolfbot class to hold configuration of individual bots
    - configuration files defining unique host ids and common IR parameters
    - slicer class provides time-slicing functionality
    - IR module for manipulating IR TX PWM and RX GPIO and pulse generation
2013-08-07 Changing boards for fet and text improvements
    [dms_sensor_board.brd, dms_sensor_board.sch, powerboard.brd, powerboard.sch, rfboard.brd, rfboard.sch]
2013-08-08 changes for new boards, cleared DRC
    [dms_sensor_board.brd, dms_sensor_board.sch, rfboard.brd]
2013-08-08 Move panelization config and update for all boards
    [gerbmerge.cfg]
2013-08-09 added documentation for new 6V rail
2013-08-09 fixed stopmask errors
    [dms_sensor_board.brd, rfboard.brd]
2013-08-10 New board for plugin regulator
    [powerboard.brd, powerboard.sch]
2013-08-10 text fixes
    [powerboard.brd]
2013-08-10 text change for V_batt resistors
    [h-bridge.brd, h-bridge.sch]
2013-08-10 fixed improper ground issue
    [rfboard.brd, rfboard.sch]
2013-08-12 Fix motor board silk screening
    - add tValues and bValues to CAM job
    - move resistor labels
    - remove unwanted labels
    [h-bridge.brd, h-bridge.sch]
2013-08-13 made usb breakout board
    [usb_board.brd, usb_board.sch]
2013-08-13 Reorganize USB board files, add makefile
    [usb.brd, usb.sch]
2013-08-13 Minor tweaks to USB board: wider, silkscreen
    - wider so male USB can be moved in for better support
    - added version stamp and tweaked other silk
    - labeled signal lines in schematic
    - added dimension layer to top silk in CAM job
    [usb.brd, usb.sch]
2013-08-13 Add USB board (x3) to full panel
    [gerbmerge.cfg]
2013-09-15 Fixed pull down, and three res sizes
    [h-bridge.brd, h-bridge.sch]
2013-09-15 Fixed Mux padsize, cleared relavent DRC errors
    [dms_sensor_board.brd, dms_sensor_board.sch]
2013-09-15 Fixed 470 cap footprint
    [powerboard.brd, powerboard.sch]
2013-09-15 Added LED indicator
    [powerboard.brd]
2013-09-26 Cleanup issues, working on powerboard res move
    [dms_sensor_board.brd, h-bridge.brd, powerboard.brd, rfboard.brd]
2013-09-26 moving pot
    [powerboard.brd]
2013-09-26 finished powerboard changes
    [powerboard.brd]
2013-09-26 changed resistors and fixed text
    [powerboard.brd, powerboard.sch]
2013-09-27 fixed PRF labels
    [rfboard.brd, rfboard.sch]
2013-10-21 changed size, moved holes, added servo header
    [rfboard.brd, rfboard.sch]
2013-10-21 fixed via short problem
    [h-bridge.brd]
2013-10-22 Break signal between motor board mounting holes
    [h-bridge.brd]
2013-10-22 Update motor board version label
    [h-bridge.brd]
2013-10-22 Update PRF board version label
    [rfboard.brd]
2013-10-29 Add wiring charts in SVG (and PDF generator)
2013-10-30 Wiring: Swap colors on multiple KRDs, extend servo power
2013-10-30 Wiring: extend PRF power lines slightly
2013-11-14 Mark III version of Wolfbot Solidworks Files
    [3-axis accelerometer LSM303DLHC.SLDPRT, Acrylic Base Type 0 - Level 0 Burn 7_16_13.SLDPRT, Acrylic Base Type 1 - Level 1 Burn FINAL.SLDPRT, Acrylic Base Type 1 - Level 2 - Circle Test Burn 7_16_13.SLDPRT, Acrylic Base Type 2 - IR Mount Burn FINAL.SLDPRT, Acrylic Base Type 2 - Xbee Mount Burn.SLDPRT, Battery.SLDPRT, Beaglebone.SLDPRT]
2013-11-14 Mark IV Version of Wolfbot.
    [3-axis accelerometer LSM303DLHC.SLDPRT, Acrylic Base Type 0 - Level 0.SLDPRT, Acrylic Base Type 1 - Level 1.SLDPRT, Acrylic Base Type 1 - Level 2.SLDPRT, Acrylic Base Type 2 - Level 2.SLDPRT, Battery.SLDPRT, Beaglebone.SLDPRT, DMS Board.SLDPRT]
2013-11-15 Wiring chart: extend BB to PB connector
2013-11-22 Construction Updates. Added media to Google Drive
    [DMS-Mount Assembly.SLDASM, Motor Bracket.SLDPRT, Robot Level 0 Assembly.SLDASM, Robot Level 1 Assembly.SLDASM, Robot Level 2 Assembly.SLDASM, Robot Total Assembly.SLDASM, Skinny Stand Off.SLDPRT]
2013-11-23 Remove assembly images that were moved to wiki repo
2014-02-19 Add SVG source for BBB P8/P9 connector label PDFs
